vutoan1110/RISC-V-Cache4KB/results/dm_reset_phase_hypothesis_20261010.md

# Current-gold reset phase bridge hypothesis

One hypothesis: once a settled reset establishes the recorded joint invariant `I(Q)`, that invariant is preserved across every reachable sampled synchronizer phase, including arbitrary external-reset deassertion and reassertion between completed clock steps of the exact raw gold Boolean model.

Let `m=lec_q_p19088`, `s=lec_q_p19089`, and `R(m,s) = (not s) OR m`. The reachable phase relation is `00`, `10` or `11`, with either value of sampled external `reset_n`. Check all six phases independently. The raw transition must prove `Dmeta=reset_n` and `Dsync=reset_n AND m`, without any joint-state premise. Those equations preserve R and map every starting synchronizer state to `00` after an asserted-reset sampled edge. A second sampled asserted edge uses the already universal, independently reviewed gold reset base to establish I. No unreset RAM, tags or register array is zero-initialized as an assumption.

For each reachable phase, I(Q) is exactly the frozen conjunction of 235 constant constraints, 28 duplicate equalities and four legal one-hot groups. All other raw Q and primary inputs remain arbitrary symbols. Prove all 235 constant closures, 28 duplicate closures and 23 legal-current-code group closures under that phase and I(Q). Each premise has an explicit satisfying assignment; witness completion with zero is not a state axiom. Current `01` is excluded only after the stated reset protocol has established R, not treated as an impossible power-on state without reset.

An interrupted reset may switch the sampled external reset value on every step. Closure of all six phases and R therefore covers any sampled reassertion/release sequence after the established base. This is a completed-clock-step statement about the existing Boolean graph after its recorded frontend transformations. It does not prove RTL asynchronous-reset events occurring between clock edges, X/Z initialization semantics, raw N1/final reset coupling, mapped boundary equivalence or full sequential LEC; those scopes remain OPEN.

The new proof process has a kernel-enforced 512 MiB limit. Each obligation has a 10-second deadline. Use only the frozen structural cofactor and exact CNF/resolution-certified solver, with its fixed variable/clause/decision/conflict/learning/resolution budgets. Limits are UNKNOWN. No model, RTL, frozen helper, live PD input, global setting or external frontend changes. Controls precede two independent CLI executions and include an actual raw-model rare 24-input synchronizer fault whose witness satisfies every joint premise. Independent review is required before promotion.
