vutoan1110/RISC-V-Cache4KB/results/m2/M1_M2_REPORT.md

# Review items M1 and M2: controller confound and cache design-space sweep

Status 2026-10-06: every sweep number is double-executed -- R15 sweep pass 2 = pass 1 on every field (637/637
rows), R16 FAST_HIT sweep pass 2 = pass 1 (559/559 rows; no R16 checker message in any of the 1,131 FAST logs).
The R16 verification chain (45 checks, 0 failures), the formal checks (29, 0 failures) and Quartus x2 (9 fits,
pass 1 = pass 2) are complete (section 6). Final.

Numeric source: `results/m2/M1_M2_analysis.md` (generated by `scripts/m2/analyze_m2.py` from
`results/m2/sweep_p1.csv` and `results/m2/sweep_fast_p1.csv`). Every ratio is mcycle (total cycles), geometric
mean (GM) over the 12 upstream Embench-IoT kernels unless stated; CoreMark is reported on its own.

CoreMark validation boundary: these are repeatable full-program simulation counters with 32 KiB RAM, including
initialization and reporting. The harness does not gate PASS on upstream CRC validation; CoreMark comparisons
remain provisional functional evidence and are not official scores. Details: NHAT_KY.md section 9.

## 1. What the review asked

- M1: the published comparison (direct-mapped wins on 12/12 kernels) compares two different controllers. The DM
  point uses a five-state controller; SA2 and DM_VC4 use a ten-state DSE core whose main-array hit costs one
  extra cycle (ST_LOOKUP -> ST_HIT_RESP / ST_CPU_RESP). Controller cost must be separated from organisation.
- M2: one capacity and one line size is not a design space. Sweep capacity, line size, associativity and victim
  depth.

## 2. Method

- RTL: R15 (manifest d409b09d) for the base sweep; R16 (manifest c09143ea; hdl identical to ea3ef852) adds a
  parameter FAST_HIT to the DSE and N-way cores. With FAST_HIT = 1 a main-array hit is answered in ST_LOOKUP,
  so the DSE core's hit latency equals the DM controller's. FAST_HIT = 0 (default) is proved equivalent to R15
  (section 6).
- Organisations: DM (CACHE_CONFIG 0, five-state controller), DM_DSE (3: the DSE core used as a plain
  direct-mapped cache), SA2 (1), DM_VC4 (2, victim buffer), SA4 (4, N-way core, PLRU). Capacity = sets x ways x
  line bytes, identical for every organisation at a point.
- Grid (`scripts/m2/run_m2_sweep.py`): A = capacity 256 B .. 8 KiB x {DM, DM_DSE, SA2, VC4, SA4}, 16 B lines;
  B = 1 and 4 KiB x lines 8 / 32 B x {DM_DSE, SA2, VC4, SA4} (the DM controller supports 16 B lines only);
  C = 1 and 4 KiB x victim depth 2 / 8. 50 points x 13 workloads = 650 runs (R15); 44 points x 13 = 572 runs
  with FAST_HIT (DM has no FAST variant). SA4 at 256 B does not elaborate (4 sets < the L0's 3 index bits).
- Workloads: the 12 upstream Embench-IoT kernels (fw/up_*.hex) and CoreMark, BP on, L0 8 entries, RAM 16 KiB for the
  kernels. CoreMark runs in simulation with a 32 KiB backing RAM (IMEM_DEPTH = DMEM_DEPTH = 4096 words; `sw/coremark/coremark_link.ld` puts the stack at the top of 32 KiB): its -O2 rv32i_zmmul build needs .text 13,952 + .rodata 2,445 + .data 24 + .bss 2,020 bytes plus a 1 KiB stack, about 19.4 KiB, which does not fit the 16 KiB RAM. Caches and every other parameter are those of the 16 KiB SoC and the RAM latency does not depend on its depth, so the comparison between configurations is unaffected; CoreMark cannot run on the 16 KiB chip. (Correction 2026-10-08: this line said RAM 16 KiB for CoreMark too.)
  Every run passes the harness self-check and the counter invariants (exclusive hit/miss accounting).
- Every measurement twice (independent executions, separate log trees), compared field by field.
- Cross-check: the 4 KiB / 16 B rows of the sweep reproduce the frozen R15 chain results (65 rows, every field).

## 3. M1: the controller cost is real and grows with capacity

R15 decomposition, Embench GM (negative = faster):

| capacity | controller DM_DSE / DM | SA2 / DM_DSE | SA4 / DM_DSE | VC4 / DM_DSE | published-style SA2 / DM |
|---:|---:|---:|---:|---:|---:|
| 256 B | +4.33 % | -5.29 % | n/a | +5.97 % | -1.19 % |
| 512 B | +5.58 % | -6.75 % | -8.64 % | +4.53 % | -1.55 % |
| 1 KiB | +6.93 % | -2.98 % | -4.78 % | +3.32 % | +3.74 % |
| 2 KiB | +8.86 % | -0.70 % | -1.44 % | +2.10 % | +8.10 % |
| 4 KiB | +9.83 % | -0.26 % | -0.07 % | +1.03 % | +9.55 % |
| 8 KiB | +10.83 % | -0.16 % | -0.17 % | +0.01 % | +10.65 % |

The extra hit cycle costs more as the cache grows, because hits dominate once misses are rare. At the published
4 KiB point the controller accounts for +9.8 % and the organisation for -0.3 %: "DM beats SA2" was a controller
result. Below 1 KiB set associativity wins even on the slower controller.

R16 removes the extra hit cycle. Residual difference DM_DSE_fast vs DM: +1.09 % (256 B), +0.79 %, +0.15 %,
+0.11 %, +0.01 % (4 KiB), 0.00 % (8 KiB); cycle-identical on 5, 6, 9, 9, 12 and 13 of 13 workloads. The residual
is in the D-cache only (the two D$ controllers differ in the L0 and in store-miss handling: d_main / d_miss differ,
every I$ counter is equal), e.g. up_matmult-int at 4 KiB: 6 more D$ misses, +0.096 %.

Organisation on ONE controller with DM's hit latency, GM(X_fast / DM_DSE_fast):

| capacity | SA2 | SA4 | VC4 | CoreMark SA2 | CoreMark SA4 | CoreMark VC4 |
|---:|---:|---:|---:|---:|---:|---:|
| 256 B | -5.74 % | n/a | +5.99 % | -1.01 % | n/a | +2.23 % |
| 512 B | -7.43 % | -9.51 % | +4.61 % | -2.72 % | -3.99 % | -0.19 % |
| 1 KiB | -3.39 % | -5.56 % | +3.29 % | -1.18 % | -1.20 % | +0.31 % |
| 2 KiB | -0.86 % | -1.70 % | +2.04 % | -0.67 % | -0.71 % | +0.21 % |
| 4 KiB | -0.28 % | -0.09 % | +1.07 % | -0.53 % | -0.56 % | +0.17 % |
| 8 KiB | -0.18 % | -0.20 % | -0.01 % | -0.33 % | -0.33 % | +0.12 % |

With the controller matched, set associativity is faster than direct mapping in the GM at every capacity, on
Embench and on CoreMark; the gain is large below 2 KiB (3-10 %) and small at 4-8 KiB (0.1-0.6 %).

The GM hides large per-kernel effects in both directions. FAST orgs vs DM, wins / ties / losses over 13 workloads:
SA2 9/0/4 (256 B), 10/0/3, 7/0/6, 6/2/5, 6/4/3 (4 KiB), 3/9/1 (8 KiB); SA4 10/0/3 (512 B), 8/0/5, 7/2/4,
8/4/1, 4/9/0; VC4 3/0/10 ... 5/4/4 (4 KiB). At 4 KiB: up_nettle-sha256 +16.2 % (SA2) / +22.1 % (SA4), because
its instruction loop thrashes under LRU (I$ misses 3,414 DM -> 4,773 / 5,263); up_statemate -8.9 % (I$ misses
611 -> 2); up_matmult-int -4.5 / -4.7 %; up_ud -2.6 %. A paper statement must therefore be per-workload, not
"X beats Y".

## 4. Why DM_VC4 loses although it misses less

VC4 has the lowest miss rates of all organisations (e.g. 256 B: I$ 4.02 % vs 4.66 %, D$ 26.8 % vs 34.2 %, AXI
read beats -26 %) yet is the slowest. The cores copy the evicted line into the victim buffer BEFORE the refill
starts, one word per state (I$: ST_EVICT_READ + 4 x ST_EVICT_WRITE, about 5 cycles; D$: READ/WRITE per word,
about 8 cycles), on every miss to a valid line, and a victim hit pays a swap of the same length. Measured at 256 B
(FAST data, sums over 12 kernels): the I$ converts 8,632 misses into victim hits but its stall cycles grow by
278,890; the D$ converts 20,919 misses and its stall cycles are flat (+2,080). The I$ sees few victim hits per
miss, the D$ many. up_nettle-sha256 at 4 KiB has zero victim hits and the same 3,414 I$ misses as DM, and runs
+17.9 % slower: that is the eviction cost alone. This is a property of this micro-architecture (eviction
serialised with the refill instead of overlapping the AXI latency), not of victim caches in general.

## 5. M2: line size and victim depth

Line size, vs 16 B at the same capacity (Embench GM; CoreMark in brackets):

| capacity | org | 8 B, R15 controller | 8 B, FAST | 32 B, R15 controller | 32 B, FAST |
|---:|---|---:|---:|---:|---:|
| 1 KiB | DM_DSE | +19.18 % | +11.96 % (+1.53) | -2.47 % | +1.02 % (-0.31) |
| 1 KiB | SA2 | +20.87 % | +13.57 % (+1.78) | -4.97 % | -1.51 % (-0.93) |
| 1 KiB | SA4 | +20.46 % | +12.88 % (+1.74) | -6.55 % | -3.16 % (-0.91) |
| 1 KiB | VC4 | +20.03 % | +12.99 % (+1.66) | -1.34 % | +2.19 % (-0.49) |
| 4 KiB | DM_DSE | +21.54 % | +12.51 % (+1.61) | -8.64 % | -4.77 % (-0.88) |
| 4 KiB | SA2 | +21.81 % | +12.80 % (+1.66) | -9.18 % | -5.40 % (-1.00) |
| 4 KiB | SA4 | +21.90 % | +12.90 % (+1.67) | -9.21 % | -5.44 % (-1.00) |
| 4 KiB | VC4 | +21.49 % | +12.50 % (+1.70) | -8.58 % | -4.74 % (-0.98) |

32 B lines are better than the published 16 B at 4 KiB for every organisation (-4.7 to -5.4 % with the matched
controller); 8 B lines are clearly worse. The controller confound also distorts line-size conclusions: with the
extra hit cycle the 8 B penalty looks almost twice as large (+19-22 % instead of +12-13 %), because shorter lines
make the 8-entry L0 cover fewer bytes, so more accesses pay the main-array hit.

Victim depth (FAST, vs VC4): VC2 +2.58 % (1 KiB) / +0.23 % (4 KiB); VC8 -1.34 % / -0.45 %; CoreMark within
+/-0.33 %. Depth matters little next to the eviction cost of section 4.

Miss rates, AXI traffic and CPI for every organisation and capacity: `results/m2/M1_M2_analysis.md`.

## 6. Verification of the R16 change (rule D: the whole chain)

- Formal (Yosys equiv_make / equiv_simple -seq 2 / equiv_induct / equiv_status -assert, `asic/equiv/r16_eq`):
  icache and dcache x CACHE_CONFIG 1-4 x LINE_COUNT 64 / 256 with FAST_HIT 0 vs R15: 16/16 equivalent, 0
  unproven cells; negative controls FAST_HIT 1 (cfg 1 and 4, both caches, both sizes): 8/8 detected (66 unproven
  cells: rsp_valid and rsp_data of wrapper and core). SoC level, the exact PD inputs (R14 snapshot file lists)
  vs R16 at FAST_HIT 0: DM 35,067 / SA2 36,741 / DM_VC4 37,441 cells, all proven, 0 unproven -- the signed-off
  DM layout and every SA2 / DM_VC4 PD run represent R16 unchanged. (A first SoC attempt paired no cache register
  -- R15+ names the DSE core genblk1.g_dse, R14 g_dse -- and was stopped; the gate is now renamed, names only.)
  SoC negative control (SA2, FAST_HIT 1): after the same equiv_simple stage at which the FAST_HIT 0 proof was
  complete, 1,824 of 36,741 cells stay unproven.
- Sim-only per-cycle checker in each of the four cores; liveness shown by mutation: forcing a wrong recorded
  answer stops the simulation in 4/4 cores.
- New directed tests: tb_cache_configuration with FAST_HIT (incl. the SA2 main-hit latency: 1 cycle after the
  accepting edge without FAST_HIT, 0 with it), tb_cache_architecture_equivalence with FAST_HIT (SA2 / DM_VC4
  retire exactly what DM retires). Regression 161 PASS x2 (129 R15 + 32 FAST).
- Static: latch sweep 0 latches over 33 combinations (6 configs x 3 sizes x FAST_HIT 0/1 where it exists),
  lint_rtl 0 correctness warnings (33), lint_asic 0, OpenLane lint baseline 0 new warnings (R16 set == R15 set).
- Full chain (`scripts/run_fullchain_r16.sh`, `results/fullchain_r16.log`, 2026-10-06 09:54-15:14): 45 OK, 0 FAIL --
  manifest c09143ea identical at start and end; Embench 72 x2 and CoreMark 6 x2 identical to R15 on every field
  (FAST_HIT 0); FAST_HIT 60 + 5 runs x2, every non-timing counter equal to FAST_HIT 0, mcycle never larger (GM
  -8.9 to -9.0 % Embench, -2.5 to -2.6 % CoreMark at 4 KiB); random differential 50/50 x2 = R15 hashes; ASIC view
  x2 = R15, directed ISA 6/6, synchronisers x2; ramsweep x2; UVM 5/5 x2 and AXI 8/32/64 B x2; independent cache
  model EXACT on 48 + 24 runs (FAST_HIT 0) and 60 runs (FAST_HIT 1). Quartus x2 with the FAST points
  (`scripts/run_le_r16.sh`): 0 failures, pass 1 = pass 2 on all 9 fits (section 7).

## 7. Limits and open points

- FAST_HIT cost on the FPGA (Cyclone IV E, Quartus seed 2, pass 2 = pass 1 on every field of all 9 fits), FAST_HIT 0 -> 1:
  SA2 +456 LE, Fmax Slow-85C 53.71 -> 51.65 MHz (-3.8 %), +5.4 mW; DM_VC4 +115 LE, 54.90 -> 55.35 MHz, +3.6 mW;
  DM_DSE +345 LE, 53.69 -> 52.47 MHz (-2.3 %), +4.9 mW; SA4 +881 LE, 50.95 -> 52.76 MHz, +11.2 mW. Every point
  still closes 50 MHz at Slow 85C (worst setup slack +0.639 ns, SA2). One seed only: the R14 four-seed sweep put
  seed noise at up to 109 LE, and Fmax moves by a few percent between seeds, so only the SA2 / DM_DSE Fmax drops
  and the LE increases are likely real. At the fixed 50 MHz clock the cycle gains of section 3 are kept in full;
  at each point's own Fmax, SA2's -9.0 % cycles at 4 KiB shrink to about -5.3 % time (0.9103 x 53.71 / 51.65 = 0.9466). The FAST_HIT 0 points are
  identical to the R14 / R15 fits on all 115 recorded fields (runtime excepted). No ASIC build of a FAST point.
- The residual DM vs DM_DSE_fast difference (D$ L0 / store-miss policy) is not removed; it is <= 1.1 % and
  vanishes at 4-8 KiB.
- VC4's eviction is serialised with the refill; overlapping it with the AXI latency is the obvious fix and is not
  implemented.
- Single-issue in-order core, one memory system, 13 workloads; simulation only (no board available).
