vutoan1110/RISC-V-Cache4KB/report_page/soc_report.html

SoC RISC-V RV32I + Zmmul · Cyclone IV E (DE2-115) · sky130A

# Báo cáo tiến độ SoC RISC-V

So sánh bản nghiên cứu hiện tại với bản đã công bố: lỗi đã sửa, kiểm chứng, FPGA, hiệu năng, ASIC, cách đo từng phần và các phản biện còn mở. Viết cho người tham gia viết bài, để đọc độc lập mà không cần hỏi lại.

Cập nhật14/10/2026, 21:30 (giờ máy chạy)

Bản đã công bốE:\Projects\RISCV-AHB-APB-UART, commit a939d6f, GitHub vutoan1110/RISCV-AXI-APB-CACHE

Bản nghiên cứuE:\Projects\RISCV-research, nhánh experimental-r14, RTL R16 + register file và BHT trong M9K (manifest 6c4ccffd); PD: các bản đã ký đọc snapshot rtl_r14 (tương đương R16 với FAST_HIT 0); từ 14/10 21:12, theo quyết định của chủ dự án, mọi run PD đọc snapshot 6c4ccffd (rtl_rfbht)

Quy ước sốDấu chấm thập phân và dấu phẩy hàng nghìn, giống file nguồn tiếng Anh, để chép thẳng vào bài.

## 01Tóm tắt

Dung lượng

1 → 4 KiB

Cache mỗi phía; RAM chính 8 → 16 KiB. Thêm một quét không gian thiết kế 256 B đến 8 KiB.

Lỗi của bản cũ đã sửa

8

Gồm wrapper RAM của ASIC ghi sai địa chỉ, và vi phạm hold bị che vì lỗi SDC.

Kết luận "DM nhanh nhất"

+9.8 %

Phần chênh ở 4 KiB đến từ controller, không đến từ cách tổ chức cache. Khi khớp độ trễ hit, set-associative nhanh hơn ở mọi dung lượng.

FPGA, DM

−15.6 % LE

So với bản cũ 1 KiB (seed 2: 15,188 → 12,815 LE) dù cache lớn gấp 4: register file và BHT chuyển vào M9K, CPI không đổi. Mười seed chung × hai lượt: DM 12,800–12,842 LE, Fmax 52.27–56.18 MHz (Slow 85 °C).

ASIC đã ký: DM và SA2

2 / 3

DM 10.63 mm², SA2 11.56 mm²: DRC, LVS, XOR, antenna 0, setup ≥ 0 ở tt và ff, hold ≥ 0 ở 9 góc. DM_VC4 chưa ký.

Phản biện

10 / 20

10 đã giải quyết, 4 một phần (A2, A7, A9, m1), 6 chỉ còn việc viết bài.

Hạng mục | Trạng thái | Ghi chú ngắn
RTL, kiểm chứng, FPGA ở 4 KiB | Đã xong | Chuỗi đầy đủ 0 lỗi, mọi phép đo ×2. Mục 7, 8.
Quét không gian thiết kế (M1, M2) | Đã xong | 637 + 559 dòng, lần 2 trùng lần 1. Mục 10.2.
FPGA 10 seed chung × 2 lượt | Đã xong | 40 cặp dòng trùng 115 trường phần cứng. Mục 9.2.
Board DE2-115 | Một phần | 42 / 100 ca đo, tất cả khớp hai lượt tham chiếu RTL; còn 58 ca. Mục 12.9.
ASIC DM | Đã ký | 10.63 mm²; công suất exact-window 119.45 mW; LEC chứng minh, mọi tiền đề đã đóng. Lần chạy trọn nghiệm thu theo quy tắc Q: r3 dừng ở P2 vì crash ngẫu nhiên của tiến trình OpenLane; r4 (bản R14) dừng khi chủ dự án chuyển PD sang RTL 6c4ccffd; lần nghiệm thu DM trên 6c4ccffd chạy từ 14/10 21:12. Mục 11.1, 11.5.
ASIC SA2 | Đã ký | 11.56 mm²; công suất exact-window 129.64 mW; LEC hai lượt trùng nhau + mọi đối chứng âm. Cần lần chạy trọn nghiệm thu trên RTL 6c4ccffd (E1 hoặc E0). Mục 11.3.
ASIC DM_VC4 | Chưa ký | Route chính về 0 vi phạm nhưng vòng sửa antenna sau route không hội tụ; die 3800 µm (V4) cũng không giúp, đã dừng. Làm sau (chủ dự án) trên RTL 6c4ccffd với floorplan riêng. LEC phần tổng hợp (bản R14) xong hai lượt. Mục 11.4.
Viết lại bài (M3, A5, m2, m3, m6, m8) | Còn mở | Không thuộc phần đo đạc. Mục 14.

## 02Thuật ngữ

Các tên dưới đây xuất hiện trong mọi bảng. Tên cấu hình giữ nguyên như trong code và file kết quả.

DM

Cache ánh xạ trực tiếp, controller 5 trạng thái (CACHE_CONFIG 0).

SA2 / SA4

Set-associative 2 way / 4 way (1 / 4). SA2 chạy trên core DSE, SA4 trên core N-way (thay thế PLRU). SA4 chỉ có ở FPGA và mô phỏng.

DM_VC4

Ánh xạ trực tiếp kèm victim buffer 4 entry, chạy trên core DSE (2). Có một victim buffer ở I-cache và một ở D-cache.

DM_DSE

Core DSE dùng như cache ánh xạ trực tiếp thường (3). Dùng để tách chi phí controller ra khỏi cách tổ chức cache.

Core DSE

Controller 10 trạng thái dùng chung cho SA2, DM_VC4, DM_DSE. Mặc định mỗi hit ở mảng chính tốn hơn DM một chu kỳ.

FAST_HIT

Tham số mới CACHE_FAST_HIT (mặc định 0, tương đương RTL cũ). Bằng 1 thì core DSE và N-way trả lời hit ngay ở ST_LOOKUP, cùng độ trễ với DM.

L0

Bộ đệm nhỏ 8 entry ở I-cache, giữ các dòng vừa dùng.

View FPGA / ASIC / GLS

View FPGA: RTL với bộ nhớ FPGA, dùng để so sánh tổ chức cache. View ASIC: RTL với model SRAM OpenRAM, số chu kỳ thật của chip, ít hơn view FPGA 3–4 %. GLS: mô phỏng netlist đã ký tên, khớp view ASIC đến từng chu kỳ.

Góc tt / ff / ss

Typical 25 °C 1.80 V / fast −40 °C 1.95 V / slow 100 °C 1.60 V. Mỗi góc có 3 mức RC: min, nom, max, tổng 9 góc. Giới hạn ký tên: setup ≥ 0 ở tt và ff, hold ≥ 0 ở cả 9 góc. Góc ss chỉ báo cáo, không làm cổng.

LE

Logic element của Cyclone IV E. Mức 20,000 LE là mục tiêu mềm tự đặt.

DRC / LVS / antenna

Kiểm tra luật layout / so layout với netlist / hiệu ứng ăng-ten khi chế tạo. Bản ký tên phải bằng 0 ở cả ba.

V0–V5, E0 / E1, r14F, final3, ecomaxmin

Tên ngắn của các run PD, xem mục 03 Phiên bản và tên gọi.

LEC

Chứng minh hình thức rằng netlist cổng (sau tổng hợp và sau route) có cùng chức năng với RTL. Ở đây là LEC ánh xạ thanh ghi: so hàm trạng thái kế của từng flop đã ghép tên và mọi output.

N1

Netlist trung gian trước bước ABC của Yosys, tái tạo lại tiến trình tổng hợp của OpenLane trùng từng byte. Chuỗi chứng minh là RTL = RTL + fsm = N1 = netlist cuối.

Công suất theo hoạt động

GLS ghi lại hoạt động chuyển mạch thật (SAIF), rồi OpenSTA tính công suất với ký sinh RCX. Khác với "ước lượng của flow" (giả định tỉ lệ chuyển mạch mặc định).

SAIF

File hoạt động chuyển mạch (số lần chuyển mạch, thời gian ở 0 / 1 của từng net) ghi từ mô phỏng netlist.

Exact-window

Cửa sổ ghi SAIF dài đúng mcycle × 20 ns của vòng đo, mở / đóng bằng tín hiệu đóng băng bộ đếm đã chứng minh trên chính netlist.

EPI

Năng lượng mỗi lệnh = công suất × thời gian / số lệnh (minstret).

Chạy 2 lần (x2)

Mọi phép đo chạy độc lập hai lần và so từng trường. Lý do: có sai sót ngẫu nhiên không tái hiện; hai lượt độc lập trùng nhau mới dùng số.

Sàng lọc

Chạy thử một bước hoặc một phần để chọn giả thuyết; không phải kết quả.

Quy tắc Q

Sửa ngày 14/10/2026. Khi phát triển, được sửa và chạy tiếp từ bước lỗi; kết quả chỉ được nhận sau một lần chạy trọn từ bước 1 (không resume, không tách nhánh, ngưỡng khai báo lúc khởi chạy).

## 03Phiên bản và tên gọi

Mỗi tầng của dự án (RTL, phần mềm đo, FPGA, board, ASIC, LEC, công suất) có nhiều phiên bản; mỗi phiên bản đổi một điểm và có vấn đề riêng. Bảng dưới là tên thống nhất dùng trong trang, kèm tên gốc trong log / thư mục để tra cứu.

Trạng thái: đang dùng / đã ký đang chạy trượt / bỏ chuẩn bị. Chữ thường "lịch sử" là bản cũ, chỉ để tra cứu.

### 3.1 Quy ước

- Bản RTL gọi bằng 8 ký tự đầu của tổng SHA-256 manifest (scripts/rtl_manifest.py), ví dụ 6c4ccffd. R7…R16 là số đợt sửa trong nhật ký; một đợt có thể có nhiều manifest.
- PD chỉ đọc snapshot RTL đóng băng, không đọc hdl/. Các bản đã ký (r14F, ecomaxmin) và mọi run tới 14/10 đọc asic/snapshots/rtl_r14 (manifest 3ea52396). Từ 14/10 21:12 (quyết định của chủ dự án) PD đọc asic/snapshots/rtl_rfbht = manifest 6c4ccffd, đã kiểm trùng từng byte với cây mã hiện tại (44 file, hai lượt); tên run có mảnh rtl6c4c.
- Tên run PD: <cấu hình>_<floorplan>_<knob…>_r<n>; cấu hình dm / sa2 / vc4 (= DM_VC4). _r1 / _r2 = hai lần chạy độc lập cùng công thức (chạy kép); _r3 trở lên = chạy lại sau khi lần trước dừng.
- Tên ngắn: final_A/B, final3_A/B, r14F_A/B (DM); ecomaxmin, E0, E1 (SA2); V0–V5 (DM_VC4). Hậu tố A / B của run cũ = _r1 / _r2; "phương án A / B" của floorplan hành lang là 11.305 / 11.56 mm², không liên quan.
- Thư mục kết quả: results/<nội dung>_<YYYYMMDD>; p1 / p2 = lượt 1 / lượt 2.

### 3.2 Đọc tên run PD

Mảnh tên | Nghĩa
grid3665x2900, grid2800x2900 | Floorplan lưới của DM, die rộng × cao (µm)
ram8k | Bản RAM chính 8 KiB (trước 29/09)
corr3400x3400 | Floorplan hành lang dùng chung cho DM / SA2 / DM_VC4: hai hàng macro RAM ở dưới, macro mỗi cache thành cụm 2 × 2, dải logic ở giữa
f220 | Hàng macro cache phía trên lật (FS), khe 220 µm giữa hai hàng
capm20 | Biên tải khi sửa DRV sau global route 20 % (công thức DM: 50 %)
fo16 | MAX_FANOUT 16 (công thức DM: 8)
pad1 | Padding cell 1 site mỗi bên khi đặt cell
tdp | Đặt cell theo timing (PL_TIME_DRIVEN)
clkm3 | Dây clock chỉ dùng met3 trở lên
rsztf | Resizer chỉ tối ưu ở góc tt và ff, không đuổi theo ss
ecomin / ecomaxmin | ECO hold sau route trên ký sinh min_* / hai lượt: max_* rồi min_*
cts25 | CTS_SINK_CLUSTERING_SIZE 25 (mặc định OpenLane; DM dùng 8)
antoff | Tắt sửa antenna ở global route (chỉ sửa sau detailed routing)
antm10, antgrt10 | Sửa antenna ở global route, biên 10 %
nogrtt / nogrtd | Tắt sửa timing / sửa DRV sau global route
antcong | Cho phép nghẽn khi route lại trong vòng sửa antenna sau detailed routing; lưu kết quả route chính
mwl500 | Giới hạn dây 500 µm khi sửa DRV (mặc định resizer tự chọn 4,393 µm)
seco / secott | Thử ECO setup sau route (đã bỏ)
heurdiode / drtant | Diode chèn theo heuristic (cách cũ) / sửa antenna sau detailed routing
rtl6c4c | Đầu vào RTL là 6c4ccffd (snapshot rtl_rfbht); run không có mảnh này đọc rtl_r14

### 3.3 RTL

Tên | Ngày | Thay đổi | Vấn đề / kết quả | Trạng thái
Bản công bố 1 KiB | 16/09 | Repo công khai RISCV-AXI-APB-CACHE: cache I/D 1 KiB, RAM 8 KiB, chỉ FPGA, kernel tự viết | 8 lỗi (mục 05) | tham chiếu
1 KiB nghiên cứu (tên file cũ dedup / synccache / tagfix / sanitized) | 16–18/09 | Tham số hóa LINE_WORDS, lint Verilator -Wall, tag RAM đồng bộ cho cả 4 cache để đưa vào SRAM, PERF_COUNTERS_ENABLE | Số ablation đầu tiên sai (đã sửa); ASIC 1 KiB lớn hơn và nghẽn global route | lịch sử
4 KiB đầu tiên | 18–24/09 | Cache 4 KiB trên macro OpenRAM 32 × 256, L0 của I$ 8 entry, 12 macro | 2 latch thật trong netlist (Verilator báo 0), lỗi SDC create_clock; run ch4kb_full bị bỏ vì bộ nhớ ASIC còn lỗi | lịch sử
aa8e32f9 → b82c2717 → c235dfb7 (rtlfix) | 24–25/09 | Bỏ 2 latch rx_block; read-enable cho bank DSE; lỗi ghi AXI (bresp) ghi nhận sticky; UART RXDATA trả byte cũ nhất; UART tôn trọng pstrb (APB4); một SoC top cho ASIC; view ASIC lần đầu bắt 3 lỗi bộ nhớ ASIC (không biên dịch được trên Questa, sai địa chỉ ghi khi AW và W cùng chu kỳ: 91 / 115 lệnh ghi, SRAM không giữ giá trị đọc) | PD rtlfix_c235: setup nom_tt −0.272 ns, hold trượt ở ss từ uart_rx / key1_n | lịch sử
a0c425f8 (R8, sau gọi R17) | 25/09 | Đồng bộ 2 flop cho uart_rx, key1_n và nhả reset | PD r8_a0c4: nom_tt −0.569 ns; tìm ra đường nửa chu kỳ từ SRAM (dout ra ở sườn xuống) | lịch sử
358cb660 (R7a + R7b + R8) | 25/09 | Viết lại bộ cộng fetch, một bộ nhân có dấu 33 × 33 thay ba bộ 32 × 32, chân nguồn macro; CPI không đổi (chứng minh SAT / mô phỏng) | PD r7r8_358c: lần đầu đạt tt ở 50 MHz (+2.190 ns); ss −11.2 ns | lịch sử
ecf4fc03 → d030ad12 (R9–R11) | 26/09 | Thanh ghi hóa giải mã (forwarding, kiểu load), bit valid riêng cho L0 (hot_mvalid), keep trên bộ đếm hiệu năng (chỉ ASIC); CPI không đổi | ss vẫn âm; keep làm Quartus +17 % LE nên chỉ giữ cho ASIC | lịch sử
e21ef330 → 8b163675 (R12, R12b) | 26/09 | FPGA dùng select mã hóa (−145 LE, DM_VC4 dưới 20,000 LE), ASIC giữ one-hot | RTL của bản DM RAM 8 KiB đã ký (final3) | đóng băng cho bản 8 KiB
R13a / R13b | 28/09 | Thử RTL cycle-exact cho ss / bộ nhân 2 tầng | PD xấu hơn (max_ss −9.930 ns) / +1.03 % chu kỳ | bỏ
R14: 535ec0f9 → 3ea52396, 9b868f10 | 29–30/09 | RAM chính 8 → 16 KiB (ASIC 8 macro RAM, tổng 16 macro), chuyển sang 12 kernel Embench-IoT gốc; 9b868f10 bỏ kernel tự viết | Snapshot rtl_r14 = đầu vào PD của các bản đã ký (DM 10.63 mm², SA2 11.56 mm²) và mọi run DM_VC4 tới 14/10 | đầu vào PD cũ (tới 14/10)
R15 d409b09d | 30/09 | Core N-way (SA4, pseudo-LRU dạng cây), CACHE_CONFIG 4 / 5 | SA4 chỉ FPGA / mô phỏng; chip DM chứng minh tương đương R14 | dùng cho quét M2
R16 ea3ef852 → c09143ea | 03/10 | Tham số CACHE_FAST_HIT (mặc định 0 = R15, chứng minh tương đương) | Dùng cho M1; PD trên rtl_r14 vẫn đúng với FAST_HIT 0 | dùng cho M1
dcbf3495 | 08/10 | Register file và BHT vào M9K (chỉ FPGA), lần đóng băng đầu | Chuỗi kiểm 46 OK / 1 FAIL (lint_asic SYNCASYNCNET trong checker mô phỏng) | thay bằng 6c4ccffd
6c4ccffd | 08/10 | Như dcbf3495, sửa checker BHT (chỉ phần translate_off) | Chuỗi đầy đủ 0 lỗi; −2,630 đến −2,680 LE; netlist ASIC không đổi (tổng hợp DM trùng từng byte R16) | RTL hiện tại 227 file; đầu vào PD từ 14/10 21:12 (snapshot rtl_rfbht)

### 3.4 Phần mềm đo và kiểm chứng

Tên | Thời gian | Đặc điểm | Trạng thái
12 kernel tự viết | đến 29/09 | Kiểu Embench do dự án viết (bản công bố dùng; phản biện A6) | bỏ 30/09
12 kernel Embench-IoT gốc (09c2ed8c) | từ 29/09 | aha-mont64, crc32, depthconv, edn, huffbench, matmult-int, md5sum, nettle-sha256, slre, statemate, tarfind, ud; nguồn giữ nguyên trừ móc chỉnh số vòng; không phải điểm Embench chính thức | đang dùng
CoreMark quét ngắn | 09–10/10 | -O2, 1 vòng, RAM mô phỏng 32 KiB, 92 điểm có CRC | xong ×2
CoreMark chuẩn | 11/10 | -Os, 1,100 vòng, > 10 s, timer APB, 4 cấu hình; RAM mô phỏng 32 KiB | xong ×2
Regression testbench | 24/09 → 08/10 | 128 → 129 → 161 → 178 kiểm tra, thêm theo từng bản RTL | 178 / 178 ×2 trên 6c4ccffd
UVM | → 09/10 | 5 ca → 48 ca mỗi lượt (thêm AXI stress, UART RX, 4 cấu hình) | xong ×2
ACT4 | 02/10, lặp lại trên 6c4ccffd | 43 test (39 RV32I + 4 Zmmul) | xong ×2
Random differential + Spike | 09–11/10 | 50 seed; tham chiếu Spike độc lập | xong ×2
Probe | – | cachesweep (điểm gãy độ kết hợp), conflict probe mở rộng, ramsweep (kiểm cả 8 bank RAM) | công cụ đo

### 3.5 FPGA và board

Tên | Ngày | Đặc điểm | Trạng thái
4 seed × 2 lượt | 25/09 → 06/10 | Trên c235dfb7 … R16 (DM R16: 15,440 LE) | lịch sử
4 seed (rfbht) | 09/10 | 6c4ccffd; DM 12,810–12,842 LE | thay bằng 10 seed
10 seed chung × 2 lượt | 09/10 | 6c4ccffd, seed 1..10 chung cho 4 cấu hình (số ở mục 09) | đang dùng
36 SOF | 16/09 | Thiết kế bản công bố | lịch sử, không dùng
100 SOF seed 2 | 09/10 | 6c4ccffd, 25 firmware × 4 cấu hình, bộ đếm kỳ vọng gắn hash từng SOF | 42 / 100 khớp phiên 13/10, còn 58

### 3.6 ASIC DM

Tên trong trang | Run / thư mục | Ngày | Đặc điểm | Vấn đề / kết quả | Trạng thái
DM 1 KiB | dm_c1k_baseline (sync_final) | 18/09 | Cache 1 KiB, RAM 8 KiB, die 5.22 mm² | SDC thiếu clock uncertainty / IO; đo lại hold âm | mốc lịch sử
Run thăm dò 4 KiB | ch4kb_full, rtlfix_c235, r8_a0c4, r7r8_358c, r9_ecf4, r10A | 19–26/09 | PD trên từng bản RTL của đợt sửa | Tìm ra đường nửa chu kỳ SRAM và cách đóng tt | lịch sử
final_A / final_B | dm_ram8k_grid2800x2900_heurdiode_r1 / _r2 (_r3) | 27/09 | Bản ký tên RAM 8 KiB đầu tiên, diode heuristic | Antenna còn 140 net / 159 chân | thay bằng final3
final2_A | dm_ram8k_grid2800x2900_drtant_rc2 | 27/09 | Thêm hiệu chỉnh RC (LAYERS_RC) | ss và hold xấu hơn | bỏ
final3_A / final3_B | dm_ram8k_grid2800x2900_drtant_r1 / _r2 | 28/09 | Bỏ diode heuristic, sửa antenna sau detailed routing | Ký tên sạch, die 8.12 mm², 302 metric trùng, LEC chứng minh | golden RAM 8 KiB
f3_H1 / f3_H2 | …_hold002 / …_dens55_hold003_cts8 | 30/09 | Giảm buffer hold / mật độ 55 % | Cell −13 % nhưng max_ss xấu hơn | không nâng
r14_A, r14_E7 … E16 | dm_grid3665x2900 + knob | 29/09 | Quét knob cho RAM 16 KiB | E16 = công thức ký tên (config_R14_FINAL) | thí nghiệm
r14F_A / r14F_B | dm_grid3665x2900_r1 / _r2 | 02/10 | RAM 16 KiB, 16 macro, die 10.63 mm² | Ký tên sạch, 319 metric trùng, netlist trùng; bị dừng khi phiên làm việc kết thúc (30/09) và chạy tiếp 02/10 nên chưa đạt quy tắc Q | bản DM hiện tại, khóa
DM hành lang (dmuA / dmuB) | dm_corr3400x3325_f220_r1 / dm_corr3400x3400_f220_r1 | 06–07/10 | DM trên floorplan chung với SA2 / DM_VC4 | Ký tên sạch | chỉ để đối chứng cùng die
r3 | dm_grid3665x2900_r3 | 14/10 | Lần chạy trọn nghiệm thu | Dừng ở P2: crash ngẫu nhiên của tiến trình OpenLane sau bước 40 | thay bằng r4
r4 | dm_grid3665x2900_r4 | 14/10 | Lần chạy trọn nghiệm thu, cùng công thức và cổng | Qua P1 / P2 (setup nom_tt +1.725, hold +0.186). Netlist và mọi số trùng r14F tới bước 42, nhưng ở bước 41 hai buffer (wire10760, wire10761) đổi hướng S / FS: OpenROAD chọn hướng theo thứ tự phụ thuộc địa chỉ bộ nhớ (hiện tượng đã thấy từ 25/09). Vì vậy bước 43 sửa antenna ra 350 net / 6,249 diode thay vì 322 / 6,262 và layout khác r14F từ đó. Nghiệm thu bằng cổng ký tên và so PPA, không so hash. Dừng ở cổng detailed routing (14/10 21:11) khi chủ dự án chuyển PD sang RTL 6c4ccffd | dừng, thay bằng bản 6c4ccffd
DM 6c4ccffd | dm_grid3665x2900_rtl6c4c_r1 | 14/10 | Công thức ký tên DM (config_R14_FINAL_rtl6c4c.json: chỉ đổi danh sách file sang snapshot 6c4ccffd) | Lần chạy trọn nghiệm thu từ bước 1 (từ 21:12); sau khi ký: GLS, công suất exact-window và LEC trên layout này | đang chạy

### 3.7 ASIC SA2

Tên trong trang | Run / thư mục | Ngày | Đặc điểm | Vấn đề / kết quả | Trạng thái
sa2F_A / sa2F_B | – | 02/10 | SA2 trên lưới DM | Không route được (overflow 67,971) | bỏ
Lưới rộng / vòng / tầng | – | 03/10 | Sàng lọc floorplan | Lưới rộng route được nhưng nom_tt −17.573 ns (skew clock) | bỏ
sa2uA / sa2uB | sa2_corr3400x3325_f220_r1 / sa2_corr3400x3400_f220_r1 | 06–07/10 | Floorplan hành lang, knob của DM | 3325: detailed routing kẹt 173 vi phạm; 3400: hội tụ sau 54 vòng (5 giờ 43 phút), sửa antenna sau route chậm | bỏ chuyển sang knob riêng
capm20 + fo16 | sa2_corr3400x3400_f220_capm20_fo16_r1 | 07/10 | Biên tải 20 %, MAX_FANOUT 16 | −27 % buffer sau global route | giữ trong các bản sau
10.54 mm² | sa2_corr3400x3100_…_pad1_tdp_clkm3_r1 (+ seco, secott, rsztf) | 08–09/10 | Die nhỏ nhất đã thử | Route được nhưng max_tt −0.573 ns (đường đọc nửa chu kỳ SRAM way 1 của I$) | trượt
11.05 mm² | sa2_corr3400x3250_…_rsztf_r1 / _r2 | 10/10 | – | Trượt P2 cả hai lần (setup −0.332 ns) | trượt
11.305 mm² | sa2_corr3400x3325_…_rsztf_r1 | 11–13/10 | – | Route sau ECO kẹt 24 vi phạm met1 / met2 rồi OpenROAD crash | đóng, trượt
rsztf_r1 / _r2 | sa2_corr3400x3400_f220_capm20_fo16_pad1_tdp_clkm3_rsztf_r1 / _r2 | 09/10 | 11.56 mm², resizer chỉ ở tt / ff | Gần sạch, chỉ hold ff −0.027 ns | nguồn của ecomaxmin
ecomin | …_rsztf_ecomin_r1 | 09/10 | ECO hold trên RC min | Hold ff xấu hơn (−0.116 ns) | bỏ
SA2 đã ký (ecomaxmin) | …_rsztf_ecomaxmin_r1 / _r2 | 09/10 | ECO hold hai lượt (max_* rồi min_*), die 11.56 mm² | Ký tên sạch, 319 metric trùng; tách nhánh sau bước 47 và vượt cổng p2 bằng CONTINUE nên chưa đạt quy tắc Q | bản SA2 hiện tại
E1 | …_rsztf_cts25_r1 … _r5 | 13–14/10 | Công thức ecomaxmin + CTS_SINK_CLUSTERING_SIZE 25 (cây clock nhẹ hơn), ECO hai lượt trong một bước | r1–r4 dừng (ba crash ngẫu nhiên, một lần thiếu RAM); r5: route và ECO xong, sign-off chạy lại từ bước 51 | đang làm
E0 | (chưa chạy) | – | Công thức ecomaxmin trong một flow (ECO hai lượt trong một bước, ngưỡng khai báo lúc khởi chạy) | Ứng viên nghiệm thu nếu E1 không thắng PPA | chuẩn bị

### 3.8 ASIC DM_VC4

Tên trong trang | Run / thư mục | Ngày | Đặc điểm | Vấn đề / kết quả | Trạng thái
vc4F_A / vc4F_B, vc4R1F_A, vc4S1 | – | 02–03/10 | Lưới DM, lưới rộng, vòng, tầng | Overflow hoặc timing âm (lưới rộng overflow 34,086; vòng nom_tt −1.093 ns; tầng overflow 233,074) | bỏ
vc4uA / vc4uB | vc4_corr3400x3325_f220_r1 / vc4_corr3400x3400_f220_r1 | 06–07/10 | Floorplan hành lang, knob DM | Route lại trong sửa antenna: overflow 19,114 / 11,485 | dừng
3600 / 3800 lần 1 | vc4_corr3600x3400_f220_r1 / vc4_corr3800x3400_f220_r1 | 07/10 | Die rộng hơn, knob DM | Overflow sau global route 5,774 / 10,627 | dừng
Các biến thể 11.56 / 11.90 mm² | capm20, capm20_fo16, capm20_antm10, antoff, antoff_rsztf, nogrtt, nogrtt_clkm3, nogrtt_clkm3_pad1, 3500 pad1 | 07–09/10 | Mỗi run đổi một knob | Trượt P1 / P2: cây clock đi vòng sau global route (FastRoute "hard benchmark"), hold âm tới −3.9 ns, overflow | dừng
3600 nogrtt / nogrtd | vc4_corr3600x3400_f220_capm20_antoff_nogrtt_r1 / _nogrtd_r1 | 09/10 | Tắt sửa timing / sửa DRV sau global route | nogrtt: P2 trượt (sửa DRV sau GRT route lại clock); nogrtd: detailed routing dừng ở vòng 10 (5,689 vi phạm) | dừng
V0 | vc4_corr3600x3400_f220_capm20_pad1_antoff_nogrtt_nogrtd_r1 | 10–11/10 | + padding 1 site | Route chính 0 vi phạm ở vòng 45 (18.5 giờ); antenna sau route 2,243 net; vòng sửa dừng ở GRT-0232 (global route không cho nghẽn) | trượt
V1 | …_pad1_antoff_nogrtt_nogrtd_antcong_r1 | 13/10 | V0 + cho phép nghẽn trong vòng sửa antenna, lưu route chính | Route chính 0; vòng sửa 1: 2,270 net, 5,920 diode, route lại 59,810 → 8,323 ở vòng 13, watchdog dừng | trượt
V2 | …_pad1_antgrt10_nogrtt_nogrtd_antcong_r1 | 14/10 | V1 + sửa antenna ở global route, biên 10 % | Route chính 0 ở vòng 31; antenna sau route 1,031 net; route lại sau 2,295 diode không hội tụ | trượt
V2 chạy lại (sàng lọc) | screen_drt_replay_v2_20261014 | 14/10 | Chỉ bước route của V2, không watchdog | Trùng V2 từng vòng, đứng ở 225 (vòng 43) | dừng
V3 | …_antgrt10_nogrtt_nogrtd_antcong_r2 | 14/10 | V2 + watchdog riêng cho vòng antenna | Dừng có chủ đích trước detailed routing (sẽ lặp lại V2) | dừng
V4 | vc4_corr3800x3400_f220_capm20_pad1_antgrt10_nogrtt_nogrtd_antcong_r1 | 14/10 | Công thức V2 trên die 3800 × 3400 (12.92 mm²) | P1 / P2 qua; route chính 0 ở vòng 34; antenna sau route 1,098 net (V2 1,031); route lại sau sửa antenna bám đúng V2 (vòng 18: 1,041; bản chạy lại V2: 1,019); chủ dự án dừng 14/10 21:01 | dừng
V5 | …_antgrt10_nogrtt_nogrtd_antcong_mwl500_r1 | 14/10 | V2 + giới hạn dây 500 µm | P2 trượt (23,680 buffer, setup −1.068 / hold −1.882 ns), antenna vẫn 873 net | trượt

### 3.9 LEC

Tên | Ngày | Đặc điểm | Vấn đề / kết quả | Trạng thái
EQY (bước có sẵn của OpenLane) | 25–28/09 | So tương đương theo partition | Không qua trên thiết kế này (795 / 876 partition; FAIL ở LCD_EN do FSM mã hóa lại) | thay bằng LEC tự xây
SEC có giới hạn (ABC) | 27/09 | Kiểm tuần tự | Tương đương 19 chu kỳ; không giới hạn: UNDECIDED | bỏ
LEC DM RAM 8 KiB | 27–28/09 | Chuỗi RTL = RTL + fsm = N1 = netlist cuối, chứng minh đại số bộ nhân | 19,881 output, 0 phản ví dụ | xong
LEC DM RAM 16 KiB | 09/10, tiền đề 13/10 | r14F_A / B, hai lượt | Đối chứng âm: 184 output SAT; tiền đề (reset bất đồng bộ, giá trị không xác định, one-hot, clock) đóng 13/10 | xong
LEC SA2 | 13–14/10 | ecomaxmin_r1 / _r2, lượt p1 và p2b | p2 dừng do crash ngẫu nhiên, chạy lại p2b; p1 = p2b; đối chứng and2 → or2: 60 output SAT | xong
LEC DM_VC4 (phần tổng hợp) | 14/10 | Lần a–d | a: lệch cổng vì 8 macro way 1 bị tổng hợp xóa → thêm sram_align.py; b: thứ tự cổng AIGER → sửa và tự kiểm; c: một kiểm tra phụ đặt quá chặt (lỗi kịch bản) → chỉ còn là thông tin; d: hai lượt trùng nhau | đang làm phần N1 = netlist cuối chờ layout

### 3.10 Công suất

Phép đo | Cách tính | Số | Dùng
Metric power__total của flow | Ước lượng ở góc max_ff | DM RAM 8 KiB 115.5 mW, SA2 137.0 mW; bản công bố 235.8 mW | không dùng để so sánh
Vectorless nom_tt | OpenSTA, hoạt động mặc định | DM 109.15 mW, SA2 121.99 mW | tham khảo
SAIF cũ | GLS, cửa sổ (mcycle + 1) × 20 ns | Lệch ≤ 0.005 mW mỗi kernel so với exact-window | thay bằng exact-window
Exact-window | GLS hai lượt, cửa sổ đúng mcycle × 20 ns, STA hai lượt | DM 119.45 mW, SA2 129.64 mW | số dùng
FPGA | Quartus Power Analyzer, toggle 12.5 % | Mục 09 | ước lượng, độ tin cậy thấp

### 3.11 Tài liệu cũ

Tên cũ | Nay là
HANDOVER_CODEX.md | PROJECT_STATE.md
FINAL_METRICS.md | RESULTS.md
CLAUDE_AUTONOMY_LOG.md, PD_incident_report.md, asic/FLOW_JOURNAL.md, "Incident N" | Các mục theo ngày trong NHAT_KY.md
G1–G6 | Tên cổng grt_overflow, cts_tt_slack, grt_repair_overflow, grt_tt_slack, drt_convergence, signoff (pha P1–P4)

## 04Phạm vi: bản cũ và bản mới

| Bản đã công bố | Bản nghiên cứu hiện tại
Cache I và D | 1 KiB mỗi phía, dòng 16 B | 4 KiB mỗi phía, dòng 16 B. Quét 256 B – 8 KiB, dòng 8 / 16 / 32 B, 1 / 2 / 4 way, victim 2 / 4 / 8.
RAM chính | 8 KiB | 16 KiB (tăng ngày 29/09: RAM, không phải cache, giới hạn bộ kernel chạy được)
Cấu hình | DM, SA2, DM_VC4 | DM, SA2, DM_VC4, DM_DSE, SA4; tùy chọn FAST_HIT
Workload | 12 kernel "kiểu Embench" tự viết | 12 kernel Embench-IoT gốc (commit 09c2ed8c, mọi kernel vừa RAM 16 KiB) và CoreMark. Đã bỏ kernel tự viết. Không phải điểm Embench chính thức. CoreMark chạy mô phỏng với RAM 32 KiB (xem 10.1, 10.4).
Đo thêm | Chu kỳ, phân loại chu kỳ, hit rate | Thêm độ trễ ngắt, thời gian chuyển ngữ cảnh, tác dụng của dự đoán nhánh, năng lượng mỗi lệnh.
ASIC | DM; cache 1 KiB trong flop; RAM 8 KiB trong 4 macro SRAM; die 5.22 mm² | DM: cache trong 8 macro SRAM, RAM trong 8 macro, 16 macro, die 10.63 mm² (đã ký). SA2: die 11.56 mm² (đã ký). DM_VC4: chưa ký.
Lặp lại phép đo | Một lần | Mọi phép đo hai lần, so từng trường; RTL đóng băng bằng manifest có mã tổng. LEC và công suất cũng hai lượt độc lập. Riêng board: một lượt vật lý, so với hai lượt mô phỏng RTL tham chiếu.

## 05Lỗi của bản đã công bố đã tìm và sửa

Đây là lỗi thật trong RTL hoặc ràng buộc của bản đã công bố (file tương ứng có trong repo đã công bố), không phải điều chỉnh. Mỗi lỗi có test hoặc bằng chứng đi kèm. Lỗi 1 nằm nguyên trong bản ASIC đã công bố: wrapper RAM ghi sai địa chỉ khi kênh địa chỉ và kênh dữ liệu ghi đến cùng chu kỳ.

# | Nơi | Triệu chứng | Hậu quả | Sửa và bằng chứng

1 | axi_ram_32_asic_macro.v | Địa chỉ ghi lấy từ thanh ghi cũ, không bypass khi AW và W đến cùng chu kỳ | nặng Mô phỏng với model SRAM: 91 / 115 lệnh ghi đi sai địa chỉ | Sửa; view ASIC 12 / 12 kernel PASS (trước đó 1 / 12, chỉ crc32 vì không có lệnh ghi)
2 | axi_ram_32_asic_macro.v | Dùng biến trước khi khai báo | Questa không biên dịch được, tức file chưa từng được mô phỏng | Sửa; nay nằm trong chuỗi kiểm chứng
3 | uart_apb.v | RXDATA không bao giờ trả byte vừa nhận | UART nhận sai | Trả byte cũ nhất chưa đọc; test mới tb_uart_apb (trước đó không test nào chạm UART ở mức thanh ghi)
4 | uart_apb.v | Bỏ qua pstrb | Vi phạm APB4: ghi 1 byte vào CFG xóa 3 byte còn lại | Sửa và thêm test
5 | Đường ghi AXI | m_axi_bresp bị bỏ qua | Lỗi ghi không được báo; test T19 cũ PASS mà không hề tiêm lỗi | Cờ wr_err và địa chỉ lỗi đầu tiên ở sysmon 0xAC / 0xB0; viết lại T19
6 | rx_block | 2 latch thật trong netlist (Verilator báo 0) | Hành vi không xác định | Nhánh default gán đủ đầu ra; quét latch bằng Yosys ở mọi tổ hợp cấu hình
7 | Wrapper FPGA và ASIC | uart_rx, reset, phím không được đồng bộ; false path trên reset_n che recovery/removal | Metastability | Bộ đồng bộ 2 flop; test wrapper mới (RTL cũ FAIL 4 và 10 trường hợp)
8 | soc.sdc | set clocks [create_clock ...] trả về rỗng | nặng clock uncertainty, transition và mọi ràng buộc I/O bị bỏ im lặng; 72 / 78 cổng ra không được kiểm | Sửa. Đo lại layout cũ với SDC đúng: setup tt +2.944 → +2.694 ns; hold ss +0.657 → −0.231, ff +0.186 → −0.064 ns

Hai việc khác cùng đợt: bản cũ có hai file top riêng cho FPGA và ASIC phải đồng bộ bằng tay (nay gộp làm một, lint báo lỗi nếu trùng module); và chuỗi kiểm chứng mới bắt được một lỗi trong code mới của chính bản nghiên cứu (bank dữ liệu cache trên SRAM không giữ giá trị đọc) trước khi đưa vào PD.

Ý nghĩa cho bài báo

Số liệu ASIC của bản đã công bố không dùng lại được: timing đo với SDC lỗi, hold âm ở ss và ff khi đo đúng, còn 646 vi phạm antenna, và wrapper RAM ghi sai địa chỉ (lỗi 1). Mọi số ASIC trong bài mới lấy từ mục 11.

## 06Đối chiếu với các hạn chế của bản gốc

Bản gốc tự ghi 10 hạn chế (docs/en/results/FINAL_RESULTS.md §10), phản biện thêm các góp ý nhỏ và các mục A1, A2. Bảng này cho biết từng mục đã sửa tới đâu trong bản nghiên cứu. Mỗi thay đổi RTL kéo theo toàn bộ chuỗi kiểm chứng; thay đổi chỉ cho FPGA (7.3) được chứng minh không đổi netlist ASIC nên không cần chạy lại PD.

# | Hạn chế hoặc góp ý (nguồn) | Bản gốc | Bản nghiên cứu | Trạng thái

1 | Tổ chức cache và độ sâu controller chưa tách (§10.1; phản biện M1) | Chưa làm | DM_DSE, FAST_HIT, quét 256 B – 8 KiB (mục 10.2) | Đã sửa
2 | Log CPI chạy trên board không lưu (§10.2.1; A7) | Chỉ lưu crc32 và 3 lần chạy probe | Phiên board 13/10: 42 / 100 ca đã đo, mọi bộ đếm khớp cả hai lượt tham chiếu RTL; còn 58 ca | Một phần
3 | Conflict probe chỉ đo một set với truy cập tuần hoàn (§10.2.2) | – | Probe mới (10.3): nhiều set, thứ tự ngẫu nhiên, đọc / ghi lẫn, 6 cấu hình, 4 KiB và 1 KiB, khớp mô hình độc lập 390 / 390 cửa sổ, hai lượt trùng nhau | Đã sửa
4 | Góc ss (§10.2.3) | max_ss −11.706 ns | max_ss −7.365 ns (DM RAM 16 KiB), −7.917 ns (SA2). Đóng hẳn cần thêm tầng pipeline, tức đổi CPI; chủ dự án quyết định không đổi CPI, chỉ báo cáo | Một phần
5 | Vi phạm antenna (§10.2.4) | 646 | 0 ở DM và SA2 (sửa antenna sau detailed routing), không tốn 18 % diện tích như bản gốc ước tính; DM_VC4 chưa đóng (11.4) | Đã sửa
6 | Magic DRC không dùng được, không chạy được XOR (§10.2.5) | Bỏ qua Magic; không có XOR | Magic DRC trên GDS với macro trừu tượng = 0; XOR = 0 | Đã sửa
7 | Chưa chế tạo (§10.2.6) | – | – | Bản chất
8 | Random differential (§10.2.7) | 1 seed | 50 seed × 2 trên mọi revision từ 23/09, có lưu trace; thêm tham chiếu Spike độc lập (100 lần Spike khớp cả 200 trace RTL) | Đã sửa
9 | ACT4 và RISCOF (§10.2.8) | Log không lưu; chưa chạy RISCOF | ACT4 43 / 43 × 2, log và signature đã lưu; RISCOF / Sail chưa chạy | Một phần
10 | Kernel tự viết (§10.2.9; A6) | 10 / 12 tự viết | 12 kernel Embench-IoT gốc + CoreMark (CoreMark mô phỏng với RAM 32 KiB) | Đã sửa
11 | Biên LE quá sát (§10.2.10) | DM_VC4 dư 118 LE | 10 seed chung × 2 lượt: DM 12,800–12,842; SA2 16,670–16,739; DM_VC4 17,096–17,148; DM_DSE 14,302–14,364 LE; dư khoảng 2,850 so với mục tiêu mềm 20,000 ở DM_VC4. SA4 và các điểm 8 KiB (chưa fit lại, còn flop) vượt | Một phần
12 | Vi phạm max-slew (góp ý nhỏ) | 8,718 | DM RAM 16 KiB ở nom_tt: slew 142, cap 298, fanout 1,428; SA2 ở nom_tt: slew 1,084, cap 1,036; báo cáo theo loại | Đã sửa
13 | Bảng seed bỏ seed 4 (góp ý nhỏ) | Seed 1, 2, 3, 5 | 10 seed chung 1 – 10 cho cả bốn cấu hình, ghép cặp theo seed, hai lượt trùng nhau | Đã sửa
14 | Bảng 6: ở N = 7 chỉ có 1 victim hit (góp ý nhỏ) | Chưa giải thích | Có lời giải thích ở dưới và số đo mới (10.3: thứ tự ngẫu nhiên không sụp); chưa đưa vào bài | Viết bài
15 | "Victim cache 59 % trên matmult" ở kết luận nhưng không có trong kết quả | – | Bỏ câu này hoặc thêm số liệu vào phần kết quả | Viết bài
16 | "Weighted CPI" chưa định nghĩa | – | Σ mcycle / Σ minstret, đã ghi trong RESULTS.md | Đã sửa
17 | Tiêu đề chỉ ghi "on FPGA"; từ khóa "posted store" | – | Sửa tiêu đề và từ khóa | Viết bài
18 | 11 mục hạn chế, nhiều mục là ghi chú nội bộ | – | Gộp lại; phần lớn đã có cách sửa ở bảng này | Viết bài
19 | Footnote GCC 14.2 và UB tại địa chỉ 0 | – | Chuyển vào README của artifact | Viết bài
20 | LE cao (A1) | – | Bảng theo module (9.3); register file và BHT chuyển vào M9K mà CPI không đổi: DM 15,440 → 12,815 LE (9.5) | Đã sửa
21 | Fmax khoảng 52 MHz; core trượt ss (A2) | 51.6 – 52.4 MHz | 51.02–56.18 MHz (10 seed × 4 cấu hình, RTL 6c4ccffd); ASIC DM và SA2 đóng tt và ff, ss vẫn âm; DM_VC4 chưa ký | Một phần
22 | Tương đương RTL – netlist | Không có | LEC chứng minh cho DM RAM 8 KiB, DM RAM 16 KiB (tiền đề đã đóng 13/10) và SA2 (14/10, hai lượt trùng nhau, đối chứng âm đủ); DM_VC4: phần chỉ phụ thuộc tổng hợp xong hai lượt | Đã sửa
23 | Related work (M3), caption hình 3 (A5) | – | Phần viết bài; xem câu chữ đề xuất ở dưới | Viết bài

Tổng 23 mục: 11 đã sửa, 5 sửa một phần, 6 thuộc phần viết bài, 1 bản chất (chưa chế tạo). Dòng 2 (log trên board) chuyển từ "cần board" sang "một phần" sau phiên board 13/10.

### Câu chữ đề xuất cho các mục viết bài

- Bảng 6, N = 7. Với truy cập tuần hoàn qua N dòng cùng ánh xạ vào một set, DM_VC4 giữ được tối đa 5 dòng (1 trong set và 4 trong victim buffer). Khi N lớn hơn 5, thay thế vòng tròn luôn đẩy ra đúng dòng sắp được dùng lại, nên victim hit sụp về gần 0; đây là hiện tượng thrash của mọi chính sách kiểu FIFO / LRU với vòng lặp dài hơn dung lượng. Điểm gãy đo được bằng probe: DM 2, SA2 3, DM_VC4 6 dòng.
- Weighted CPI. "CPI có trọng số bằng tổng mcycle chia tổng minstret trên các kernel."
- Caption hình 3 (A5). "Số đếm tuyệt đối của từng loại chu kỳ giống nhau giữa các cấu hình; tỉ lệ phần trăm khác nhau vì tổng số chu kỳ khác nhau."
- Kết luận "DM nhanh nhất". Thay bằng kết quả M1: ở 4 KiB, controller chiếm +9.8 %, tổ chức cache −0.3 %; cùng controller thì set-associative nhanh hơn ở mọi dung lượng.
- Tiêu đề. Bỏ "on FPGA" hoặc thêm phần ASIC vào tiêu đề, vì bài có cả hai.

## 07Thay đổi RTL

### 7.1 Tính năng mới

- FAST_HIT (R16): trả lời hit mảng chính một chu kỳ sớm hơn ở core DSE và N-way. FAST_HIT 0 được chứng minh tương đương RTL trước đó, cả ở mức module (16 / 16, đối chứng âm phát hiện 8 / 8) lẫn ở mức SoC cho đúng đầu vào PD (DM 35,067 / SA2 36,741 / DM_VC4 37,441 cell, 0 chưa chứng minh).
- Core N-way (R15) cho SA4, thay thế PLRU.
- RAM chính 16 KiB (R14) để chạy được bộ Embench-IoT gốc.
- Tag RAM đồng bộ cho cả bốn cache; tham số hóa LINE_WORDS (dòng 8 / 16 / 32 B).
- Báo lỗi ghi AXI qua sysmon (mục 5, lỗi 5); ident sysmon 0x53380001 → 0x53380002.

### 7.2 Sửa để đóng timing ASIC mà không đổi CPI

Ràng buộc: hành vi từng chu kỳ giữ nguyên, nên CPI không đổi. Mọi thay đổi đều có chứng minh hình thức hoặc checker kèm đối chứng âm, và chuỗi Embench / CoreMark trùng tham chiếu.

Thay đổi | Lý do | Chứng minh | Kết quả
Viết lại bộ cộng pc + imm ở fetch | SRAM xuất dữ liệu ở sườn xuống, đường fetch chỉ có nửa chu kỳ | SAT trên mọi pc_f × mọi lệnh, có đối chứng âm | Sau CTS, nom_tt −0.788 → +2.766 ns; +0.9 % diện tích cell
Một bộ nhân có dấu 33×33 thay 3 bộ nhân 32×32 | Diện tích, công suất, timing | 20,025,600 phép so với ALU cũ, 0 sai khác, có đối chứng âm | FPGA: khối nhân 9 bit 24 → 8; công suất bộ nhân 6.22 → 1.53 mW
Thanh ghi hóa giải mã (select forwarding, kiểu load, is_upper / is_link) | 70 % endpoint trượt ở ss xuất phát từ d_req_addr | Checker tương đương trong RTL: 447,858,365 chu kỳ, 0 lệch | Giảm đường tới hạn ở ss
hot_mvalid (8 flop) | Hit L0 khỏi phải đọc mux valid 256:1 (7 ns) | k-induction (256 và 8 dòng) + đối chứng âm | Bỏ đường xấu nhất ở ss
keep trên giá trị tăng của 36 bộ đếm và minstret (chỉ ASIC) | Chuỗi carry 23 cell trên đường enable | Equivalence 1,256 / 1,256 và 5,281 / 5,281 cell + đối chứng âm | 23 → 3 cell; netlist ASIC trùng từng byte với bản trước
Select mã hóa cho FPGA, one-hot cho ASIC | One-hot làm DM_VC4 vượt 20,000 LE | k-induction | −145 LE ở DM_VC4

### 7.3 Register file và BHT vào M9K (chỉ FPGA, phản biện A1, 08/10)

Register file 32 × 32 (1,386 LE) và BHT 256 × 2 (962 LE) nằm trong flip-flop, chiếm 36 % core. M9K chỉ đọc đồng bộ, nên địa chỉ đọc được "đọc trước": tại mỗi sườn, RAM nhận đúng giá trị mà thanh ghi instr_d (trường rs) hoặc pc_f / pc_e sẽ nhận ở sườn đó. Dữ liệu vì vậy sẵn sàng đúng chu kỳ như mảng bất đồng bộ cũ; CPI không đổi. Toàn bộ nằm trong `ifndef __openlane__: ASIC giữ mảng flop.

- Register file: hai bản M9K (mỗi cổng đọc một bản). M9K trả dữ liệu cũ nếu cùng sườn có ghi; lần ghi đó được bypass từ bản sao đăng ký we / rd / wd; write-through của chu kỳ hiện tại và x0 = 0 giữ nguyên.
- BHT: bộ đếm trong hai bản M9K (đọc ở fetch, đọc ở update); một bit valid mỗi entry trong flop, reset bất đồng bộ, giữ đúng nghĩa "reset đưa mọi entry về 01"; lần update của sườn trước được bypass cho cả hai cổng đọc.

Bằng chứng | Kết quả
k-induction (Yosys): register file mới = cũ; BHT mới = cũ; giao thức đọc trước trong datapath | 3 / 3 chứng minh; 3 / 3 đối chứng âm (bỏ bypass, bỏ kiểm valid, bỏ flush) có phản ví dụ
Checker chỉ mô phỏng (mảng cũ đặt cạnh, dừng ở chu kỳ đầu tiên khác) | Im lặng trong mọi lần chạy; ép đọc sai thì 2 / 2 checker dừng mô phỏng
Testbench mới: tb_regfile (20,073 chu kỳ, đủ ba đường đọc), tb_bht thêm 4 nhóm (RAM, update liên tiếp, fetch đúng entry đang update, reset giữa chừng) | PASS trên cả mảng cũ (view ASIC) và mảng mới
Chuỗi đầy đủ (mục 8) trên manifest 6c4ccffd | 0 lỗi; Embench, CoreMark, random-diff, view ASIC, ramsweep trùng R16 từng trường
ASIC: token sau tiền xử lý của view ASIC; tổng hợp OpenLane từ snapshot mới | Trùng R16 (có đối chứng âm); netlist trùng từng byte (sha256 da06d38f…); lint baseline 0 cảnh báo mới

Lần đóng băng đầu (dcbf3495) trượt lint_asic: checker BHT kiểm mức reset_n trong khối đồng bộ (SYNCASYNCNET). Sửa checker (so ở sườn lên, trong cấu trúc reset), đóng băng lại thành 6c4ccffd và chạy lại toàn chuỗi.

## 08Kiểm chứng

Chuỗi đầy đủ chạy lại mỗi khi RTL đổi; lần gần nhất 08/10/2026 cho manifest 6c4ccffd (register file và BHT trong M9K): 0 lỗi, 39 phút nhờ chạy song song theo lane (mỗi lane một thư viện Questa), trước đây khoảng 5 giờ. Bảng dưới gồm cả các kiểm tra thêm sau đó: UVM mở rộng, tham chiếu Spike, CoreMark chuẩn, board, GLS exact-window, LEC của SA2. Bản cũ có regression và UVM, nhưng chưa có các mục đánh dấu "mới". Cách làm và công cụ của từng loại ở mục 12.

Kiểm tra | Phạm vi | Kết quả | Bản cũ
Static check (lint, latch) | 6 cấu hình × 64 / 256 / 512 dòng × FAST_HIT 0 / 1, 33 tổ hợp | PASS | một phần
Regression có hướng | 178 kiểm tra (thêm tb_regfile, BHT-7..10), ×2 | 178 = 178 | có
UVM | 48 ca mỗi lượt: ISA có hướng ở mức SoC, ngoại vi / IRQ, UART RX hai byte trên DM / SA2 / DM_VC4 / DM_DSE × seed 1 / 2 / 3; AXI stress với dòng 2 / 4 / 8 / 16 word × seed 1 / 2 / 3; ×2 | 48 / 48 Trường scoreboard trùng giữa hai lượt; đối chứng byte sai bị bắt | có (UVM)
Embench-IoT, CoreMark | Cấu hình 0–5 và FAST_HIT 1–5, ×2 | trùng tham chiếu | kernel tự viết
CoreMark chuẩn (mô phỏng RAM 32 KiB, Verilator) | 4 cấu hình × hiệu năng / xác nhận × 2 | 16 / 16 PASS 864 phép so trùng | mới
CoreMark quét ngắn có CRC | 92 điểm, 184 lần mô phỏng | CRC đúng nguồn Kiểm độc lập | mới
ACT4 (riscv-arch-test 2e655961, tham chiếu Spike) | 39 RV32I + 4 Zmmul, ×2; adapter 1 MiB đã sửa, có test nửa trên | 43 / 43 | log không lưu
Random differential (BP tắt so với bật) và tham chiếu Spike | 50 seed, ×2, mọi revision từ 23/09; thêm tham chiếu Spike độc lập | 50 / 50 100 lần Spike khớp cả 200 trace RTL; 300 đối chứng trace sai bị bắt | 1 seed
Mô hình cache độc lập (A3) | Đếm hit/miss so với mô hình chạy trên trace | khớp tuyệt đối 48 / 48, 24 / 24, 60 / 60 | mới
Retire so với minstret (A4) | Monitor phân loại chu kỳ | 24 / 24 kernel | mới
View ASIC = view FPGA | 33 trường kiến trúc; chỉ mcycle khác | PASS | mới
Board DE2-115 | 42 / 100 ca; 25 bộ đếm + D_ACCESS; một lượt vật lý | 42 / 100 Khớp cả hai lượt tham chiếu; còn 58 ca | chỉ crc32 và 3 lần chạy probe
GLS netlist ký tên | 12 kernel, DM và SA2 | mcycle = view ASIC từng chu kỳ | mới
GLS exact-window (DM, SA2) | 12 kernel × 2 lượt, cửa sổ đúng mcycle × 20 ns | mcycle = tham chiếu view ASIC | mới
Chứng minh hình thức (R16) | 29 kiểm tra; checker FAST_HIT bị ép sai | 0 lỗi; 4 / 4 checker bắt được | mới
Chứng minh hình thức (register file / BHT trong M9K) | 3 k-induction + 3 đối chứng âm; 2 checker bị ép sai | 3 / 3; 3 / 3 bắt được; 2 / 2 | mới
LEC RTL – netlist ký tên: DM (r14F_A / r14F_B) và SA2 (ecomaxmin); DM_VC4 phần tổng hợp | LEC ánh xạ thanh ghi; cụm nhân bằng chứng minh đại số; tiền đề reset bất đồng bộ, giá trị không xác định, clock / sườn, one-hot; đối chứng âm (đổi một cell, đổi mã FSM, spec unsigned) | 0 phản ví dụ, ×2, đối chứng âm bị bắt | mới

## 09FPGA và LE theo module

Cyclone IV E EP4CE115F29C7, Quartus Prime Lite 20.1.1, mục tiêu 50 MHz. Fmax và slack ở góc Slow 1200 mV 85 °C. Cấu hình mới ở bảng dưới là FAST_HIT 0.

### 9.1 Tổng tài nguyên, seed 2 (RTL 6c4ccffd)

Cấu hình | LE cũ (1 KiB) | LE mới (4 KiB) | Chênh | Thanh ghi cũ → mới | Bit bộ nhớ cũ → mới | Fmax cũ → mới, MHz
DM | 15,188 | 12,815 | −15.6 % | 8,356 → 7,198 | 83,328 → 209,664 | 51.62 → 52.27
SA2 | 18,168 | 16,689 | −8.1 % | 9,982 → 7,877 | 81,920 → 210,176 | 52.25 → 52.46
DM_VC4 | 19,882 | 17,130 | −13.8 % | 11,482 → 9,265 | 81,920 → 209,664 | 52.40 → 54.29
DM_DSE | – | 14,340 | | → 7,480 | → 209,664 | → 55.21
SA4 (chưa fit lại, R16) | – | 21,821 | | → 8,998 | → 207,872 | → 50.95

Fmax ở bảng này là seed 2; dải mười seed ở 9.2. Bit bộ nhớ tăng vì cache và RAM lớn hơn (RAM 16 KiB chiếm 16 M9K); register file và BHT trong M9K thêm 2,816 bit (4 M9K). Trước thay đổi (R16, flop), seed 2: DM 15,440, SA2 19,474, DM_VC4 19,812, DM_DSE 16,989 LE.

### 9.2 Mười seed chung 1..10 × 2 lượt (RTL 6c4ccffd)

Cấu hình | LE [min, max] | Thanh ghi | M9K | Fmax [min, max], MHz | Setup slack nhỏ nhất, ns | Công suất ước lượng [min, max], mW
DM | 12,800 – 12,842 | 7,198 | 30 | 52.27 – 56.18 | +0.870 | 251.64 – 258.93
DM_DSE | 14,302 – 14,364 | 7,480 | 30 | 51.02 – 55.21 | +0.399 | 262.46 – 270.41
SA2 | 16,670 – 16,739 | 7,877 | 40 | 51.96 – 54.54 | +0.754 | 278.61 – 283.04
DM_VC4 | 17,096 – 17,148 | 9,265 | 30 | 51.52 – 54.40 | +0.591 | 276.31 – 282.35

Trung bình (độ lệch chuẩn), 10 seed | LE | Fmax, MHz | Công suất ước lượng, mW
DM | 12,816.00 (12.37) | 54.73 (1.03) | 255.11 (1.80)
DM_DSE | 14,332.60 (20.41) | 53.61 (1.38) | 265.97 (2.62)
SA2 | 16,699.90 (22.60) | 52.92 (0.83) | 281.01 (1.24)
DM_VC4 | 17,124.00 (15.76) | 53.28 (1.17) | 279.52 (1.72)

Hai lượt fit độc lập: 40 cặp dòng trùng trên 115 trường phần cứng (results/fpga_points_fpga_common_seeds_continued_20261009_p1.csv, _p2.csv). So sánh các cấu hình trong cùng seed; không chọn seed tốt nhất riêng cho từng cấu hình. Góc timing Slow 1200 mV 85 °C; công suất là ước lượng của Quartus Power Analyzer (toggle mặc định 12.5 %, độ tin cậy thấp), không phải đo. Board dùng seed 2 chung cho cả bốn cấu hình.

Lần fit đầu cho 6c4ccffd dùng bốn seed (results/fpga_points_rfbht_p1.csv, _p2.csv). Trước thay đổi register file / BHT (R16, flop, bốn seed): DM 15,440 – 15,546, DM_DSE 16,989 – 17,063, SA2 19,360 – 19,474, DM_VC4 19,810 – 19,875 LE; thay đổi tiết kiệm 2,630 – 2,680 LE (13.5 – 17.0 %). Cache 8 KiB (R15, flop, chưa fit lại): DM 16,812, DM_DSE 19,364, SA2 23,629, DM_VC4 22,262, SA4 28,891 LE; mọi điểm vẫn đạt 50 MHz.

### 9.3 LE theo module (phản biện A1), RTL 6c4ccffd, seed 2

Lấy từ bảng "Fitter Resource Utilization by Entity" của các báo cáo fit đã lưu (results/fpga_points/rfbht_p1, _p2); lượt 1 và lượt 2 trùng mọi dòng. Số của mỗi module đã gồm các module con. SA4 chưa fit lại.

Module | DM | SA2 | DM_VC4 | DM_DSE
Lõi CPU | 3,818 | 3,886 | 3,889 | 3,912
register file (32 × 32, M9K; R16: 1,386 LE trong flop) | 52 | 52 | 52 | 52
bảng lịch sử nhánh (256 × 2, M9K + bit valid; R16: 962 LE) | 636 | 636 | 636 | 636
ALU và bộ nhân (+ 8 DSP) | 555 | 544 | 541 | 547
datapath còn lại (thanh ghi pipeline, forwarding, CSR) | 2,234 | 2,301 | 2,305 | 2,327
điều khiển, nhánh, hazard, wrapper | 341 | 353 | 355 | 350
I-cache | 2,446 | 3,936 | 4,108 | 2,846
D-cache (gồm victim buffer) | 1,893 | 4,161 | 4,227 | 2,949
Cache AXI master | 240 | 240 | 239 | 240
Observability | 2,350 | 2,353 | 2,544 | 2,352
system monitor (APB) | 1,313 | 1,315 | 1,407 | 1,314
bộ đếm hiệu năng | 1,038 | 1,038 | 1,137 | 1,038
Controller RAM chính (16 KiB nằm trong 16 M9K) | 144 | 141 | 144 | 141
Bus: AXI-Lite master, cầu AXI-Lite → APB, giải mã địa chỉ | 332 | 336 | 334 | 333
UART | 622 | 628 | 625 | 620
Timer | 177 | 173 | 177 | 179
I/O của board: thanh ghi hiển thị, LCD, LED 7 đoạn | 262 | 263 | 265 | 261
Logic nối SoC (phần riêng của soc_top) | 660 | 716 | 730 | 662
Logic riêng của top board | 7 | 7 | 6 | 7
Tổng (theo fit) | 12,815 | 16,689 | 17,130 | 14,340

Cộng các nhóm ra nhiều hơn tổng khoảng 1 % (136–162 LE): Quartus tính một logic cell chứa LUT của module này và thanh ghi của module khác vào cả hai.

Đọc bảng này thế nào

- Lõi CPU còn 3,818 LE, tức 30 % thiết kế DM (R16: 6,451 LE, 42 %). Phần lớn còn lại là cache, observability và ngoại vi.
- Register file và BHT trong flop từng chiếm 2,348 LE (36 % lõi R16). Trong M9K còn 688 LE: register file 1,386 → 52, BHT 962 → 636 (phần còn lại là bit valid và bypass). Mục 7.3.
- Phần SA2 và DM_VC4 tăng so với DM nằm ở cache: SA2 +3,758, DM_VC4 +3,996 LE. Riêng controller DSE (DM_DSE so với DM) là +1,456. Victim buffer của DM_VC4 thêm +2,540 so với DM_DSE: mỗi cache một bộ, mỗi bộ khoảng +1,270 LE và +795 thanh ghi (4 dòng 16 B, tag, so sánh 4 đường, đường hoán đổi).
- Phản biện viết "4,694 LE cho 64 B và 4 bộ so sánh" (bản 1 KiB). Thực ra con số đó gồm controller DSE và hai victim buffer.
- CPI × LE (12 kernel Embench-IoT, view FPGA, seed 2; CPI không đổi): DM 19,397; DM_DSE 23,824; SA2 27,699; DM_VC4 28,744 (flop: 23,370 / 28,226 / 32,321 / 33,245).

### 9.4 Chi phí FAST_HIT trên FPGA (seed 2)

SA2 +456 LE, Fmax 53.71 → 51.65 MHz; DM_VC4 +115 LE; DM_DSE +345 LE; SA4 +881 LE. Mọi điểm vẫn đạt 50 MHz ở Slow 85 °C (slack xấu nhất +0.639 ns).

### 9.5 Register file và BHT trong M9K, DM, seed 2

Chỉ số | R16 (flop) | M9K | Chênh
LE | 15,440 | 12,815 | −2,625 (−17.0 %)
Logic tổ hợp | 13,903 | 11,517 | −2,386
Thanh ghi | 8,430 | 7,198 | −1,232
M9K | 26 | 30 | +4 (2 register file, 2 BHT)
Setup slack, Slow 85 °C | +0.778 ns | +0.870 ns | +0.092
Fmax, Slow 85 °C | 52.02 MHz | 52.27 MHz | +0.25
Công suất tổng (ước lượng Quartus) | 264.05 mW | 255.48 mW | −8.57
Công suất khối CPU core | 39.68 mW | 28.08 mW | −11.60 (−29 %)

Seed 2, trùng từng trường giữa hai lần đóng băng (dcbf3495 và 6c4ccffd chỉ khác code chỉ-mô-phỏng) và giữa hai lượt × 4 seed của lần fit đầu (dải 10 seed ở 9.2). Công suất là ước lượng với tỉ lệ chuyển mạch mặc định, không phải đo.

## 10Hiệu năng và kết luận khoa học

### 10.1 CPI hai bản (không so trực tiếp được)

Bộ đo | DM | SA2 | DM_VC4 | DM_DSE
Bản cũ: CPI có trọng số, 12 kernel tự viết, cache 1 KiB | 1.299 | 1.416 | 1.424 | –
Bản mới: CPI, 12 kernel Embench-IoT, cache 4 KiB | 1.5136 | 1.6597 | 1.6780 | 1.6614
Hit I$, % | 99.70 | 99.65 | 99.72 | 99.70
Hit đọc D$, % | 99.16 | 99.59 | 99.59 | 99.16
Dự đoán nhánh sai, % | 10.57 | 10.57 | 10.57 | 10.57
Embench tốc độ / MHz, trung bình nhân | 0.809 | 0.739 | 0.729 | 0.737
CoreMark 1 vòng, mcycle | 2,520,901 | 2,573,624 | 2,590,590 | 2,586,274
Vào ngắt, chu kỳ (ổn định / lần đầu) | 5 / 41 | 5 / 41 | 5 / 41 | 5 / 41
Chuyển ngữ cảnh, chu kỳ | 270 | 292 | 292 | 292

CPI có trọng số = tổng mcycle / tổng minstret. Workload hai bản khác nhau nên CPI không so được. Tắt dự đoán nhánh làm tăng chu kỳ 6.48 % (DM) đến 6.67 % (DM_VC4), trung bình nhân.

CoreMark dùng RAM 32 KiB, không phải 16 KiB

Bản build CoreMark (-O2, rv32i_zmmul, 1 vòng) cần .text 13,952 + .rodata 2,445 + .data 24 + .bss 2,020 byte và stack 1 KiB, khoảng 19.4 KiB, không vừa RAM 16 KiB của SoC. Vì vậy mọi số CoreMark (bảng này, mục 10.2 và 10.4) chạy mô phỏng với RAM 32 KiB (IMEM_DEPTH = DMEM_DEPTH = 4096 word; linker script đặt stack ở đỉnh 32 KiB). Cache và mọi tham số khác giống SoC 16 KiB, độ trễ RAM không phụ thuộc độ sâu, nên so sánh giữa các cấu hình vẫn công bằng. Nhưng CoreMark không chạy được trên chip 16 KiB; bài báo phải ghi rõ điều này.

### 10.2 M1: phần chênh là của controller, không phải của tổ chức cache

Bản cũ kết luận DM nhanh nhất trên 12 / 12 kernel. Nhưng DM dùng controller 5 trạng thái, còn SA2 và DM_VC4 dùng core DSE 10 trạng thái, mỗi hit ở mảng chính tốn thêm một chu kỳ. Tách hai phần (trung bình nhân chu kỳ trên 12 kernel Embench-IoT; số âm là nhanh hơn):

Dung lượng | Controller: DM_DSE / DM | Tổ chức: SA2 / DM_DSE | SA4 / DM_DSE | DM_VC4 / DM_DSE | So như bài cũ: SA2 / DM
256 B | +4.33 % | −5.29 % | n/a | +5.97 % | −1.19 %
512 B | +5.58 % | −6.75 % | −8.64 % | +4.53 % | −1.55 %
1 KiB | +6.93 % | −2.98 % | −4.78 % | +3.32 % | +3.74 %
2 KiB | +8.86 % | −0.70 % | −1.44 % | +2.10 % | +8.10 %
4 KiB | +9.83 % | −0.26 % | −0.07 % | +1.03 % | +9.55 %
8 KiB | +10.83 % | −0.16 % | −0.17 % | +0.01 % | +10.65 %

Khi khớp độ trễ hit bằng FAST_HIT, tổ chức cache trên cùng một controller (X_fast / DM_DSE_fast):

Dung lượng | SA2 | SA4 | DM_VC4 | CoreMark SA2 | CoreMark SA4 | CoreMark DM_VC4
256 B | −5.74 % | n/a | +5.99 % | −1.01 % | n/a | +2.23 %
512 B | −7.43 % | −9.51 % | +4.61 % | −2.72 % | −3.99 % | −0.19 %
1 KiB | −3.39 % | −5.56 % | +3.29 % | −1.18 % | −1.20 % | +0.31 %
2 KiB | −0.86 % | −1.70 % | +2.04 % | −0.67 % | −0.71 % | +0.21 %
4 KiB | −0.28 % | −0.09 % | +1.07 % | −0.53 % | −0.56 % | +0.17 %
8 KiB | −0.18 % | −0.20 % | −0.01 % | −0.33 % | −0.33 % | +0.12 %

Kết luận dùng được cho bài

- Ở 4 KiB, controller chiếm +9.8 %, còn tổ chức cache chỉ −0.3 %. Câu "DM thắng SA2" là kết quả của controller.
- Cùng controller, set-associative nhanh hơn ánh xạ trực tiếp ở mọi dung lượng (trung bình nhân), trên cả Embench lẫn CoreMark: 3–10 % dưới 2 KiB, 0.1–0.6 % ở 4–8 KiB. Phần chênh còn lại giữa DM_DSE_fast và DM là +1.09 % ở 256 B và 0.00 % ở 8 KiB.
- DM_VC4 miss ít nhất nhưng chậm nhất, vì core chép dòng bị đẩy ra vào victim buffer trước mỗi lần nạp (I$ khoảng 5, D$ khoảng 8 chu kỳ). Đây là đặc điểm của vi kiến trúc này, không phải của victim cache nói chung.
- Hiệu ứng từng kernel lớn theo cả hai chiều, nên phát biểu phải theo từng workload. Ở 4 KiB: nettle-sha256 chậm hơn 16.2 % (SA2) / 22.1 % (SA4) vì vòng lệnh bị LRU đẩy ra liên tục; statemate nhanh hơn 8.9 %; matmult-int nhanh hơn 4.5 / 4.7 %.
- Kích thước dòng (FAST, so với 16 B): 32 B tốt hơn 4.7–5.4 % ở 4 KiB; 8 B tệ hơn 12–13.6 %. Độ sâu victim (so với VC4): VC2 +2.58 % (1 KiB) / +0.23 % (4 KiB); VC8 −1.34 % / −0.45 %.

### 10.3 Conflict probe mở rộng (4 KiB và 1 KiB, dòng 16 B)

Probe cũ chỉ đọc vòng N dòng của một set, và ở 4 KiB bước nhảy 1 KiB của nó không còn đụng nhau. Probe mới (sw_metrics/conflict/, ngoài manifest RTL): dòng (s, k) ở 0x0C00 + k·4096 + s·16 rơi vào cùng một set ở mọi tổ chức với cùng s; 35 thí nghiệm; mỗi cửa sổ đo chỉ chứa truy cập của probe (firmware tự kiểm). Mọi cửa sổ khớp mô hình cache độc lập: 390 / 390 cửa sổ, 24 run × 2 lượt, lượt 1 = lượt 2. Bảng: tỉ lệ hit D$, %; 4 KiB trừ khi ghi 1 KiB (hình học bảng 6 của bài).

Mẫu truy cập | DM | DM_DSE | SA2 | SA4 | DM_VC4
Vòng, 1 set, N = 2 | 98.4 | 0 | 100 | 100 | 100
Vòng, 1 set, N = 3 / 4 | 0 / 0 | 0 / 0 | 0 / 0 | 100 / 100 | 100 / 100
Vòng, N = 2 mỗi set, 4 set | 0 | 0 | 100 | 100 | 100
Vòng, N = 2 mỗi set, 5 / 32 set | 0 / 0 | 0 / 0 | 100 / 100 | 100 / 100 | 50 / 50
Vòng, N = 3 mỗi set, 2 / 3 set | 0 / 0 | 0 / 0 | 0 / 0 | 100 / 100 | 100 / 33.3
Ngẫu nhiên, 1 set, N = 4 | 52.7 | 25.8 | 52.7 | 100 | 99.6
Ngẫu nhiên, N = 2 mỗi set, 5 / 8 / 16 set | 52 / 48 / 53 | 51 / 48 / 53 | 99 / 100 / 100 | 100 | 90 / 76 / 65
Đọc rồi ghi cùng dòng, N = 2, 5 set | 50 | 50 | 100 | 100 | 75
Chỉ ghi, N = 2, 4 set | 50 | 50 | 100 | 100 | 75
1 KiB, vòng, 1 set, N = 5 / 6 / 7 | 0 | 0 | 0 | 0.3 / 0 / 0 | 100 / 66.7 / 0
1 KiB, ngẫu nhiên, 1 set, N = 8 | 24.4 | 9.6 | 24.4 | 49.0 | 59.0

- Victim buffer dùng chung: DM_VC4 giữ 2 dòng / set chỉ tới 4 set (4 entry), sang set thứ 5 rơi về 50 %; SA2 giữ ở mọi set. Đây là giới hạn cấu trúc mà probe một set không thấy được, và giải thích vì sao DM_VC4 thua trên Embench.
- Sụp đổ ở N lớn là của thứ tự vòng (góp ý bảng 6, N = 7): cùng tập dòng nhưng thứ tự ngẫu nhiên thì DM_VC4 giảm dần 90 → 76 → 65 % thay vì 50 %; SA2 với 1 set, N = 4 cũng từ 0 % (vòng) lên 52.7 %. Ở 1 KiB (đúng hình học bảng 6): DM_VC4 vòng N ≤ 5 → 100 %, N = 6 → 66.7 %, N = 7 → 0 %, nhưng cùng 8 dòng theo thứ tự ngẫu nhiên → 59.0 %; SA4 vòng N = 5 → 0.3 % (PLRU).
- L0 của DM: DM giữ được N = 2 trong một set (98.4 %) nhờ L0 hai entry; DM_DSE (không L0) 0 %. Điểm gãy của DM trên RTL hiện tại là N = 3, không phải 2 như probe cũ.
- Ghi: D$ write-through, không cấp phát khi ghi trượt: ghi trượt không đẩy dòng nào ra, nên dòng đọc vẫn ở lại.
- Giá: hit ở victim buffer tốn khoảng 19–22 chu kỳ mỗi truy cập trong vòng lặp probe, hit mảng chính 10–14, trượt 26–30.

### 10.4 CoreMark chuẩn (mô phỏng, RAM 32 KiB, 50 MHz)

Ma trận chuẩn bổ sung cho bản CoreMark một vòng ở 10.1; khác cờ biên dịch và số vòng. Thời gian tính từ ticks của timer APB ở 50 MHz.

Cấu hình | ticks hiệu năng | giây ở 50 MHz | iterations/s | CoreMark/MHz | ticks xác nhận
DM | 719,996,901 | 14.400 | 76.389 | 1.528 | 722,669,045
SA2 | 691,866,743 | 13.837 | 79.495 | 1.590 | 693,576,231
DM_VC4 | 747,676,057 | 14.954 | 73.561 | 1.471 | 751,155,457
DM_DSE | 802,958,516 | 16.059 | 68.497 | 1.370 | 806,692,095

4 cấu hình × hiệu năng / xác nhận × 2 lượt độc lập: 16 / 16 PASS, 8 cặp trùng 108 trường (864 phép so). Firmware -Os, 1,100 vòng, mọi khoảng đo > 10 s, đếm bằng timer APB; trình biên dịch riscv64-unknown-elf-gcc 14.2.0 (-march=rv32i_zmmul_zicsr -mabi=ilp32); mô phỏng Verilator 5.053. Không phải điểm CoreMark chính thức, không phải đo trên board. Biên nhận: results/coremark_standard_apb_matrix_20261011/receipt.json.

Thứ hạng đổi theo workload và bản build

Trên ma trận CoreMark chuẩn này SA2 nhanh nhất (1.590 CoreMark/MHz), rồi đến DM (1.528), DM_VC4 (1.471), DM_DSE (1.370). Trên trung bình nhân Embench-IoT (10.1) thì DM dẫn đầu (0.809 tốc độ / MHz), và bản CoreMark một vòng -O2 ở 10.1 cũng cho DM ít chu kỳ nhất. Khi đưa vào bài, ghi rõ workload, cờ biên dịch và số vòng; không rút ra một thứ hạng chung.

## 11ASIC (sky130A, OpenLane 2.3.10, clock 20 ns)

### 11.1 DM: bản cũ và bản mới

| Bản đã công bố (DM 1 KiB) | Bản mới (r14F_A / r14F_B)
Bộ nhớ trên chip | Cache 1 KiB trong flop; RAM 8 KiB trong 4 macro SRAM 2 KiB | Cache 4 KiB trong 8 macro 1 KiB; RAM 16 KiB trong 8 macro 2 KiB: 16 macro, 3.80 mm²
Die | 1800 × 2900 µm = 5.22 mm² | 3665 × 2900 µm = 10.63 mm²
Cell chuẩn | 188,326 instance; cell area 2.68 mm² theo báo cáo cũ | 197,878 cell, 1.3696 mm²
Dây | 7.99 m | 6.585 m
DRC | TritonRoute 0, KLayout 0; Magic 21 triệu báo sai, bị bỏ qua | Route 0, Magic 0, KLayout 0; XOR 0; overlap 0
LVS | Khớp | Khớp
Antenna | 646 vi phạm | 0 (sửa antenna sau detailed routing)
Setup tt | +2.944 ns (SDC lỗi); +2.694 ns khi đo đúng | nom_tt +1.894, max_tt +1.708 ns
Setup ff | +5.199 ns (SDC lỗi) | nom_ff +4.611, min_ff +4.811 ns
Setup ss (chỉ báo cáo) | −10.9 đến −11.7 ns; −11.18 ns khi đo đúng | nom_ss −6.897, max_ss −7.365 ns
Hold | tt +0.052, ss −0.231, ff −0.064 ns (đo với SDC đúng) | ≥ 0 ở cả 9 góc; xấu nhất +0.021 ns (min_ff)
Công suất | 235.8 mW, ước lượng của flow | Vectorless nom_tt 109.15 mW. Theo hoạt động, exact-window (GLS → SAIF → OpenSTA, nom_tt, RCX; hai lượt GLS + hai lượt STA, 13/10): 114.81–122.99 mW trên 12 kernel, trung bình 119.45; động trung bình 119.02; rò 0.437 mW; hoạt động không xác định 5.38 %
Năng lượng mỗi lệnh (EPI) | – | Exact-window: 2,612–6,547 pJ, trung bình nhân 3,608 pJ
GLS | Không có | 12 / 12 kernel, mcycle = view ASIC
Lặp lại | Một lần | Hai lần, trùng trên 319 metric; netlist cuối trùng từng byte

Tương đương RTL – netlist

–

Đã chứng minh 09/10 (LEC DM RAM 16 KiB): RTL = N1 = hai netlist ký tên (LEC ánh xạ thanh ghi, 20,124 / 20,096 output, 0 phản ví dụ; cụm nhân chứng minh đại số); chạy hai lần, mọi hash trùng; đối chứng âm bị bắt. RTL – RTL chứng minh cho mọi revision sau. Tiền đề đã đóng 13/10 (mỗi phép ×2 có đối chứng âm): reset bất đồng bộ (19,087 bit flop của r14F_A và r14F_B ghép tên với gold; 7,519 có reset cùng gốc reset_sync_q và cùng giá trị, 11,568 không có; 0 sai khác); giá trị không xác định (1,401 nguồn x / không nối được thả tự do: 20,124 / 20,124 output UNSAT); bất biến one-hot của 4 FSM mã hóa lại; kiểm clock / sườn

Hai số công suất khác phương pháp nên không so trực tiếp. Theo quy ước dự án, số công suất tổng của flow OpenLane tính ở góc max_ff; số mới tính ở nom_tt với hoạt động chuyển mạch thật. Setup tt của bản mới thấp hơn vì cache chuyển từ flop sang macro OpenRAM: dữ liệu ra ở sườn xuống, tạo đường nửa chu kỳ. Bù lại, ss tốt hơn khoảng 4 ns và hold sạch ở mọi góc.

### 11.2 Các bản DM đã ký tên

Bản | Die | Setup (nom_tt / max_tt) | ss xấu nhất | Hold xấu nhất | Công suất theo hoạt động | Ghi chú
RAM 8 KiB: final3_A / final3_B (dm_ram8k_grid2800x2900_drtant_r1 / _r2) | 8.12 mm² | +2.086 / +1.960 | −8.311 | +0.030 | 110.61–115.43 mW | LEC netlist đã chứng minh; kernel tự viết cũ
RAM 16 KiB: r14F_A / r14F_B (dm_grid3665x2900_r1 / _r2), mốc so sánh cố định | 10.63 mm² | +1.894 / +1.708 | −7.365 | +0.021 | 114.8–123.0 mW | Kernel Embench-IoT gốc
RAM 16 KiB, floorplan hành lang: dmuA (dm_corr3400x3325_f220_r1) | 11.305 mm² | +1.818 / +1.595 | −8.754 | +0.002 | – | Đối chứng cùng die với SA2 / VC4
RAM 16 KiB, floorplan hành lang: dmuB (dm_corr3400x3400_f220_r1) | 11.56 mm² | +1.755 / +1.481 | −10.043 | +0.018 | – | Đối chứng cùng die với SA2 / VC4

### 11.3 SA2 đã ký tên (09/10), die 11.56 mm² (3400 × 3400 µm)

Run ký tên ecomaxmin (_r1 / _r2), floorplan hành lang (…_capm20_fo16_pad1_tdp_clkm3_rsztf_ecomaxmin). Mọi giới hạn cứng đạt; ss chỉ báo cáo. Số của DM ghi trong ngoặc để so.

Mục | Giá trị
Cổng ký tên | Magic DRC 0, KLayout DRC 0, route DRC 0, LVS 0, XOR 0, overlap 0, antenna 0, hold vi phạm 0
Setup WNS, ns | nom_tt +1.118, max_tt +0.838, min_tt +1.331; nom_ff +4.056, min_ff +4.262, max_ff +3.803; nom_ss −7.304, max_ss −7.917 (TNS −13,417), ss chỉ báo cáo
Hold WNS, ns | nom_tt +0.152; xấu nhất +0.020 (min_ff, max_ff)
Diện tích | Die 11.56 mm², cell chuẩn 1.4711 mm² (215,979 cell), 16 macro SRAM 3.80 mm², dây 9.274 m
Buffer | Sửa timing 15,240 (DM 24,448); clock buffer 4,519 + clock inverter 824; hold buffer 139 + 11 (hai lượt ECO); macro-pin buffer 775
Công suất vectorless, nom_tt | 121.99 mW (DM 109.15)
Công suất exact-window (14/10) | 127.45–131.75 mW, trung bình 129.64; động 127.02–131.31 (trung bình 129.21); rò 0.437 mW; EPI 2,848–7,354 pJ (trung bình nhân 4,317 pJ); hoạt động không xác định 4.42 %. Hai lượt GLS độc lập + hai lượt STA, lượt 1 = lượt 2 mọi trường; mọi kernel lệch ≤ 0.005 mW so với số SAIF cũ
DRV còn lại (báo cáo) | nom_tt: max slew 1,084, max cap 1,036; góc xấu nhất: slew 7,885, cap 1,827, fanout 383
Knob ký tên | Biên cap sau GRT 20 %, MAX_FANOUT 16, padding cell 1 site mỗi bên, đặt cell theo timing, clock trunk trên met3–met5, resizer chỉ ở tt / ff, ECO hold sau route hai lượt (trích xuất max_* rồi min_*)
Lặp lại | _r1 / _r2 trùng 319 metric; netlist và DEF cuối trùng từng byte; SPEF trùng trừ dòng ngày

#### LEC SA2 (13–14/10)

Bước | Kết quả
RTL = RTL + fsm | 38,300 cell proven, 0 unproven
RTL + fsm = N1 | 20,803 bit flop ở gold, 20,465 ghép tên; 338 bit chỉ có ở gold = 231 hằng (điểm bất động lớn nhất) + 18 bản sao + 89 tự do; 21,489 output. 34 output còn lại đều nằm sau bộ nhân, đóng bằng chứng minh đại số signed33 × signed33 mod 2⁶⁴ + &cec
N1 = netlist cuối (r1 và r2) | 20,462 cặp, 21,471 output, 0 SAT; 32 output đóng bằng &cec
Giá trị không xác định | 1,552 nguồn x / không nối thả tự do → 21,489 / 21,489 output UNSAT
Reset bất đồng bộ | 20,462 / 20,462 bit (8,074 có reset + 12,388 không), 0 sai khác
Đối chứng âm | Đổi mã FSM: 10 cell unproven, rc 1. Spec unsigned và đột biến tích riêng phần: NOT PROVED. Đổi một cell and2 → or2 trong netlist cuối: 60 output SAT. Mọi đối chứng đều bị bắt
Lặp lại | Hai lượt độc lập (p1 và p2b), PASS1_EQUALS_PASS2: 39 đối tượng trùng từng byte + mọi dòng kết luận

Die nhỏ nhất của SA2: 10.54 mm² trượt max_tt −0.573 ns (đường đọc nửa chu kỳ SRAM way 1 của I$); 11.05 mm² trượt pha 2 hai lần; 11.305 mm² DRT sau ECO kẹt ở 24 vi phạm met1 / met2 rồi OpenROAD crash; 11.56 mm² ký được. Đang thử knob riêng của SA2 (E1: CTS_SINK_CLUSTERING_SIZE 8 → 25): r1–r4 dừng (ba crash ngẫu nhiên, một lần thiếu RAM vì chạy cạnh detailed routing của DM_VC4). r5 qua P1 / P2 trùng số các lần trước (STAMidPNR-3 setup nom_tt +0.959, hold +0.182), detailed routing và ECO hold xong, route DRC 0; bước 51 (Report Disconnected Pins) crash ngẫu nhiên, phần sign-off chạy lại từ bước 51 sau khi V4 xong (quy tắc Q sửa: run phát triển được chạy tiếp từ bước lỗi).

#### Cơ sở chọn knob (số đo khi tìm cấu hình, 07–09/10)

- Floorplan hành lang. Floorplan lưới của DM không route được SA2 (sa2F_A / sa2F_B) và DM_VC4: cụm tag DSE (5,120 flop, đọc ở 2 chỉ số) nằm đúng ngã ba kênh, macro OpenRAM chặn met1–met4. Floorplan hành lang (sa2uA / sa2uB) đặt cụm cache 2×2 hai bên, hành lang giữa rộng ≥ 1,057 µm.
- Biên cap 20 %. Biên cap 50 % cộng RC hiệu chỉnh chèn khoảng 4,650 buffer vào cụm tag, nhu cầu met1 +31 %; với 20 % còn 357–477 buffer.
- Fanout 16. capm20 + fo16 so với cap 50 + fanout 8: tổng buffer do resizer chèn tính đến sau GRT −27 %, cell chuẩn sau GRT −3.4 %, setup trước GRT tương đương.
- Resizer chỉ ở tt / ff. Mặc định resizer tối ưu cả tt, ss, ff với biên setup 2 ns; ss không đóng được ở 20 ns (WNS −9 đến −10 ns, khoảng 7,600 endpoint) nên resizer chèn buffer hàng giờ vào cụm tag. ss vẫn được báo cáo trong STA ký tên (rsztf).
- ECO hold hai lượt. ECO hold sau route gán một trích xuất cho mọi góc: chạy với max_* thì còn nom_ff −0.023, min_ff −0.027 ns; chạy với min_* (ecomin) thì max_ff −0.116 ns. Lượt max_* rồi min_* đóng hold ở 9 góc (lượt hai chèn 11 buffer hold).
- Hai bẫy STA trong ECO. estimate_parasitics trước read_spef làm phiên dùng ước lượng (thấy tt +1.425 trong khi thật là −0.573 ns). Macro SRAM chỉ có một .lib TT; OpenSTA giữ nó cho góc được đọc đầu tiên (STA-1140). ECO chỉ dùng SPEF; lượt setup chỉ có góc tt.
- Die nhỏ làm timing sụt sau GRT. Setup nom_tt sau GRT: 11.56 mm² +0.671, 11.05 mm² +0.220, 10.54 mm² −1.287 ns (clock bị route vòng, skew 0.74 → 2.09 ns).

### 11.4 DM_VC4: chưa ký (cập nhật 14/10)

Floorplan hành lang 3600 × 3400 µm (12.24 mm²): route chính hội tụ, nhưng vi phạm antenna sau route không sửa được. Các bước trước đó (V0, V1 và các biến thể 11.56 / 11.90 mm²) ở mục 3.8. Dòng ghi "sàng lọc" chỉ chạy một bước hoặc một phần để chọn hướng, không phải kết quả.

Thử nghiệm | Kết quả | Kết luận
V2: die 3600, sửa antenna ở GRT biên 10 %, cho phép nghẽn khi route lại sau sửa antenna | P1 setup nom_tt +1.518 / hold +0.182; P2 +0.528 / −0.235. Route chính 0 vi phạm ở vòng 31 (42 phút). Kiểm antenna sau route: 1,031 net / 1,453 chân. Vòng sửa 1 chèn 2,295 diode; route lại 78,513 → 1,389 (vòng 16) → 2,063 (vòng 17); watchdog dừng | Không hội tụ
Chạy lại riêng bước route của V2, không watchdog (sàng lọc) | Tái hiện V2 trùng từng vòng (flow tất định), rồi 1,019 → 745 → 703 (vòng 20) → 353 (vòng 30) → 235 (vòng 40) → 225 (vòng 43); dừng ở vòng 44 để nhường bộ nhớ | Xu hướng gần như đứng (1–3 % mỗi vòng), khó về 0 trong 64 vòng; đây là ngoại suy, không phải kết quả cuối
Biên antenna ở GRT 10 / 20 / 30 % (sàng lọc) | 9,225 / 11,611 / 15,107 diode nhưng còn 742 / 753 / 641 net vi phạm sau sửa | Biên không phải đòn bẩy
V5: giới hạn dây 500 µm khi sửa DRV | 23,680 buffer trong 7,038 net; P2 setup nom_tt −1.068 / hold −1.882; antenna vẫn 873 net | Hỏng
V4: die 3800 × 3400 µm (12.92 mm², vùng giữa 1,457 thay 1,257 µm) | P1 +1.263 / +0.182, P2 +0.476; antenna sau sửa GRT 821 net (V2 742). Detailed routing từ 14/10 17:33: route chính về 0 ở vòng 34 (51 phút; V2: vòng 31). Antenna sau route 1,098 net / 1,470 chân (V2 1,031 / 1,453): die rộng hơn không giảm số vi phạm. Vòng sửa 1 chèn 2,233 diode; route lại 76,260 → 4,587 (vòng 10) → 1,041 (vòng 18), bám đúng quỹ đạo của V2 (bản chạy lại V2 ở vòng 18: 1,019, rồi đứng ở khoảng 225). Chủ dự án dừng lúc 14/10 21:01 | Dừng
V3: công thức V2 + watchdog riêng cho vòng antenna, chạy trọn | Dừng có chủ đích trước DRT | Dừng Sẽ tái hiện y hệt chỗ đứng 225 của bản chạy lại

Nguyên nhân gốc

Vi phạm đều thuộc loại side area (met3 885, met2 307, met1 194, met4 93), trên cổng mux2 / a221o / a22o. 837 / 1,031 net là net do resizer tạo (lá của cây buffer fanout, 538 net có 5–8 chân), dài trung vị 731 µm. 1,020 / 1,453 chân nằm trong vùng logic giữa hai cột macro I$ và D$. Chân đọc dout1 (met4, cạnh trên macro) của cả 4 macro mỗi cache quay vào kênh 220 µm giữa hai hàng macro, nên 128 bit dữ liệu đọc của mỗi cache và mạch mux của bộ đệm victim dồn về vùng giữa.

Vòng sửa antenna sau route | Net vi phạm | Diode chèn | Route lại bắt đầu từ | Kết quả
DM | 481 | 1,051 | 21k | hội tụ
SA2 | 653 | 1,453 | 33k | hội tụ
DM_VC4 (V2) | 1,031 | 2,295 | 78k | không hội tụ

Hướng tiếp (chủ dự án: làm sau, trên RTL 6c4ccffd): floorplan riêng cho DM_VC4. DM_VC4 chỉ đọc qua cổng 1 (dout1, cạnh trên macro) và ghi qua cổng 0 (cạnh dưới): đảo hướng hàng macro để dout1 quay về phía logic của chính cache đó, tách I$ và D$ sang hai phía để dữ liệu đọc không dồn vào dải giữa (không xoay 90 độ vì làm hỏng lưới nguồn). Mỗi phương án sàng lọc rẻ trước (global route + kiểm antenna, khoảng 1 giờ) rồi mới chạy full flow.

#### LEC DM_VC4, phần chỉ phụ thuộc tổng hợp

Mọi run DM_VC4 có cùng netlist tổng hợp, nên phần này không phải chờ layout. Hai lượt chạy trọn trùng nhau (30 đối tượng + 9 nhóm kết luận). Kết quả này là cho netlist tổng hợp từ R14; khi DM_VC4 làm lại trên RTL 6c4ccffd, phần này chạy lại.

Bước | Kết quả
RTL = RTL + fsm | 39,000 cell proven
RTL + fsm = N1 | Gold 21,828 / N1 21,093 bit flop; 735 bit chỉ có ở gold = 364 hằng + 18 bản sao + 353 tự do; 22,117 output, 0 SAT; 34 nhóm bộ nhân đóng bằng đại số + &cec; one-hot 4 / 4
Giá trị không xác định | 1,796 nguồn → 22,117 / 22,117 output UNSAT
SRAM bị xóa | RTL tạo cả way 1 của hai cache DSE (8 macro SRAM) mà DM_VC4 không đọc, và tổng hợp đã xóa chúng. Dữ liệu đọc của các macro này là input tự do trong chứng minh (sram_align.py); đối chứng âm NegAlign (một output phụ thuộc dữ liệu đọc đó) bị bắt
N1 = netlist cuối | Chờ layout

### 11.5 Quy trình và nghiệm thu

Quy tắc Q (chủ dự án, sửa 14/10)

Khi phát triển, được sửa và chạy tiếp từ bước lỗi. Nghiệm thu bằng một lần chạy trọn từ bước 1 với tag mới: không resume, không tách nhánh, không CONTINUE, mọi ngưỡng khai báo lúc khởi chạy.

Cấu hình | Các run ký tên đã chạy thế nào | Nghiệm thu theo quy tắc Q

DM (r14F_A / r14F_B)

Bị dừng giữa chừng khi phiên làm việc kết thúc ngày 30/09, chạy tiếp ngày 02/10 (A ở bước streamout, B trong detailed routing). Netlist cuối trùng từng byte (sha256 83f38f7e…).

Đang chạy Lần chạy trọn nghiệm thu r3 (dm_grid3665x2900_r3, 14/10 16:09) dừng ở P2: tiến trình OpenLane crash ngẫu nhiên ngay sau bước 40 (không phải lỗi thiết kế). Chạy lại từ bước 1: r4 (dm_grid3665x2900_r4, từ 18:14), cùng công thức, cổng mặc định; qua P1 / P2. Netlist và mọi số trùng r14F tới bước 42; ở bước 41 hai buffer đổi hướng S / FS (OpenROAD chọn hướng theo thứ tự phụ thuộc địa chỉ bộ nhớ, đã thấy từ 25/09), nên từ bước 43 layout khác r14F (sửa antenna: 350 net / 6,249 diode thay vì 322 / 6,262). Nghiệm thu bằng cổng ký tên và so PPA, không so hash. r4 dừng ở cổng detailed routing (21:11) khi chủ dự án chuyển PD sang RTL 6c4ccffd; lần chạy trọn nghiệm thu mới: DM 6c4ccffd (dm_grid3665x2900_rtl6c4c_r1, từ 21:12).
SA2 (ecomaxmin) | Hai run nguồn vượt cổng p2 FAIL bằng dòng CONTINUE, rồi tách nhánh sau bước 47 để chạy ECO hold lượt hai. _r1 còn chạy tiếp bước 52 sau một crash Python; _r2 không crash và cho netlist trùng. | Chuẩn bị E1 (nếu thắng PPA) hoặc E0: cùng công thức chạy một flow (ECO hai lượt nay chạy trong một bước, đã kiểm trùng từng byte với cách tách nhánh). E1 r5 được chạy tiếp từ bước 51, nên theo quy tắc Q là run phát triển. Lần nghiệm thu chạy trên RTL 6c4ccffd.

#### Thứ tự PD hiện tại

Mỗi lúc chỉ một pha nặng vì máy ảo WSL có 24 GB (detailed routing 10–12.4 GB; phần sign-off tới 12–13 GB ở Magic WriteLEF).

1. V4: chủ dự án dừng lúc 14/10 21:01 (vòng route lại sau sửa antenna bám đúng V2).
2. SA2 E1 r5 (RTL R14): sign-off từ bước 51, đang chạy; chỉ dùng để so công thức E1 với ecomaxmin.
3. DM 6c4ccffd: P1 / P2 chạy ngay vì nhẹ; detailed routing + sign-off sau khi SA2 r5 xong (khoảng 3 giờ).
4. SA2 nghiệm thu trên 6c4ccffd (E1 hoặc E0), khoảng 5 giờ.

Máy: thỉnh thoảng có crash ngẫu nhiên không tái hiện (chạy lại đúng bước đó thì qua); mọi kết quả đều chạy hai lần và so từng trường.

### 11.6 Lưu ý phương pháp

- Mỗi số timing ghi rõ góc. Macro OpenRAM chỉ có Liberty ở góc TT, nên số ss / ff của đường qua SRAM là lạc quan. Trong các phiên resizer nhiều góc, .lib TT của macro chỉ gắn với góc được đọc đầu tiên (STA-1140); STA ký tên chạy mỗi góc một phiên nên không bị.
- Góc ss không đóng được ở 50 MHz nếu không thêm tầng pipeline, mà như vậy sẽ đổi CPI; nằm ngoài phạm vi. Bài chỉ báo cáo số ss.
- Vi phạm slew / cap còn lại được báo cáo theo loại (chân SRAM, net có nhiều diode, cell chuẩn), không phải giới hạn cứng.
- Knob ký tên khác nhau giữa các cấu hình (ví dụ biên cap 50 % ở DM, 20 % ở SA2), nên một phần chênh lệch buffer và công suất đến từ knob, không hoàn toàn từ kiến trúc. Bảng cuối sẽ ghi rõ knob.

## 12Đo gì và bằng công cụ gì

Mục này ghi cho từng phần của dự án: đo hoặc kiểm thông số nào, bằng công cụ nào, làm thế nào và khi nào thì đạt, lặp lại và đối chứng ra sao, bằng chứng nằm ở file nào. Phiên bản công cụ chỉ ghi ở nơi đã xác định; các công cụ PD do OpenLane 2.3.10 gọi. Đường dẫn tính từ E:\Projects\RISCV-research.

Phần | Đo / kiểm chính | Công cụ chính | Lặp lại
12.1 RTL và kiểm tĩnh | Lint, latch, elaborate, cảnh báo mới | Verilator, Yosys | Mỗi bản RTL
12.2 Chứng minh hình thức | Tương đương cũ / mới, bất biến | Yosys (SAT, equiv_*, k-induction) | Đối chứng âm cho mỗi chứng minh
12.3 Regression có hướng | 178 kiểm tra | QuestaSim 2024.1 | ×2
12.4 UVM | Scoreboard 48 ca mỗi lượt | QuestaSim 2024.1 + UVM | ×2
12.5 Embench-IoT | 40 trường bộ đếm, CPI, hit, dự đoán sai | GCC 14.2.0, QuestaSim 2024.1 | ×2
12.6 CoreMark | CRC, ticks, CoreMark/MHz | GCC 14.2.0, Verilator 5.053 | ×2
12.7 ACT4, random differential, Spike | Signature, trace | riscv-arch-test, Spike | ×2
12.8 FPGA | LE, Fmax, slack, công suất ước lượng | Quartus Prime Lite 20.1.1 | 10 seed × 2
12.9 Board DE2-115 | 25 bộ đếm + D_ACCESS | quartus_pgm, Hercules 3.2.8 | Một lượt vật lý
12.10 Physical design | Diện tích, timing 9 góc, DRV, DRC, LVS, antenna | OpenLane 2.3.10 (Yosys, OpenROAD, OpenSTA, Magic, KLayout, Netgen) | Hai run, netlist trùng
12.11 GLS | mcycle từng kernel | QuestaSim | ×2
12.12 Công suất ASIC | Công suất theo hoạt động, EPI | QuestaSim (SAIF), OpenSTA | Hai lượt GLS + hai lượt STA
12.13 LEC | Tương đương RTL – netlist | Yosys, ABC, script riêng | Hai lượt, so hash
12.14 Chạy hai lần, ghi chép | Trùng từng trường | Biên nhận SHA-256 | Mọi phép đo

### 12.1 RTL và kiểm tĩnh

Đo / kiểm

Lỗi cú pháp và lint; latch suy ra; mọi tổ hợp tham số elaborate được; cảnh báo lint mới so với baseline của OpenLane.

Công cụ

Verilator (lint: scripts/lint_rtl.sh, lint_asic.sh); Yosys (quét latch: scripts/latch_sweep.sh); scripts/lint_baseline_check.py; scripts/rtl_manifest.py.

Cách làm, tiêu chí đạt

Quét latch trên mọi tổ hợp CACHE_CONFIG × LINE_COUNT × FAST_HIT (33 tổ hợp): không có latch. So cảnh báo lint với baseline của OpenLane: 0 cảnh báo mới. Mỗi bản RTL được đóng băng bằng manifest SHA-256 (bản hiện tại 6c4ccffd, 227 file); PD chỉ đọc snapshot đóng băng asic/snapshots/rtl_<bản>/.

Lặp lại, đối chứng

Chạy lại mỗi khi RTL đổi, nằm trong chuỗi đầy đủ (mục 8). Đã bắt được thật: lần đóng băng dcbf3495 trượt lint_asic (SYNCASYNCNET) nên bị thay bằng 6c4ccffd (7.3); quét latch bằng Yosys tìm ra 2 latch thật trong rx_block mà Verilator báo 0 (mục 5, lỗi 6).

Bằng chứng

Log chuỗi đầy đủ results/fullchain_rfbht.log (6c4ccffd); script ở dòng Công cụ.

### 12.2 Chứng minh hình thức cho các thay đổi RTL

Đo / kiểm

Tương đương giữa RTL cũ và RTL mới; bất biến của cơ chế mới (ví dụ giao thức đọc trước của M9K, hot_mvalid).

Công cụ

Yosys: SAT, equiv_make / equiv_simple / equiv_induct, k-induction. Checker chỉ mô phỏng đặt trong RTL: mảng cũ chạy cạnh mảng mới, dừng ở chu kỳ đầu tiên khác.

Cách làm, tiêu chí đạt

Mọi obligation phải được chứng minh, và mọi đối chứng âm (đột biến) phải có phản ví dụ. Đã làm: FAST_HIT 0 = RTL trước (module 16 / 16, đối chứng âm 8 / 8; mức SoC DM 35,067 / SA2 36,741 / DM_VC4 37,441 cell, 0 chưa chứng minh); bộ cộng pc + imm (SAT trên mọi pc_f × mọi lệnh); bộ nhân 33×33 (20,025,600 phép so, 0 sai khác); thanh ghi hóa giải mã (447,858,365 chu kỳ, 0 lệch); hot_mvalid (k-induction 256 và 8 dòng); keep trên bộ đếm (1,256 / 1,256 và 5,281 / 5,281 cell); register file / BHT trong M9K (3 / 3 k-induction). Chi tiết ở 7.1–7.3.

Lặp lại, đối chứng

Mỗi chứng minh kèm đối chứng âm: M9K 3 / 3 có phản ví dụ (bỏ bypass, bỏ kiểm valid, bỏ flush). Checker bị ép sai phải dừng mô phỏng: 4 / 4 với FAST_HIT (R16), 2 / 2 với M9K.

Bằng chứng

asic/equiv/r16_eq/r16_eq_verdict.txt, asic/equiv/rf_bht_m9k/, asic/rf_bht_m9k_asic_checks.log.

### 12.3 Testbench regression có hướng

Đo / kiểm

178 kiểm tra ở mức module và SoC: tb_uart_apb, tb_regfile, tb_bht, ISA có hướng ở view ASIC, bộ đồng bộ, wrapper và các test khác.

Công cụ

QuestaSim 2024.1 (vsim).

Cách làm, tiêu chí đạt

Chạy song song theo lane, mỗi lane một thư viện Questa (chuỗi đầy đủ 39 phút, trước đây khoảng 5 giờ). Đạt khi 178 / 178 PASS.

Lặp lại, đối chứng

Mỗi lần ×2, so số kiểm tra và kết quả từng kiểm tra (178 = 178). Một số test được viết để bắt đúng lỗi của bản cũ: test wrapper mới làm RTL cũ FAIL 4 và 10 trường hợp (lỗi 7); T19 được viết lại vì bản cũ PASS mà không hề tiêm lỗi (lỗi 5).

Bằng chứng

results/fullchain_rfbht.log (6c4ccffd), results/fullchain_r16.log.

### 12.4 UVM

Đo / kiểm

Scoreboard của 48 ca mỗi lượt: ISA có hướng ở mức SoC, ngoại vi / IRQ, UART RX hai byte, trên DM / SA2 / DM_VC4 / DM_DSE × seed 1 / 2 / 3; AXI stress với dòng 2 / 4 / 8 / 16 word × seed 1 / 2 / 3.

Công cụ

QuestaSim 2024.1 + UVM.

Cách làm, tiêu chí đạt

Đạt khi 48 / 48 ca PASS và mọi trường scoreboard của lượt 1 trùng lượt 2.

Lặp lại, đối chứng

Hai lượt độc lập. Đối chứng âm: byte UART sai phải FAIL, và đã bị bắt.

Bằng chứng

results/uvm_cache_uart_20261009/verification.json.

### 12.5 Embench-IoT và bộ đếm phần cứng

Đo / kiểm

40 trường bộ đếm phần cứng (sysmon) chụp ở cuối mỗi kernel, liệt kê ở bảng dưới. Chỉ số suy ra: CPI = mcycle / minstret; CPI có trọng số = Σ mcycle / Σ minstret; tỉ lệ hit; tỉ lệ dự đoán sai; Embench tốc độ / MHz (trung bình nhân, số vòng giảm, không phải điểm chính thức).

Workload

12 kernel Embench-IoT gốc (commit 09c2ed8c); nguồn giữ nguyên, trừ móc 5 dòng chỉnh số vòng.

Công cụ

riscv64-unknown-elf-gcc 14.2.0 (-march=rv32i_zmmul -mabi=ilp32 -O2 -ffreestanding -fno-builtin -nostdlib -nostartfiles); QuestaSim 2024.1 mô phỏng RTL ở view FPGA và view ASIC; snapshot_fields.py kiểm bất biến bộ đếm.

Cách làm, tiêu chí đạt

Mọi trường trùng tham chiếu trước khi sửa; bất biến bộ đếm đúng; ×2. Thêm các phép đo: bật / tắt dự đoán nhánh; FAST_HIT; quét M1 / M2 (scripts/m2/run_m2_sweep.py).

Lặp lại, đối chứng

Hai lượt so từng trường. Đối chiếu độc lập: mô hình cache chạy trên trace (scripts/cache_model.py) khớp tuyệt đối mọi bộ đếm hit / miss (48 / 48, 24 / 24, 60 / 60).

Bằng chứng

results/unified_metrics.md, results/m2/M1_M2_REPORT.md, results/m2/M1_M2_analysis.md.

Nhóm | Trường (40)
Chu kỳ, lệnh | mcycle, minstret
Phân loại chu kỳ | cycle_retire, load_use, i_wait, d_wait, control, trap, mmio, fill_drain, other
I-cache | i_access, i_main, i_victim, i_miss
D-cache | d_read, d_write, d_main, d_victim, d_miss
Nhánh | branches, taken, not_taken, predictions, correct, mispredict
AXI | axi_read, axi_write
Sự kiện | i_hit_ev, i_miss_ev, d_rd_hit, d_rd_miss, d_wr_hit, d_wr_miss, control_ev, trap_ev
Trạng thái, tự kiểm | mcause, snap_seq, result_pass, invariant_pass

### 12.6 CoreMark

Đo / kiểm

(a) Quét ngắn: -O2, một vòng, RAM mô phỏng 32 KiB; 5 giá trị CRC so với giá trị của nguồn CoreMark (e9f5 / e714 / 1fd7 / 8e3a / e714); 92 điểm, 184 lần mô phỏng. (b) Ma trận chuẩn: -Os, 1,100 vòng, mọi khoảng đo > 10 s, ticks đếm bằng timer APB; 4 cấu hình × hiệu năng / xác nhận; suy ra giây ở 50 MHz, iterations/s, CoreMark/MHz (10.4).

Công cụ

riscv64-unknown-elf-gcc 14.2.0 (ma trận chuẩn: -march=rv32i_zmmul_zicsr -mabi=ilp32); Verilator 5.053 cho ma trận chuẩn.

Cách làm, tiêu chí đạt

CRC đúng; lượt 1 trùng lượt 2. Ma trận chuẩn: 16 / 16 PASS, 8 cặp × 108 trường = 864 phép so trùng. Quét ngắn: CRC đúng nguồn, kiểm độc lập.

Lặp lại, đối chứng

Hai lượt độc lập cho cả hai loại. Giới hạn: chạy mô phỏng với RAM 32 KiB (không vừa RAM 16 KiB của chip, 10.1); không phải điểm CoreMark chính thức.

Bằng chứng

results/coremark_standard_apb_matrix_20261011/receipt.json.

### 12.7 ACT4, random differential và tham chiếu Spike

Đo / kiểm

ACT4: signature của 43 test (39 RV32I + 4 Zmmul) so với Spike. Random differential: trace của 50 chương trình sinh ngẫu nhiên, so giữa dự đoán nhánh tắt và bật. Tham chiếu Spike độc lập: so PC, lệnh, ghi thanh ghi, địa chỉ / byte / strobe của store.

Công cụ

riscv-arch-test (ACT4) commit 2e655961; Spike làm tham chiếu; mô phỏng RTL.

Cách làm, tiêu chí đạt

ACT4: 43 / 43 signature khớp; adapter 1 MiB đã sửa, có test nửa trên. Random differential: 50 / 50 trace trùng. Spike: 100 lần Spike khớp cả 200 trace RTL.

Lặp lại, đối chứng

Mọi phần ×2; log và signature ACT4 đã lưu. Đối chứng âm: 300 trace bị làm sai đều bị bắt.

Bằng chứng

results/spike_random_reference_20261011/receipt.json.

### 12.8 FPGA

Đo / kiểm

LE, thanh ghi, M9K, DSP; Fmax và setup slack ở Slow 1200 mV 85 °C; công suất ước lượng; LE theo module (bảng "Fitter Resource Utilization by Entity").

Công cụ

Quartus Prime Lite 20.1.1, thiết bị EP4CE115F29C7: fitter, TimeQuest (timing), Power Analyzer (toggle mặc định 12.5 %); scripts/le_breakdown.py cho LE theo module.

Cách làm, tiêu chí đạt

Mục tiêu 50 MHz ở Slow 85 °C; LE dưới mục tiêu mềm 20,000. 10 seed chung 1..10 cho cả 4 cấu hình; so các cấu hình trong cùng seed, không chọn seed tốt nhất riêng.

Lặp lại, đối chứng

Hai lượt fit độc lập, so 115 trường: 40 cặp dòng trùng. Công suất là ước lượng, độ tin cậy thấp; không gọi là đo.

Bằng chứng

results/fpga_points_fpga_common_seeds_continued_20261009_p1.csv, _p2.csv; results/a1_le_breakdown_rfbht.md.

### 12.9 Board DE2-115

Đo / kiểm

Firmware in qua UART 25 bộ đếm + D_ACCESS + VERIFY_CODE + RESULT; LED 7 đoạn hiện MCYCLE.

Công cụ

Nạp SOF bằng quartus_pgm qua USB-Blaster. UART qua cổng JP5 GPIO 3.3 V LVTTL (TX = GPIO[0] / AB22, RX = GPIO[1] / AC15) với bộ chuyển USB-TTL; Hercules 3.2.8, 115200 8N1.

Cách làm, tiêu chí đạt

Ma trận 100 SOF: 25 firmware × 4 cấu hình, seed 2. Giá trị kỳ vọng lấy từ hai lượt mô phỏng RTL tham chiếu, gắn với hash của từng SOF (INDEX.csv). Đạt khi mọi bộ đếm bằng cả hai lượt tham chiếu.

Lặp lại, đối chứng

Một lượt vật lý cho mỗi ca, theo phạm vi chủ dự án chốt; kiểm độc lập ở results/board_20261013_independent_check/. Phiên 13/10: 42 / 100 ca khớp; còn 58 ca (10 ca ngắn, 48 ca đủ vòng).

Bằng chứng

results/board_20261013/, results/board_20261013_independent_check/.

### 12.10 Physical design (PD)

Nền tảng

PDK sky130A, thư viện sky130_fd_sc_hd, macro SRAM OpenRAM (Liberty chỉ có góc TT); OpenLane 2.3.10, bản sao có mở rộng (mặc định tắt, mục 13 dòng 30); clock 20 ns. Tên run đọc theo mục 3.2.

Đo / kiểm

Diện tích die / core; diện tích và số cell chuẩn; buffer theo loại (sửa timing, clock, hold, macro-pin, fanout, max-cap, dây); chiều dài dây; setup / hold WNS và TNS từng góc; DRV (max slew / cap / fanout, phân loại theo chân SRAM / net nhiều diode / cell chuẩn); DRC (route, Magic, KLayout); LVS; XOR; overlap; antenna (net / chân); overflow của global route; công suất vectorless.

Tiêu chí ký tên

DRC = LVS = XOR = overlap = antenna = 0; setup ≥ 0 ở tt và ff; hold ≥ 0 ở 9 góc; ss chỉ báo cáo.

Lặp lại, đối chứng

Hai run cùng công thức (_r1 / _r2): trùng 319 metric và netlist cuối trùng từng byte. Nghiệm thu theo quy tắc Q (11.5).

Bằng chứng

asic/run_gated_pd.sh, asic/drt_watch.sh, asic/fp_tools/gate_check.py, asic/gated_pd.log.

#### Các bước của flow và công cụ

Bước | Công cụ | Số đo lấy ra
Tổng hợp | Yosys + ABC (chiến lược AREA 0) | Số cell, diện tích cell
Floorplan, PDN, đặt macro theo file cấu hình | OpenROAD | Diện tích die / core
Đặt cell toàn cục (routability-driven) và chi tiết | OpenROAD | –
Resizer: sửa DRV, timing, hold | OpenROAD | Buffer theo loại
CTS | OpenROAD | Clock buffer / inverter
Global routing | FastRoute (trong OpenROAD) | Overflow
Sửa antenna: diode ở GRT và sau detailed routing | OpenROAD | Antenna (net / chân), số diode
Detailed routing | TritonRoute (trong OpenROAD) | Vi phạm DRC theo vòng
Chèn fill | OpenROAD | –
Trích ký sinh | OpenRCX (trong OpenROAD) | SPEF
Phân tích IR drop | PSM (trong OpenROAD) | IR drop
STA ký tên | OpenSTA, 9 góc (RC min / nom / max × tt / ss / ff) | Setup / hold WNS, TNS; DRV; công suất vectorless
Xuất GDS, DRC với macro trừu tượng, trích SPICE | Magic | DRC Magic
Xuất GDS, DRC, XOR | KLayout | DRC KLayout, XOR
LVS | Netgen | LVS

#### Driver có cổng run_gated_pd.sh

Pha | Cổng
P1 | Overflow GRT ≤ 500; setup nom_tt ≥ +0.5 ns; hold ≥ 0
P2 | Overflow ≤ 2,000; setup nom_tt ≥ +0.3 ns; hold ≥ 0 hoặc ngưỡng khai báo lúc khởi chạy
P3 | Watchdog hội tụ detailed routing (drt_watch.sh)
P4 | Cổng ký tên (gate_check.py final)

Mặc định run dừng khi trượt một cổng. Có thể vượt cổng bằng dòng CONTINUE, nhưng run đó không dùng để nghiệm thu theo quy tắc Q.

### 12.11 GLS (mô phỏng netlist)

Đo / kiểm

mcycle của từng kernel; tự kiểm qua LED / HEX.

Công cụ

QuestaSim trên netlist ký tên, với model chức năng sky130_fd_sc_hd và model SRAM OpenRAM; testbench tb_gls_soc.

Cách làm, tiêu chí đạt

mcycle bằng tham chiếu view ASIC từng chu kỳ cho cả 12 kernel.

Lặp lại, đối chứng

DM và SA2: 12 kernel × 2 lượt (cùng các lượt ghi SAIF exact-window ở 12.12).

Bằng chứng

results/gls_power_r14F_A_power.csv (DM); biên nhận công suất exact-window ở 12.12.

### 12.12 Công suất ASIC theo hoạt động

Đo / kiểm

Công suất internal, switching, leakage theo nhóm (sequential, combinational, clock, macro); tỉ lệ chân không có hoạt động (unknown); EPI.

Công cụ

QuestaSim (power add, power report -bsaif) ghi SAIF; saif_to_pins.py chuyển SAIF về chân cell; OpenSTA (read_saif, report_power) ở nom_tt_025C_1v80 với SPEF từ RCX.

Cách làm, tiêu chí đạt

Cửa sổ exact-window dài đúng mcycle × 20 ns, mở / đóng bằng tín hiệu đóng băng bộ đếm; tín hiệu này được ánh xạ vào netlist, và phép ánh xạ được chứng minh bằng SAT. EPI = công suất × thời gian cửa sổ / minstret.

Lặp lại, đối chứng

Hai lượt GLS độc lập + hai lượt STA mỗi kernel (26 lần STA), so mọi trường; STA vectorless phải tái tạo đúng báo cáo của flow. So với số SAIF cũ: lệch ≤ 0.005 mW mỗi kernel.

Kết quả

DM 119.45 mW (EPI trung bình nhân 3,608 pJ; unknown 5.38 %). SA2 129.64 mW (4,317 pJ; 4.42 %). Không so với 235.8 mW của bản cũ (ước lượng của flow ở max_ff).

Bằng chứng

results/activity_power_exact_dm_20261013/receipt.json, results/activity_power_exact_sa2_20261014/receipt.json.

### 12.13 LEC: tương đương RTL – netlist

Bước EQY gốc của OpenLane không qua được trên thiết kế này (795 / 876), nên dự án dùng LEC ánh xạ thanh ghi tự xây (mục 3.9).

Đo / kiểm

Số output chứng minh (UNSAT), phản ví dụ (SAT), chưa quyết định; số cặp flop, hằng, bản sao.

Công cụ

Yosys, ABC (&miter, &sat, &cec) và script riêng: evert.py, const_check.py, mk_onehot_spec.py, inv_check.py, macc_alg.py, run_xsens.ps1, arst_audit.py, sram_align.py; driver run_lec_r14.ps1, run_lec_sa2.ps1, run_lec_vc4.ps1.

Tiêu chí đạt

0 SAT, mọi output đóng, mọi đối chứng âm bị bắt.

Lặp lại, đối chứng

Hai lượt độc lập, so từng đối tượng (hash) và từng dòng kết luận. Đối chứng âm: đổi mã FSM, spec unsigned, đột biến tích riêng phần, đổi một cell and2 → or2 trong netlist, output phụ thuộc x, output phụ thuộc dữ liệu đọc SRAM đã xóa. Python phía Windows chạy ghim một CPU logic (giảm sai sót ngẫu nhiên khi tiến trình chuyển giữa các lõi).

Bằng chứng

asic/equiv/lec/ (driver, runs.log); results/lec_sa2_20261013/pass_comparison.json; results/lec_vc4_20261014d/pass_comparison_goldn1.json; results/lec_arst_audit_20261013/; results/lec_dm_xsens_20261013/.

#### Các bước

Bước | Cách làm | Công cụ / script
Đọc RTL và netlist | Front end cho RTL và netlist; cắt macro SRAM; phẳng hóa | Yosys
RTL = RTL + fsm | Chứng minh việc mã hóa lại FSM | Yosys equiv_make -encfile, equiv_induct
N1 | Replay tổng hợp của OpenLane tới trước ABC, trùng từng byte | Yosys
Ghép flop | Ghép flop theo tên | evert.py
Hằng, bản sao | Hằng số tìm bằng điểm bất động lớn nhất; flop bản sao | const_check.py + ABC &sat
One-hot | Nhóm one-hot và chứng minh bất biến | mk_onehot_spec.py, inv_check.py
Miter | Miter và SAT từng output | ABC &miter, &sat, &cec
Bộ nhân | Chứng minh đại số: tích = signed33(A) × signed33(B) mod 2⁶⁴, rồi nối bằng &cec | macc_alg.py
Giá trị không xác định | x và net không nối được thả tự do | run_xsens.ps1
Reset bất đồng bộ; clock / sườn | Flop ghép tên phải có cùng gốc reset và cùng giá trị reset; kiểm thêm clock và sườn | arst_audit.py (reset)
SRAM bị xóa (DM_VC4) | Dữ liệu đọc của SRAM mà tổng hợp đã xóa là input tự do | sram_align.py

Kết quả | DM (RAM 16 KiB) | SA2 | DM_VC4 (phần tổng hợp)
Output chứng minh, RTL = N1 | 20,124 | 21,489 | 22,117
Output chứng minh, N1 = netlist cuối | 20,096 | 21,471 | chờ layout
Phản ví dụ (SAT) | 0 | 0 | 0
Độc lập giá trị không xác định | 1,401 nguồn → 20,124 / 20,124 UNSAT | 1,552 nguồn → 21,489 / 21,489 UNSAT | 1,796 nguồn → 22,117 / 22,117 UNSAT
Reset bất đồng bộ | 19,087 bit, 0 sai khác | 20,462 bit, 0 sai khác | chờ layout
Lặp lại | Hai lượt, mọi hash trùng | 39 đối tượng + mọi dòng kết luận trùng | 30 đối tượng + 9 nhóm kết luận trùng

### 12.14 Chạy hai lần và ghi chép

Quy tắc

Mọi phép đo chạy hai lượt độc lập, so từng trường; một số chỉ được dùng khi lượt 1 = lượt 2. Ngoại lệ ghi rõ: board (một lượt vật lý, so với hai lượt tham chiếu RTL) và các số sàng lọc.

Biên nhận

Biên nhận (receipt) chứa SHA-256 của mọi đầu vào, ví dụ receipt.json của CoreMark chuẩn, tham chiếu Spike và công suất exact-window.

Ghi chép

Một lịch sử duy nhất NHAT_KY.md; một quy trình duy nhất QUY_TRINH.md; kết quả RESULTS.md; phản biện REVIEW_RESPONSE.md.

## 13Mở rộng so với bản 1 KiB đã công bố

38 mục mà bản nghiên cứu có thêm so với bản 1 KiB đã công bố (commit a939d6f), chia 6 nhóm. Danh sách gốc: results/extensions_vs_published_1kib_20261014.md.

### 13.1 Thiết kế (RTL)

# | Mở rộng | Xem

1 | Cache I và D 4 KiB (profile nghiên cứu; mặc định trong HDL vẫn 1 KiB). | Mục 4
2 | RAM chính 8 → 16 KiB, để chạy được Embench-IoT gốc. | Mục 4, 7.1
3 | Cấu hình DM_DSE (CACHE_CONFIG 3) để tách chi phí controller (M1). | Mục 10.2
4 | SA4: 4 way, core N-way, PLRU dạng cây; chỉ FPGA / mô phỏng. | Mục 7.1
5 | Tham số CACHE_FAST_HIT. FAST_HIT 0 được chứng minh tương đương RTL trước: module 16 / 16, mức SoC cho đúng đầu vào PD. | asic/equiv/r16_eq/r16_eq_verdict.txt
6 | Kích thước dòng 8 / 16 / 32 B và độ sâu victim 2 / 4 / 8 tham số hóa. | Mục 10.2
7 | Register file và BHT vào M9K trên FPGA, đúng từng chu kỳ: −2,630 đến −2,680 LE (−13.5 đến −17 %); netlist ASIC không đổi. | Mục 7.3, 9.5
8 | Sửa timing ASIC đúng từng chu kỳ: đường nửa chu kỳ từ dout sườn xuống của OpenRAM; chứng minh SAT; CPI không đổi. | Mục 7.2
9 | Manifest RTL đóng băng (hiện 6c4ccffd); PD chỉ đọc snapshot. | Mục 3.1, 12.1

### 13.2 Workload và đo

# | Mở rộng | Xem

10 | 12 kernel Embench-IoT gốc (09c2ed8c), bỏ kernel tự viết. | Mục 12.5
11 | CoreMark: quét ngắn 92 điểm có CRC (184 mô phỏng, kiểm độc lập) và ma trận chuẩn (4 cấu hình × hiệu năng / xác nhận × 2, mọi khoảng > 10 s). | Mục 10.4, 12.6
12 | Bảng chỉ số hợp nhất: CPI, hit, dự đoán sai, Embench / MHz, ngắt 5 / 41 chu kỳ, chuyển ngữ cảnh 270 / 292, view ASIC so với FPGA. | Mục 10.1; results/unified_metrics.md
13 | Quét không gian thiết kế (M2): 256 B – 8 KiB × {DM, DM_DSE, SA2, DM_VC4, SA4}, dòng 8 / 16 / 32 B, victim 2 / 4 / 8, 13 workload, có / không FAST_HIT, ×2. | Mục 10.2; results/m2/M1_M2_REPORT.md
14 | Kết quả tách controller: ở 4 KiB controller +9.8 %, tổ chức −0.3 %; khớp độ trễ hit thì set-associative thắng ở mọi dung lượng (3–10 % dưới 2 KiB). | Mục 10.2
15 | Conflict probe mở rộng: 35 mẫu × 6 cấu hình × 2 dung lượng; 390 cửa sổ khớp mô hình độc lập. | Mục 10.3
16 | Probe độ kết hợp (cachesweep): điểm gãy DM 2, SA2 3, DM_VC4 6. | Mục 6
17 | Bật / tắt dự đoán nhánh: +6.5 đến +6.7 % chu kỳ khi tắt. | Mục 10.1
18 | Retire so với minstret: giải thích và chứng minh trên 24 / 24 kernel (A4). | Mục 8

### 13.3 Kiểm chứng

# | Mở rộng | Xem

19 | Mô hình cache độc lập chạy trên trace: mọi bộ đếm khớp (48 / 48, 24 / 24, 60 / 60). | Mục 8, 12.5
20 | ACT4 43 / 43 ×2, log lưu, adapter 1 MiB đã sửa. | Mục 12.7
21 | Random differential 50 seed ×2 + tham chiếu Spike: 100 lần Spike khớp 200 trace RTL, 300 đối chứng bị bắt. | results/spike_random_reference_20261011/receipt.json
22 | UVM 48 ca mỗi lượt, gồm AXI stress dòng 2 / 4 / 8 / 16 word và UART RX; đối chứng byte sai. | results/uvm_cache_uart_20261009/verification.json
23 | Chuỗi kiểm chứng đầy đủ cho mỗi thay đổi RTL, ×2. | Mục 8
24 | Chứng minh hình thức cho mọi tái cấu trúc, mỗi cái có đối chứng âm. | Mục 7.2, 7.3, 12.2

### 13.4 FPGA

# | Mở rộng | Xem

25 | 10 seed chung × 2 lượt cho 4 cấu hình (bản cũ: 4 seed, 1 lượt). | Mục 9.2
26 | LE theo module (A1) và CPI × LE. | Mục 9.3
27 | Ước lượng công suất Quartus 10 seed × 2 (A9). | Mục 9.2
28 | Ma trận 100 SOF cho board (25 firmware × 4 cấu hình, seed 2) với bộ đếm kỳ vọng gắn hash; phiên 13/10: 42 / 100 ca khớp, còn 58. | Mục 12.9

### 13.5 ASIC (không có trong repo đã công bố)

# | Mở rộng | Xem

29 | Full flow OpenLane 2 tới ký tên, mỗi bản chạy kép, netlist cuối trùng: DM 10.63 mm², SA2 11.56 mm²; DM_VC4 còn mở. | Mục 11
30 | Mở rộng OpenLane cục bộ (mặc định tắt): ECO hold sau route trên ký sinh trích xuất (hai lượt RC trong một bước), buffer chân macro, sửa antenna sau detailed routing (có tùy chọn cho phép nghẽn), móc hiệu chỉnh RC, lưu route chính, driver bốn pha có cổng và watchdog hội tụ (có luật riêng cho vòng sửa antenna). | Mục 12.10; asic/run_gated_pd.sh, asic/drt_watch.sh
31 | Tìm die nhỏ nhất cho SA2: 10.54 / 11.05 / 11.305 mm² hỏng, 11.56 mm² ký được. | Mục 3.7, 11.3
32 | GLS netlist ký tên: 12 / 12 kernel khớp chu kỳ view ASIC. | Mục 12.11
33 | Công suất theo hoạt động exact-window, hai lượt GLS + hai lượt STA: DM 119.45 mW (EPI 3,608 pJ), SA2 129.64 mW (4,317 pJ). | Mục 12.12
34 | Tương đương RTL – netlist sau route (LEC ánh xạ thanh ghi + chứng minh đại số bộ nhân) cho DM và SA2, tiền đề đã đóng (reset bất đồng bộ, độc lập giá trị không xác định, clock / sườn, bất biến one-hot); DM_VC4 phần tổng hợp. | Mục 12.13
35 | Timing từng góc kể cả ss (báo cáo, không làm cổng), phân loại DRV. | Mục 11.1, 11.3

### 13.6 Phương pháp và ghi chép

# | Mở rộng | Xem

36 | Chạy hai lần mọi phép đo, so từng trường, biên nhận SHA-256. | Mục 12.14
37 | Một lịch sử, một file quy trình, một file kết quả, một file trạng thái phản biện. | Mục 12.14
38 | Trả lời phản biện từng điểm. | Mục 14

## 14Phản biện (danh_gia.txt)

Đủ 20 điểm của phản biện. Trạng thái theo results/review_status_20261014.md; trả lời chi tiết ở REVIEW_RESPONSE.md.

Mục | Phản biện nói | Trạng thái | Đã làm / còn lại
M1 | Kết quả chính là hiện vật của controller | Đã xử lý | DM_DSE + FAST_HIT: ở 4 KiB controller +9.8 %, tổ chức −0.3 %; khớp độ trễ hit thì set-associative thắng ở mọi dung lượng (10.2).
M2 | Chỉ 3 điểm, 1 dung lượng, 1 kích thước dòng | Đã xử lý | Quét 256 B – 8 KiB × 5 tổ chức, dòng 8 / 16 / 32 B, victim 2 / 4 / 8, 13 workload, ×2.
M3 | Novelty yếu, thiếu related work | Viết bài | Kết quả hỗ trợ đã có: độ sâu controller quan trọng hơn độ kết hợp ở cache nhỏ; điểm đảo chiều đã đo (SA2 / DM đổi dấu giữa 512 B và 1 KiB, 10.2).
A1 | 15–20 nghìn LE trông chưa tối ưu | Đã xử lý | Bảng LE theo module; register file / BHT vào M9K (−13.5 đến −17 %); DM 12.8 nghìn LE với cache gấp 4 (9.3, 9.5).
A2 | Fmax khoảng 52 MHz; core trượt 20 ns trên Sky130 | Một phần | FPGA 51–56 MHz trên 10 seed chung ×2; ASIC DM và SA2 đóng 50 MHz ở tt và ff sau route. Còn DM_VC4; ss chỉ báo cáo (đóng ss sẽ đổi CPI).
A3 | Không đối chiếu mô hình độc lập | Đã xử lý | Mô hình chạy trên trace, mọi bộ đếm khớp (48 / 48, 24 / 24, 60 / 60).
A4 | Tỉ lệ retire và minstret lệch | Đã xử lý | Giải thích và chứng minh trên 24 / 24 kernel.
A5 | Caption hình 3 | Viết bài | Sửa câu chữ: số đếm tuyệt đối giống nhau, tỉ lệ khác nhau (câu đề xuất ở mục 6).
A6 | Kernel "kiểu Embench" tự viết | Đã xử lý | 12 kernel Embench-IoT gốc; CoreMark quét có CRC và ma trận chuẩn (mô phỏng).
A7 | Bằng chứng board, random differential 1 seed, log ACT4 | Một phần | ACT4 43 / 43 ×2, random differential 50 seed ×2 + Spike, UVM 48 ca ×2 đã xong; board 42 / 100 ca khớp. Còn 58 ca board.
A8 | BP bật / tắt không có số | Đã xử lý | +6.5 đến +6.7 % chu kỳ khi tắt.
A9 | Thiếu công suất / năng lượng | Một phần | FPGA ước lượng 10 seed ×2; ASIC exact-window DM 119.45 mW (EPI 3,608 pJ) và SA2 129.64 mW (4,317 pJ), mỗi cái hai lượt GLS + hai lượt STA. Còn DM_VC4 sau ký tên.
m1 | Phần ASIC: ss −11.7 ns, 646 antenna, 8,718 slew, nhật ký Magic | Một phần | DM / SA2: antenna 0, đóng tt / ff, hold đóng ở 9 góc, DRV phân loại, ss báo cáo. Còn DM_VC4; phần viết lại.
m2 | 11 hạn chế, cần gộp và sửa | Viết bài | Phần lớn hạn chế kỹ thuật nay đã sửa bằng số liệu (M1, M2, A6, A7, A9).
m3 | Footnote GCC 14.2 / UB chuyển vào README | Viết bài | Chuyển footnote vào README của artifact.
m4 | Bảng 5 dùng seed 1, 2, 3, 5 (sao bỏ 4) | Đã xử lý | Thay bằng 10 seed chung 1..10, ghép cặp, hai lượt (9.2).
m5 | Bảng 6: ở N = 7 chỉ 1 victim hit | Đã xử lý | Đã đo: FIFO / vòng tròn với thứ tự tuần hoàn sụp; cùng các dòng theo thứ tự ngẫu nhiên giữ 59 % (1 KiB, N = 8) (10.3).
m6 | "Victim cache 59 % trên matmult" không có trong kết quả | Viết bài | 59 % trong dữ liệu là conflict probe thứ tự ngẫu nhiên, không phải matmult; sửa câu kết luận.
m7 | Định nghĩa "weighted CPI" | Đã xử lý | Σ mcycle / Σ minstret.
m8 | Tiêu đề chỉ ghi "on FPGA"; từ khóa | Viết bài | Sửa tiêu đề và từ khóa.

Tổng 20 điểm: 10 đã xử lý (M1, M2, A1, A3, A4, A6, A8, m4, m5, m7), 4 một phần (A2, A7, A9, m1), 6 chỉ còn việc viết bài (M3, A5, m2, m3, m6, m8). Bốn điểm một phần chỉ còn chờ hai việc: DM_VC4 ký tên ASIC và 58 ca board.

## 15Còn mở và lưu ý khi viết bài

### Còn mở

- DM_VC4 ký tên. V4 (die 3800 µm) dừng 14/10 21:01: route chính về 0 nhưng antenna sau route vẫn 1,098 net và vòng route lại bám đúng V2. Làm sau (chủ dự án), trên RTL 6c4ccffd, với floorplan riêng cho DM_VC4 (11.4). Sau khi ký: chạy kép, GLS, công suất exact-window, LEC bước N1 = netlist cuối (11.4).
- Lần chạy trọn nghiệm thu theo quy tắc Q. Chủ dự án chốt 14/10: PD dùng RTL 6c4ccffd. DM: dm_grid3665x2900_rtl6c4c_r1 đang chạy từ 14/10 21:12 (r3 dừng vì crash; r4 trên R14 đã dừng). SA2: chạy trên 6c4ccffd với công thức E1 (nếu thắng PPA) hoặc E0. Sau khi ký: GLS, công suất exact-window và LEC trên các layout 6c4ccffd (11.5).
- Thứ tự PD. Mỗi lúc chỉ một pha nặng vì máy ảo WSL có 24 GB (detailed routing 10–12.4 GB; phần sign-off tới 12–13 GB ở Magic WriteLEF). Thứ tự (21:30): SA2 E1 r5 sign-off từ bước 51 (đang chạy, bản R14, chỉ để chọn công thức SA2) → DM 6c4ccffd detailed routing + sign-off (P1 / P2 đang chạy song song vì nhẹ) → SA2 nghiệm thu trên 6c4ccffd. V4 đã dừng.
- 58 ca board: 10 ca ngắn, 48 ca đủ vòng (12.9).
- Bảng PPA cuối cho ba cấu hình: diện tích die và core, buffer, dây, công suất động và rò, knob ký tên, CPI và hit rate.
- Phần viết bài: M3, A5, m2, m3, m6, m8 (14).

### Lưu ý khi đưa số vào bài

- Không viết "DM nhanh hơn set-associative". Viết theo controller và theo từng workload (10.2).
- Thứ hạng phụ thuộc workload và bản build: CoreMark chuẩn (10.4) cho SA2 nhanh nhất, trung bình nhân Embench-IoT (10.1) cho DM nhanh nhất.
- CPI của bản cũ (kernel tự viết) và bản mới (Embench-IoT) không so với nhau.
- Số Embench ở đây không phải điểm Embench chính thức.
- Mọi số CoreMark là mô phỏng với RAM 32 KiB (10.1, 10.4), không phải điểm CoreMark chính thức; không gọi là CoreMark "trên chip".
- Công suất FPGA là ước lượng của Quartus với tỉ lệ chuyển mạch mặc định. Công suất ASIC mới là đo theo hoạt động ở nom_tt. Số 235.8 mW của bản cũ là ước lượng của flow; không so trực tiếp.
- Công suất ASIC exact-window và công suất SAIF cũ lệch ≤ 0.005 mW mỗi kernel; dùng số exact-window.
- Mỗi số timing kèm tên góc; ss chỉ báo cáo.
- Mọi số trong trang đã chạy hai lần và trùng nhau, trừ số đo trên board (một lượt vật lý theo phạm vi chủ dự án chốt) và các số ghi rõ là sàng lọc.

## 16Nguồn số liệu

Đường dẫn tính từ E:\Projects\RISCV-research, trừ khi ghi khác.

Nội dung | File
Tổng hợp kết quả hiện tại | RESULTS.md
Trả lời phản biện từng mục | REVIEW_RESPONSE.md
Trạng thái phản biện; danh sách mở rộng | results/review_status_20261014.md; results/extensions_vs_published_1kib_20261014.md
Quy trình | QUY_TRINH.md (mục B, C, D, E, F, F2)
Lịch sử, lý do từng quyết định | NHAT_KY.md (tiếng Việt)
Bảng đổi tên đầy đủ | NHAT_KY.md mục 11
M1 / M2, quét thiết kế | results/m2/M1_M2_REPORT.md, results/m2/M1_M2_analysis.md
Bảng kiến trúc (CPI, hit rate, CoreMark, ngắt) | results/unified_metrics.md
CoreMark chuẩn | results/coremark_standard_apb_matrix_20261011/receipt.json
Conflict probe mở rộng | sw_metrics/conflict/, results/conflict_probe.csv
Register file / BHT vào M9K: script áp, chứng minh, chuỗi, ASIC | scripts/apply_rf_bht_m9k.py, asic/equiv/rf_bht_m9k/, results/fullchain_rfbht.log, asic/rf_bht_m9k_asic_checks.log, results/fpga_points_rfbht_p1.csv
Chuỗi kiểm chứng R16 | results/fullchain_r16.log
UVM | results/uvm_cache_uart_20261009/verification.json
Random differential, tham chiếu Spike | results/spike_random_reference_20261011/receipt.json
LE theo module (A1) | results/a1_le_breakdown_rfbht.md (R16: _r16.md), scripts/le_breakdown.py
FPGA 10 seed chung × 2 lượt | results/fpga_points_fpga_common_seeds_continued_20261009_p{1,2}.csv
FPGA bốn seed (lần fit đầu), FAST_HIT | results/fpga_seed_summary_rfbht_p1.md, results/fpga_points_rfbht_p{1,2}.csv, results/le_r16_compare.log
Board DE2-115 | results/board_20261013/, results/board_20261013_independent_check/
ASIC DM RAM 16 KiB | results/asic_compare_dm_r14.md, results/gls_power_r14F_A_power.csv
Công suất exact-window | results/activity_power_exact_dm_20261013/receipt.json, results/activity_power_exact_sa2_20261014/receipt.json
LEC DM RAM 16 KiB | asic/equiv/lec/run_lec_r14.ps1, run_lec_r14_mul.ps1, run_lec_r14_pass2.ps1, asic/equiv/lec/runs.log
Tiền đề LEC (reset bất đồng bộ, giá trị không xác định) | results/lec_arst_audit_20261013/, results/lec_dm_xsens_20261013/
LEC SA2 | asic/equiv/lec/run_lec_sa2.ps1, results/lec_sa2_20261013/pass_comparison.json
LEC DM_VC4 | asic/equiv/lec/run_lec_vc4.ps1, sram_align.py, results/lec_vc4_20261014d/pass_comparison_goldn1.json
PD có cổng, watchdog và chẩn đoán | asic/run_gated_pd.sh, asic/drt_watch.sh, asic/fp_tools/gate_check.py, asic/gated_pd.log, asic/fp_tools/guide_demand.py, region_cells.py, NHAT_KY.md mục 8
DM_VC4 sàng lọc antenna | asic/soc_vc4_4kb/screen_ant_postdrt_v2_20261014/, screen_antgrt{10,20,30}_20261014/, screen_drt_replay_v2_20261014/
Đo lại SDC của bản cũ | asic/evidence/sdc_recheck_1kb_published/
Bản đã công bố | E:\Projects\RISCV-AHB-APB-UART\docs\en\results\FINAL_RESULTS.md, docs\en\asic\00_OVERVIEW.md, README.md

Số liệu lấy trực tiếp từ các file ở mục 16 ngày 14/10/2026 (bản 21:30). Trang này là bản ghi chung của toàn dự án: phần DM_VC4 ASIC, các lần chạy trọn nghiệm thu và 58 ca board còn lại được cập nhật khi có kết quả.
