vutoan1110/RISC-V-Cache4KB/results/dm_joint_invariant_20261010_verification.md

# Current gold joint invariant induction

Two independent native executions prove every one of the 286 recorded deasserted-phase obligations and reproduce every field and byte. I(Q) explicitly contains all 235 constant constraints, 28 duplicate equalities and four legal one-hot groups. All remaining raw state and inputs remain arbitrary symbolic values.

The 235 constant, 28 duplicate and three LCD legal-code closures are structural zero roots. The six AXI and fourteen ALU legal-code closures have exact CNF resolution proofs. This audit reconstructs every original conditional violation and separately replays saved resolution certificates, without running SAT anew.

| Obligation | Cases | Proved | UNKNOWN / counterexamples |
|---|---:|---:|---:|
| Constants | 235 | 235 | 0 / 0 |
| Duplicate equalities | 28 | 28 | 0 / 0 |
| Legal group codes | 23 | 23 | 0 / 0 |

The assumptions have explicit satisfying assignments. Completing free inputs with zero for one witness is not a zero-initialization axiom. Two actual-model rare 24-input fault controls satisfy every joint premise; the original raw LCD D code is [0, 0, 1] and the in-memory mutated code is [1, 1, 1]. A timeout, missing output or UNKNOWN cannot count as a negative-control pass.

Separate unrestricted synchronizer equations prove external reset 0 gives both D=0, and external reset 1 gives meta D=1 with sync D equal the current meta Q. Existing paired gold reset-base evidence is pinned. This report proves the deasserted phase only: arbitrary/interrupted reset-phase invariant closure remains OPEN.

The source undefined-zero Boolean abstraction gap, raw N1/final reset coupling, mapped boundaries and complete sequential RTL-to-netlist equivalence remain OPEN. The independently reviewed SAT kernel is frozen; independent review of this new joint substitution/premise construction is a separate pending receipt.

Every actual proof process had a kernel-enforced 512 MiB limit and each obligation a 10-second deadline, using fixed existing CNF budgets. Both actual native proof invocations and both actual-model controls exited 0. The complete proof process wall times were not captured when tool calls yielded and are not inferred from polling intervals.

Input, source and evidence hashes, exact completeness checks, protocol equations and execution records are retained in the companion JSON. No retained source, RTL, model or live PD/benchmark input was changed.
