vutoan1110/RISC-V-Cache4KB/results/lec_joint_invariant_independent_review_20261010.md

# Independent current-gold joint invariant review

The adjacent JSON reports the bounded review result and all286 exact targets
per execution:235 constant constraints,28 duplicate equalities and23 current
codes across the four legal one-hot groups. The two saved execution receipts
must be byte- and field-identical; every frozen input is checked before/after.

The reviewer independently extracts the raw-state partition and synchronizer
identities, applies only exact recorded duplicate aliases and constant premises,
and reconstructs all four simultaneous one-hot predicates. All other Q/input
symbols remain arbitrary. Both zero and one completions are used only as
explicit nonvacuity witnesses, never as an unreset-state axiom. Separate finite
truth tables compare aliasing with original graph evaluation and all four-group
predicate combinations; incorrect substitutions and contradictory premises are
rejected.

Every structural proof must reconstruct to literal0. Every saved CNF proof is
independently encoded and its empty-clause resolution certificate replayed.
Every SAT witness must satisfy the independent CNF, every original joint
premise and the original raw-model D violation. UNKNOWN remains unresolved.
No new SoC solve, external frontend, WSL process or input modification occurs.
The review process is hard-limited to256MiB.

This review covers only I(Q)=>I(D) with external and both synchronizer reset
symbols deasserted. It checks separate exact synchronizer equations and the
complete paired reset-base prerequisite without claiming closure for every
interrupted/arbitrary reset sequence. Undefined-to-zero source abstraction,
gate-model induction and full-chip sequential LEC remain OPEN. A closed
deasserted induction step is not an unconditional full equivalence verdict.
