vutoan1110/RISC-V-Cache4KB/results/unified_metrics.md

# Unified metrics (4 KiB caches, BP on)

Generated by scripts/metrics/unified_table.py. Current RTL: 6c4ccffd. Embench and CoreMark sources: results/rfbht_4kb_p{1,2}.csv and results/coremark_crc_checked_20261009/results_p{1,2}.csv; full iterations: results/upfull_r14_4kb_p{1,2}.csv. FPGA: results/fpga_points_fpga_common_seeds_continued_20261009_p{1,2}.csv. All 40 point/seed pairs agree on 115 hardware fields; runtime is excluded. The four configurations use the same seeds 1..10; this table uses common seed 2, fixed before the expanded experiment. Seeds 1, 3 and 4 retain the independent rfbht fits; seeds 5..10 and seed 2 were refitted twice. Seed-2 rows reproduce the original four-seed evidence exactly. The plan, completion receipt, row origins and report hashes are checked before publication. FPGA timing is Slow 1200 mV 85 C; power in the full matrix is a Quartus default toggle-rate estimate. Physical board session NOT RUN.

ASIC sign-off gate: DM and SA2 PASS in both runs; DM_VC4 has no signed-off result. The full gate and all nine named timing corners are in results/asic_ppa_verified_subset_20261010.md. ASIC activity power uses GLS -> SAIF -> OpenSTA at nom_tt_025C_1v80 with RCX SPEF. DM and SA2 each have two independent raw STA report sets for all 12 kernels. Their power receipt and raw reports are rechecked before inclusion; the SA2 minimum die remains unproved. The later raw-window audit found one extra 20 ns period in all 24 preserved DM/SA2 SAIFs; legacy win_t*_ns timestamps actually contain picoseconds. These paired STA values reproduce their preserved inputs; exact-window recapture and paired STA remain pending. Evidence: results/embench_gls_evidence_audit_20261010/receipt.json.

CoreMark is a CRC-validated full-program simulation counter with 32 KiB RAM; the window includes initialization, CRC validation and UART reporting. The supplement verifies source-known list/matrix/state CRCs from passive APB TXDATA captures in 22 actual simulations (11 independent pairs), with all 40 snapshot fields equal to the current reference. Its scope is the current six baseline points and five FAST_HIT points. Evidence: results/coremark_crc_checked_20261009/verification.json. ITERATIONS=1 is shorter than 10 seconds; these counts are not an official CoreMark score or an iterate-only measurement.

| metric | DM | SA2 | DM_VC4 | DM_DSE |
|---|---:|---:|---:|---:|
| CPI (12 Embench-IoT kernels) | 1.5136 | 1.6597 | 1.6780 | 1.6614 |
| I$ hit % | 99.70 | 99.65 | 99.72 | 99.70 |
| D$ read hit % | 99.16 | 99.59 | 99.59 | 99.16 |
| branch mispredict % | 10.57 | 10.57 | 10.57 | 10.57 |
| Embench speed / MHz, GM | 0.809 | 0.739 | 0.729 | 0.737 |
| Embench speed, GSD | 1.333 | 1.394 | 1.396 | 1.346 |
| code size vs reference, GM | 1.643 | 1.643 | 1.643 | 1.643 |
| code size, GSD | 1.280 | 1.280 | 1.280 | 1.280 |
| CoreMark program mcycle (CRC-validated simulation, RAM 32 KiB) | 2520901 | 2573624 | 2590590 | 2586274 |
| CoreMark numeric CRC gate (two independent simulations) | PASS | PASS | PASS | PASS |
| IRQ entry, cycles (steady) | 5 | 5 | 5 | 5 |
| IRQ entry, cycles (first, cold) | 41 | 41 | 41 | 41 |
| IRQ total, minimal handler | 39 | 39 | 39 | 39 |
| context switch total, cycles | 270 | 292 | 292 | 292 |
| FPGA LE (seed 2) | 12815 | 16689 | 17130 | 14340 |
| FPGA Fmax Slow 85C, MHz | 52.27 | 52.46 | 54.29 | 55.21 |
| ASIC-view mcycle vs FPGA view, % | -4.182 | -3.671 | -3.232 | - |
| GLS mcycle = ASIC-view RTL | 12/12 kernels = ASIC-view RTL (r14F_A) | 12/12 kernels = ASIC-view RTL (sa2_corr3400x3400_f220_capm20_fo16_pad1_tdp_clkm3_rsztf_ecomaxmin_r1) | pending (after PD) | N/A (no ASIC build) |
| board mcycle | NOT_RUN (physical session pending; common seed 2) | NOT_RUN (physical session pending; common seed 2) | NOT_RUN (physical session pending; common seed 2) | NOT_RUN (physical session pending; common seed 2) |
| ASIC power (GLS->SAIF, OpenSTA nom_tt) | 114.8-123.0 mW (mean 119.5), nom_tt, 12 kernels | 127.5-131.8 mW (mean 129.6), nom_tt, 12 kernels | pending sign-off + GLS + two STA passes | N/A (no ASIC build) |
| ASIC energy per instruction | 2612-6547 pJ (GM 3608) | 2848-7354 pJ (GM 4317) | - | - |
