vutoan1110/RISC-V-Cache4KB/results/asic_compare_dm_sa2_20261009.md

# ASIC comparison: DM vs SA2 vs DM_VC4 (4 KiB caches, 16 KiB RAM, sky130A hd, 20 ns)

Generated by scripts/metrics/asic_compare.py from the OpenLane run directories.

## Runs

| | DM | SA2 |
|---|---:|---:|
| design / runs | soc_dm_4kb r14F_A + r14F_B | soc_sa2_4kb sa2_corr3400x3400_f220_capm20_fo16_pad1_tdp_clkm3_rsztf_ecomaxmin_r1 + sa2_corr3400x3400_f220_capm20_fo16_pad1_tdp_clkm3_rsztf_ecomaxmin_r2 |
| double execution | A = B on 319 metrics | A = B on 319 metrics |

## Signoff gate (must be 0)

| | DM | SA2 |
|---|---:|---:|
| Magic DRC | 0 | 0 |
| KLayout DRC | 0 | 0 |
| Route DRC | 0 | 0 |
| LVS errors | 0 | 0 |
| XOR differences | 0 | 0 |
| Illegal overlaps | 0 | 0 |
| Antenna violating nets | 0 | 0 |
| Hold violations (all corners) | 0 | 0 |

## Timing (STAPostPNR; SRAM macros have TT liberty only, so ss/ff are optimistic through them)

| | DM | SA2 |
|---|---:|---:|
| setup WS nom_tt_025C_1v80 (ns) | 1.894 | 1.118 |
| setup WS max_tt_025C_1v80 (ns) | 1.708 | 0.838 |
| setup WS nom_ss_100C_1v60 (ns) | -6.897 | -7.304 |
| setup WS max_ss_100C_1v60 (ns) | -7.365 | -7.917 |
| setup WS nom_ff_n40C_1v95 (ns) | 4.611 | 4.056 |
| setup WS min_ff_n40C_1v95 (ns) | 4.811 | 4.262 |
| setup TNS nom_ss_100C_1v60 (ns) | -9714.2 | -11441.1 |
| setup TNS max_ss_100C_1v60 (ns) | -11438.7 | -13417.1 |
| hold WS nom_tt_025C_1v80 (ns) | 0.186 | 0.152 |
| hold WS min_ff_n40C_1v95 (ns) | 0.021 | 0.020 |

## Area

| | DM | SA2 |
|---|---:|---:|
| die area (um2) | 10628500 | 11560000 |
| core area (um2) | 10456500 | 11384800 |
| std-cell area (um2) | 1369600 | 1471070 |
| macro area (um2) | 3802010 | 3802010 |
| macro count | 16 | 16 |
| std-cell count | 197878 | 215979 |
| std-cell utilisation | 0.495 | 0.463 |
| wirelength (um) | 6585103 | 9274499 |

## Power, vectorless (OpenSTA default activity; NOT the activity-based number)

| | DM | SA2 |
|---|---:|---:|
| total nom_tt (mW) | 109.15 | 121.99 |
| internal nom_tt (mW) | 92.10 | 100.61 |
| switching nom_tt (mW) | 16.62 | 20.93 |
| leakage nom_tt (mW) | 0.44 | 0.44 |
| total nom_ss (mW) | 94.40 | 104.64 |
| total nom_ff (mW) | 120.89 | 135.81 |
