vutoan1110/RISC-V-Cache4KB/results/dm_onehot_boolean_20261010_verification.md

# Bounded current-model one-hot Boolean checks, 2026-10-10

Six current DM AXI transition obligations are proved in two independent Windows Python CLI executions. All fields and report bytes match. Each of the three current codes of `axi_last_grant` and `axi_source` produces exactly one next-state bit for every remaining symbolic input under the recorded conditions. No constant, duplicate, other one-hot group or unreset state was tied.

The fourteen `alu_ctrl_e` cases remain UNKNOWN. Their violation cones each have 911 symbolic input bits, exceeding the explicit 128-support bound; no BDD expansion was attempted for them. The first ALU cone has 4,047 AND nodes. A support bound says nothing about whether the invariant is true. Full sequential RTL-to-final-netlist LEC remains OPEN.

The exact graph is `asic/equiv/lec/gold_god_r14.aig`, SHA-256 `5a98a43b39f34756478caae81fba27df9184ce24d6a5a185ea1412f31732e7af`. Each case assigns only `reset_n=1`, `lec_q_p19088=1`, `lec_q_p19089=1`, and the selected group's own current one-hot code. Every other raw Q/input remains a free Boolean symbol, including `lec_q_g00088`. This is the existing AIG model after its original `setundef -undriven -zero` conversion; the source/undefined-value abstraction gap remains open. The earlier reset-base subproof and separate clock proof are unchanged.

The new solver builds an exact structurally hashed cofactor, then uses a canonical ordered reduced BDD for the violation (none or at least two next-state bits high). A zero BDD proves the named Boolean cofactor. A nonzero BDD requires a satisfying input assignment independently re-evaluated on the original cofactored AND/NOT DAG. Unsupported/resource-limited work remains UNKNOWN. Limits: own-process kernel memory 512 MiB, 128 symbolic support bits, 65,536 BDD nodes, 131,072 apply-cache entries and 10 seconds per obligation. Windows JobObject limits only the new proof process; no machine-wide setting or live flow was changed.

The CLI executions took 4.826 and 4.688 seconds for all twenty cases. They independently read and compute the same inputs; pass 2 is not a reread of pass 1. Both native exits were zero. Input/checker hashes were checked before and after each computation.

Checker controls: 25 fixtures, including independent Boolean truth functions for four expressions over all sixteen assignments, rare 24-input missing/duplicate one-hot faults with exact all-ones counterexamples, and separate rejection/UNKNOWN checks for missing inputs, extra premises and resource limits. Fixture results are verifier checks, not chip measurements.

An additional negative control executes twice on the actual pinned raw AXI cone. It first proves the unmodified baseline. Only in memory, two next-state bits are ORed with a trigger requiring twenty-four distinct unrestricted input bits all high. With the trigger low, the original cone is unchanged; with it high, at least two bits are high. Both executions find a real trigger-active witness and re-evaluate the original code as one-hot and the modified code as invalid. All control fields and bytes match; no RTL, AIG or old proof file was modified. Missing files, timeout, crash or UNKNOWN cannot satisfy this negative control.

Remaining whole-proof work: raw paired RTL/N1/final reset and symbolic initial-state relation, the fourteen current ALU transition cases (and other constant/duplicate restriction premises), exact front-end/recode/source-model bridges, undefined-cone coverage, and the complete sequential assembly of retained combinational/output/SRAM/multiplier evidence. No full-chip PASS or hardware defect is inferred. PD sign-off/power and running jobs are unaffected.

Windows `find_spec` finds no `z3`, `pysat` or `pyeda` package. No tool was installed. A possible next isolated hypothesis is exact Tseitin-CNF of each ALU violation asserted true, with bounded internal SAT search and original-DAG witness checking; this has not been executed.
