vutoan1110/RISC-V-Cache4KB/results/fpga_seed_summary_fpga_common_seeds_continued_20261009_p1.md

# Quartus, 10 common seeds: results/fpga_points_fpga_common_seeds_continued_20261009_p1.csv

Every field `run_fpga_points.py` scrapes. Required seeds: 1, 2, 3, 4, 5, 6, 7, 8, 9, 10. `spread` = max - min; `sd` is the sample standard deviation.

## dm_4kb

| Field | seed 1 | seed 2 | seed 3 | seed 4 | seed 5 | seed 6 | seed 7 | seed 8 | seed 9 | seed 10 | min | max | mean | sd | spread |
|---|---:|---:|---:|---:|---:|---:|---:|---:|---:|---:|---:|---:|---:|---:|---:|
| le | 12823 | 12815 | 12810 | 12842 | 12809 | 12825 | 12813 | 12800 | 12821 | 12802 | 12800 | 12842 | 1.282e+04 | 12.37 | 42 |
| le_margin | 7177 | 7185 | 7190 | 7158 | 7191 | 7175 | 7187 | 7200 | 7179 | 7198 | 7158 | 7200 | 7184 | 12.37 | 42 |
| comb | 11517 | 11517 | 11517 | 11517 | 11517 | 11517 | 11517 | 11517 | 11517 | 11517 | 11517 | 11517 | 1.152e+04 | 0 | 0 |
| regs | 7198 | 7198 | 7198 | 7198 | 7198 | 7198 | 7198 | 7198 | 7198 | 7198 | 7198 | 7198 | 7198 | 0 | 0 |
| mem_bits | 209664 | 209664 | 209664 | 209664 | 209664 | 209664 | 209664 | 209664 | 209664 | 209664 | 209664 | 209664 | 2.097e+05 | 0 | 0 |
| setup_slack | 1.876 | 0.87 | 1.987 | 1.857 | 1.65 | 1.547 | 1.732 | 1.812 | 1.7 | 2.199 | 0.87 | 2.199 | 1.723 | 0.3512 | 1.329 |
| fmax | 55.18 | 52.27 | 55.52 | 55.12 | 54.5 | 54.19 | 54.74 | 54.98 | 54.64 | 56.18 | 52.27 | 56.18 | 54.73 | 1.03 | 3.91 |
| map_le | 14701 | 14701 | 14701 | 14701 | 14701 | 14701 | 14701 | 14701 | 14701 | 14701 | 14701 | 14701 | 1.47e+04 | 0 | 0 |
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
| 9 | sa2_4kb | +3884 | -1.99 | +25.88 |
| 9 | vc4_4kb | +4327 | -0.49 | +25.04 |
| 10 | dse_4kb | +1519 | -5.16 | +11.55 |
| 10 | sa2_4kb | +3890 | -3.05 | +25.55 |
| 10 | vc4_4kb | +4304 | -3.88 | +24.63 |

## Completeness gate

- PASS: 4 points x 10 seeds, 115 fields each, none empty
