vutoan1110/RISC-V-Cache4KB/results/fpga_seed_summary_paired_method_4seed_20261009.md

# Quartus, 4 common seeds: results/fpga_points_rfbht_p1.csv

Every field `run_fpga_points.py` scrapes. Required seeds: 1, 2, 3, 4. `spread` = max - min; `sd` is the sample standard deviation.

## dm_4kb

| Field | seed 1 | seed 2 | seed 3 | seed 4 | min | max | mean | sd | spread |
|---|---:|---:|---:|---:|---:|---:|---:|---:|---:|
| le | 12823 | 12815 | 12810 | 12842 | 12810 | 12842 | 1.282e+04 | 14.06 | 32 |
| le_margin | 7177 | 7185 | 7190 | 7158 | 7158 | 7190 | 7178 | 14.06 | 32 |
| comb | 11517 | 11517 | 11517 | 11517 | 11517 | 11517 | 1.152e+04 | 0 | 0 |
| regs | 7198 | 7198 | 7198 | 7198 | 7198 | 7198 | 7198 | 0 | 0 |
| mem_bits | 209664 | 209664 | 209664 | 209664 | 209664 | 209664 | 2.097e+05 | 0 | 0 |
| setup_slack | 1.876 | 0.87 | 1.987 | 1.857 | 0.87 | 1.987 | 1.648 | 0.5215 | 1.117 |
| fmax | 55.18 | 52.27 | 55.52 | 55.12 | 52.27 | 55.52 | 54.52 | 1.512 | 3.25 |
| map_le | 14701 | 14701 | 14701 | 14701 | 14701 | 14701 | 1.47e+04 | 0 | 0 |
| map_comb | 11512 | 11512 | 11512 | 11512 | 11512 | 11512 | 1.151e+04 | 0 | 0 |
| map_regs | 7198 | 7198 | 7198 | 7198 | 7198 | 7198 | 7198 | 0 | 0 |
| le_comb_only | 5625 | 5617 | 5612 | 5644 | 5612 | 5644 | 5624 | 14.06 | 32 |
| le_reg_only | 1306 | 1298 | 1293 | 1325 | 1293 | 1325 | 1306 | 14.06 | 32 |
| le_comb_reg | 5892 | 5900 | 5905 | 5873 | 5873 | 5905 | 5892 | 14.06 | 32 |
| lut4 | 7836 | 7836 | 7836 | 7836 | 7836 | 7836 | 7836 | 0 | 0 |
| lut3 | 1759 | 1759 | 1759 | 1759 | 1759 | 1759 | 1759 | 0 | 0 |
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
| 3 | sa2_4kb | +3865 | -2.1 | +27.51 |
| 3 | vc4_4kb | +4320 | -1.43 | +26.82 |
| 4 | dse_4kb | +1522 | -1.37 | +7.21 |
| 4 | sa2_4kb | +3893 | -2.64 | +25.42 |
| 4 | vc4_4kb | +4297 | -0.72 | +23.14 |

## Completeness gate

- PASS: 4 points x 4 seeds, 115 fields each, none empty
