vutoan1110/RISC-V-Cache4KB/results/fpga_seed_summary_rfbht_p1.md

# Quartus, all four seeds: results/fpga_points_rfbht_p1.csv

Every field `run_fpga_points.py` scrapes, for seeds 1-4. `spread` = max - min over the four seeds.

## dm_4kb

| Field | seed 1 | seed 2 | seed 3 | seed 4 | min | max | mean | spread |
|---|---:|---:|---:|---:|---:|---:|---:|---:|
| le | 12823 | 12815 | 12810 | 12842 | 12810 | 12842 | 1.282e+04 | 32 |
| le_margin | 7177 | 7185 | 7190 | 7158 | 7158 | 7190 | 7178 | 32 |
| comb | 11517 | 11517 | 11517 | 11517 | 11517 | 11517 | 1.152e+04 | 0 |
| regs | 7198 | 7198 | 7198 | 7198 | 7198 | 7198 | 7198 | 0 |
| mem_bits | 209664 | 209664 | 209664 | 209664 | 209664 | 209664 | 2.097e+05 | 0 |
| setup_slack | 1.876 | 0.87 | 1.987 | 1.857 | 0.87 | 1.987 | 1.648 | 1.117 |
| fmax | 55.18 | 52.27 | 55.52 | 55.12 | 52.27 | 55.52 | 54.52 | 3.25 |
| map_le | 14701 | 14701 | 14701 | 14701 | 14701 | 14701 | 1.47e+04 | 0 |
| map_comb | 11512 | 11512 | 11512 | 11512 | 11512 | 11512 | 1.151e+04 | 0 |
| map_regs | 7198 | 7198 | 7198 | 7198 | 7198 | 7198 | 7198 | 0 |
| le_comb_only | 5625 | 5617 | 5612 | 5644 | 5612 | 5644 | 5624 | 32 |
| le_reg_only | 1306 | 1298 | 1293 | 1325 | 1293 | 1325 | 1306 | 32 |
| le_comb_reg | 5892 | 5900 | 5905 | 5873 | 5873 | 5905 | 5892 | 32 |
| lut4 | 7836 | 7836 | 7836 | 7836 | 7836 | 7836 | 7836 | 0 |
| lut3 | 1759 | 1759 | 1759 | 1759 | 1759 | 1759 | 1759 | 0 |
| lut2 | 1922 | 1922 | 1922 | 1922 | 1922 | 1922 | 1922 | 0 |
| le_normal | 9839 | 9839 | 9839 | 9839 | 9839 | 9839 | 9839 | 0 |
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
| pow_io_mw | 67.07 [67.03, 67.1] | 67.09 [67.07, 67.11] | 67.12 [67.08, 67.16] | 67.1 [67.08, 67.12] |

## Completeness gate

- PASS: 4 points x 4 seeds, 115 fields each, none empty
