vutoan1110/RISC-V-Cache4KB/results/ram_bank_definedness_independent_review_20261010.md

# Independent main-RAM bank default review

PASS: a separate module-scoped regex parser and MSB-first bit interpreter reconstructed all49 actual PMUX targets and their exact bank/OR-group selector cones. All392 free three-bit bank cases select exactly one original B word in source bank order. All98 actual copied-selector/data-order semantic controls were independently reconstructed and their witnesses re-evaluated. Current/signed source parameter, index-width and macro-instance bindings match. The two saved native executions match every field and byte; no ignored fields.

Selected B data and unreset/macro values stay arbitrary. This closes only the49 unused A-default origins after paired acceptance. It does not prove whole-Y definedness, RAM initial contents, source-X/four-state closure, reset/events or full-chip LEC. No new measurement, solve or frontend ran. Exact hashes, cone rows and memory are in the adjacent JSON.
