vutoan1110/RISC-V-Cache4KB/results/asic_compare_dm_r14.md

# ASIC comparison: DM vs SA2 vs DM_VC4 (4 KiB caches, 16 KiB RAM, sky130A hd, 20 ns)

Generated by scripts/metrics/asic_compare.py from the OpenLane run directories.

## Runs

| | DM |
|---|---:|
| design / runs | soc_dm_4kb r14F_A + r14F_B |
| double execution | A = B on 319 metrics |

## Signoff gate (must be 0)

| | DM |
|---|---:|
| Magic DRC | 0 |
| KLayout DRC | 0 |
| Route DRC | 0 |
| LVS errors | 0 |
| XOR differences | 0 |
| Illegal overlaps | 0 |
| Antenna violating nets | 0 |
| Hold violations (all corners) | 0 |

## Timing (STAPostPNR; SRAM macros have TT liberty only, so ss/ff are optimistic through them)

| | DM |
|---|---:|
| setup WS nom_tt_025C_1v80 (ns) | 1.894 |
| setup WS max_tt_025C_1v80 (ns) | 1.708 |
| setup WS nom_ss_100C_1v60 (ns) | -6.897 |
| setup WS max_ss_100C_1v60 (ns) | -7.365 |
| setup WS nom_ff_n40C_1v95 (ns) | 4.611 |
| setup WS min_ff_n40C_1v95 (ns) | 4.811 |
| setup TNS nom_ss_100C_1v60 (ns) | -9714.2 |
| setup TNS max_ss_100C_1v60 (ns) | -11438.7 |
| hold WS nom_tt_025C_1v80 (ns) | 0.186 |
| hold WS min_ff_n40C_1v95 (ns) | 0.021 |

## Area

| | DM |
|---|---:|
| die area (um2) | 10628500 |
| core area (um2) | 10456500 |
| std-cell area (um2) | 1369600 |
| macro area (um2) | 3802010 |
| macro count | 16 |
| std-cell count | 197878 |
| std-cell utilisation | 0.495 |
| wirelength (um) | 6585103 |

## Power, vectorless (OpenSTA default activity; NOT the activity-based number)

| | DM |
|---|---:|
| total nom_tt (mW) | 109.15 |
| internal nom_tt (mW) | 92.10 |
| switching nom_tt (mW) | 16.62 |
| leakage nom_tt (mW) | 0.44 |
| total nom_ss (mW) | 94.40 |
| total nom_ff (mW) | 120.89 |
