vutoan1110/RISC-V-Cache4KB/results/fpga_seed_summary_r14_p1.md

# Quartus, all four seeds: results/fpga_points_r14_p1.csv

Every field `run_fpga_points.py` scrapes, for seeds 1-4. `spread` = max - min over the four seeds.

## dm_4kb

| Field | seed 1 | seed 2 | seed 3 | seed 4 | min | max | mean | spread |
|---|---:|---:|---:|---:|---:|---:|---:|---:|
| le | 15456 | 15440 | 15509 | 15546 | 15440 | 15546 | 1.549e+04 | 106 |
| le_margin | 4544 | 4560 | 4491 | 4454 | 4454 | 4560 | 4512 | 106 |
| comb | 13903 | 13903 | 13903 | 13903 | 13903 | 13903 | 1.39e+04 | 0 |
| regs | 8430 | 8430 | 8430 | 8430 | 8430 | 8430 | 8430 | 0 |
| mem_bits | 206848 | 206848 | 206848 | 206848 | 206848 | 206848 | 2.068e+05 | 0 |
| setup_slack | 1.579 | 0.778 | 1.716 | 1.614 | 0.778 | 1.716 | 1.422 | 0.938 |
| fmax | 54.29 | 52.02 | 54.69 | 54.39 | 52.02 | 54.69 | 53.85 | 2.67 |
| map_le | 18066 | 18066 | 18066 | 18066 | 18066 | 18066 | 1.807e+04 | 0 |
| map_comb | 13898 | 13898 | 13898 | 13898 | 13898 | 13898 | 1.39e+04 | 0 |
| map_regs | 8430 | 8430 | 8430 | 8430 | 8430 | 8430 | 8430 | 0 |
| le_comb_only | 7026 | 7010 | 7079 | 7116 | 7010 | 7116 | 7058 | 106 |
| le_reg_only | 1553 | 1537 | 1606 | 1643 | 1537 | 1643 | 1585 | 106 |
| le_comb_reg | 6877 | 6893 | 6824 | 6787 | 6787 | 6893 | 6845 | 106 |
| lut4 | 9841 | 9841 | 9841 | 9841 | 9841 | 9841 | 9841 | 0 |
| lut3 | 2132 | 2132 | 2132 | 2132 | 2132 | 2132 | 2132 | 0 |
| lut2 | 1930 | 1930 | 1930 | 1930 | 1930 | 1930 | 1930 | 0 |
| le_normal | 12225 | 12225 | 12225 | 12225 | 12225 | 12225 | 1.222e+04 | 0 |
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
| pow_perf_counters_mw | 6.04 | 6.52 | 6.51 | 5.64 | 5.64 | 6.52 | 6.178 | 0.88 |
| pow_sysmon_mw | 2.74 | 2.73 | 2.83 | 2.7 | 2.7 | 2.83 | 2.75 | 0.13 |
| pow_uart_mw | 2.42 | 2.41 | 2.39 | 2.4 | 2.39 | 2.42 | 2.405 | 0.03 |
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
