vutoan1110/RISC-V-Cache4KB/results/fpga_seed_summary_r12b_p1.md

# Quartus, all four seeds: results/fpga_points_r12b_p1.csv

Every field `run_fpga_points.py` scrapes, for seeds 1-4. `spread` = max - min over the four seeds.

## dm_4kb

| Field | seed 1 | seed 2 | seed 3 | seed 4 | min | max | mean | spread |
|---|---:|---:|---:|---:|---:|---:|---:|---:|
| le | 15555 | 15529 | 15584 | 15532 | 15529 | 15584 | 1.555e+04 | 55 |
| le_margin | 4445 | 4471 | 4416 | 4468 | 4416 | 4471 | 4450 | 55 |
| comb | 13902 | 13902 | 13902 | 13902 | 13902 | 13902 | 1.39e+04 | 0 |
| regs | 8430 | 8430 | 8430 | 8430 | 8430 | 8430 | 8430 | 0 |
| mem_bits | 141312 | 141312 | 141312 | 141312 | 141312 | 141312 | 1.413e+05 | 0 |
| setup_slack | 1.557 | 1.661 | 0.806 | 0.235 | 0.235 | 1.661 | 1.065 | 1.426 |
| fmax | 54.22 | 54.53 | 52.1 | 50.59 | 50.59 | 54.53 | 52.86 | 3.94 |
| map_le | 18065 | 18065 | 18065 | 18065 | 18065 | 18065 | 1.806e+04 | 0 |
| map_comb | 13897 | 13897 | 13897 | 13897 | 13897 | 13897 | 1.39e+04 | 0 |
| map_regs | 8430 | 8430 | 8430 | 8430 | 8430 | 8430 | 8430 | 0 |
| le_comb_only | 7125 | 7099 | 7154 | 7102 | 7099 | 7154 | 7120 | 55 |
| le_reg_only | 1653 | 1627 | 1682 | 1630 | 1627 | 1682 | 1648 | 55 |
| le_comb_reg | 6777 | 6803 | 6748 | 6800 | 6748 | 6803 | 6782 | 55 |
| lut4 | 9810 | 9810 | 9810 | 9810 | 9810 | 9810 | 9810 | 0 |
| lut3 | 2131 | 2131 | 2131 | 2131 | 2131 | 2131 | 2131 | 0 |
| lut2 | 1961 | 1961 | 1961 | 1961 | 1961 | 1961 | 1961 | 0 |
| le_normal | 12224 | 12224 | 12224 | 12224 | 12224 | 12224 | 1.222e+04 | 0 |
| le_arith | 1678 | 1678 | 1678 | 1678 | 1678 | 1678 | 1678 | 0 |
| io_regs | 0 | 0 | 0 | 0 | 0 | 0 | 0 | 0 |
| labs | 1163 | 1170 | 1165 | 1172 | 1163 | 1172 | 1168 | 9 |
| pins | 81 | 81 | 81 | 81 | 81 | 81 | 81 | 0 |
| m9k | 18 | 18 | 18 | 18 | 18 | 18 | 18 | 0 |
| mem_impl_bits | 165888 | 165888 | 165888 | 165888 | 165888 | 165888 | 1.659e+05 | 0 |
| mult9 | 8 | 8 | 8 | 8 | 8 | 8 | 8 | 0 |
| plls | 0 | 0 | 0 | 0 | 0 | 0 | 0 | 0 |
| global_clocks | 2 | 2 | 2 | 2 | 2 | 2 | 2 | 0 |
| interconnect_avg_pct | 6.3 | 6.4 | 6.5 | 6.4 | 6.3 | 6.5 | 6.4 | 0.2 |
| interconnect_peak_pct | 54.1 | 47.7 | 49.4 | 52.5 | 47.7 | 54.1 | 50.93 | 6.4 |
| fanout_max | 8464 | 8464 | 8464 | 8464 | 8464 | 8464 | 8464 | 0 |
| fanout_max_nonglobal | 1026 | 1026 | 1026 | 1026 | 1026 | 1026 | 1026 | 0 |
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
