vutoan1110/RISC-V-Cache4KB/asic/snapshots/rtl_rfbht/hdl/perf_counters.v

// Performance / event counter bank.
// Cycle counters are mutually exclusive; event counters are independent.
// All counters are mod-2^32 and share one clear/freeze boundary.
module perf_counters #(
    // 0 holds the whole bank at zero so synthesis can remove it, which is how
    // the core's own area is measured apart from the instrumentation's.
    parameter integer PERF_COUNTERS_ENABLE = 1
)(
    input  wire        clk,
    input  wire        reset_n,
    input  wire        counter_clear,
    input  wire        counter_freeze,

    // Raw cycle causes from the core and memory system.
    input  wire        retire_event,
    input  wire        load_use_stall,
    input  wire        icache_wait,
    input  wire        dcache_wait,
    input  wire        control_redirect_event,
    input  wire        trap_redirect_event,
    input  wire        mmio_wait,
    input  wire        pipeline_nonempty,

    // Cache/bus events (CPU-request events, not refill beats).
    input  wire        icache_access_event,
    input  wire        icache_hit_event,
    input  wire        icache_miss_event,
    input  wire        dcache_read_access_event,
    input  wire        dcache_read_hit_event,
    input  wire        dcache_read_miss_event,
    input  wire        dcache_write_access_event,
    input  wire        dcache_write_hit_event,
    input  wire        dcache_write_miss_event,
    input  wire        icache_main_hit_event,
    input  wire        icache_victim_hit_event,
    input  wire        icache_true_miss_event,
    input  wire        dcache_main_hit_event,
    input  wire        dcache_victim_hit_event,
    input  wire        dcache_true_miss_event,
    input  wire        mispredict_event,
    input  wire        conditional_branch_event,
    input  wire        branch_taken_event,
    input  wire        branch_not_taken_event,
    input  wire        branch_prediction_event,
    input  wire        branch_correct_prediction_event,
    input  wire        axi_read_txn_event,
    input  wire        axi_write_txn_event,
    input  wire [31:0] trap_mcause,

    // one-hot: [0]RETIRE [1]LOAD_USE [2]I_WAIT [3]D_WAIT [4]CONTROL_REDIRECT
    //          [5]TRAP_REDIRECT [6]MMIO_WAIT [7]PIPE_FILL_DRAIN [8]OTHER
    output reg  [8:0]  cycle_reason_onehot,

    output reg  [31:0] mcycle_count,
    output reg  [31:0] retire_cycle_count,
    output reg  [31:0] load_use_cycle_count,
    output reg  [31:0] icache_wait_cycle_count,
    output reg  [31:0] dcache_wait_cycle_count,
    output reg  [31:0] control_redirect_cycle_count,
    output reg  [31:0] trap_redirect_cycle_count,
    output reg  [31:0] mmio_wait_cycle_count,
    output reg  [31:0] pipe_fill_drain_cycle_count,
    output reg  [31:0] other_cycle_count,

    output reg  [31:0] minstret_count,
    output reg  [31:0] icache_access_count,
    output reg  [31:0] icache_hit_count,
    output reg  [31:0] icache_miss_count,
    output reg  [31:0] dcache_read_access_count,
    output reg  [31:0] dcache_read_hit_count,
    output reg  [31:0] dcache_read_miss_count,
    output reg  [31:0] dcache_write_access_count,
    output reg  [31:0] dcache_write_hit_count,
    output reg  [31:0] dcache_write_miss_count,
    output reg  [31:0] icache_main_hit_count,
    output reg  [31:0] icache_victim_hit_count,
    output reg  [31:0] icache_true_miss_count,
    output reg  [31:0] dcache_main_hit_count,
    output reg  [31:0] dcache_victim_hit_count,
    output reg  [31:0] dcache_true_miss_count,
    output reg  [31:0] control_redirect_event_count,
    output reg  [31:0] mispredict_event_count,
    output reg  [31:0] conditional_branch_count,
    output reg  [31:0] branch_taken_count,
    output reg  [31:0] branch_not_taken_count,
    output reg  [31:0] branch_prediction_count,
    output reg  [31:0] branch_correct_prediction_count,
    output reg  [31:0] trap_event_count,
    output reg  [31:0] axi_read_txn_count,
    output reg  [31:0] axi_write_txn_count,
    output reg  [31:0] last_mcause
);

// ---------------------------------------------------------------------------
// Register stage on the event signals (critical-path relief).
//
// REASON: post-routing STA showed the path
//     datapath.valid_w -> u_observability.retire_cycle_count[30]
// missing setup by -11.579 ns at corner nom_ss_100C_1v60, across 56 logic levels.
//     7.47 -> 22.0 ns  event and stall computation inside the core   (14.5 ns)
//     22.0 -> 29.0 ns  the 9-level priority chain below             ( 7.0 ns)
//     29.0 -> 37.5 ns  the counter's 32-bit carry chain             ( 8.5 ns)
// The budget is 19.6 ns. Cutting at the module boundary splits it into 14.5 and 15.5 ns.
//
// WHY THIS DOES NOT CHANGE FUNCTION:
//  - These are OBSERVABILITY counters, read over APB. A one-cycle delay leaves every
//    TOTAL unchanged; the observation simply arrives one cycle later.
//  - The invariant "mcycle_count == sum of the 9 cycle counters" still holds: mcycle and
//    all 9 counters increment exactly once per cycle, so any delay leaves the sums equal.
//  - Out of reset, all 8 _q cause signals are 0, so the priority block falls through to
//    the else branch -> OTHER. Still one-hot, so no assertion is violated.
//  - counter_clear / counter_freeze are DELIBERATELY not registered: they gate the whole
//    block uniformly, and registering them would only add a pointless cycle of skew.
//  - trap_mcause MUST be registered in the same cycle as trap_redirect_event, otherwise
//    the wrong mcause value gets latched.
reg retire_event_q;
reg load_use_stall_q;
reg icache_wait_q;
reg dcache_wait_q;
reg control_redirect_event_q;
reg trap_redirect_event_q;
reg mmio_wait_q;
reg pipeline_nonempty_q;
reg icache_access_event_q;
reg icache_hit_event_q;
reg icache_miss_event_q;
reg dcache_read_access_event_q;
reg dcache_read_hit_event_q;
reg dcache_read_miss_event_q;
reg dcache_write_access_event_q;
reg dcache_write_hit_event_q;
reg dcache_write_miss_event_q;
reg icache_main_hit_event_q;
reg icache_victim_hit_event_q;
reg icache_true_miss_event_q;
reg dcache_main_hit_event_q;
reg dcache_victim_hit_event_q;
reg dcache_true_miss_event_q;
reg mispredict_event_q;
reg conditional_branch_event_q;
reg branch_taken_event_q;
reg branch_not_taken_event_q;
reg branch_prediction_event_q;
reg branch_correct_prediction_event_q;
reg axi_read_txn_event_q;
reg axi_write_txn_event_q;
reg [31:0] trap_mcause_q;
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
