vutoan1110/RISC-V-Cache4KB/asic/snapshots/rtl_rfbht/hdl/riscv_core_native.v

module riscv_core_native #(
    parameter integer BRANCH_PREDICT_ENABLE = 1,
    parameter integer BHT_ENTRIES = 256
)
(
    input         clk,
    input         reset_n,
    input         irq_timer,

    // Native instruction port (one request outstanding).
    output        if_req_valid,
    output [31:0] if_req_addr,
    input         if_req_ready,
    input         if_rsp_valid,
    input  [31:0] if_rsp_data,
    input         if_rsp_error,

    // Native data port (stores also get a response).
    output        d_req_valid,
    output        d_req_write,
    output [31:0] d_req_addr,
    output [31:0] d_req_wdata,
    output [3:0]  d_req_wstrb,
    input         d_req_ready,
    input         d_rsp_valid,
    input  [31:0] d_rsp_rdata,
    input         d_rsp_error,

    output        trap_taken,
    output [31:0] mcause_dbg,
    output [31:0] mepc_dbg,
    output [31:0] mtvec_dbg,
    output [31:0] mcycle_dbg,
    output [31:0] minstret_dbg,
    output [31:0] load_stall_dbg,
    output [31:0] branch_flush_dbg,
    output [31:0] control_redirect_dbg,
    output        retire_event_dbg,
    output        load_use_stall_event_dbg,
    output        control_redirect_event_dbg,
    output        mispredict_event_dbg,
    output        conditional_branch_event_dbg,
    output        branch_taken_event_dbg,
    output        branch_not_taken_event_dbg,
    output        branch_prediction_event_dbg,
    output        branch_correct_prediction_event_dbg,
    output        pipeline_nonempty_dbg,
    output        retire_valid,
    output [63:0] retire_order,
    output [31:0] retire_pc,
    output [31:0] retire_pc_next,
    output [31:0] retire_instr,
    output [4:0]  retire_rs1_addr,
    output [31:0] retire_rs1_rdata,
    output [4:0]  retire_rs2_addr,
    output [31:0] retire_rs2_rdata,
    output [4:0]  retire_rd_addr,
    output [31:0] retire_rd_wdata,
    output        retire_rd_we,
    output        retire_mem_valid,
    output        retire_mem_write,
    output [31:0] retire_mem_addr,
    output [31:0] retire_mem_wdata,
    output [3:0]  retire_mem_wstrb,
    output        retire_trap,
    output        retire_interrupt,
    output [31:0] pc_f_dbg,
    output        if_wait_dbg,
    output        d_wait_dbg,
    output reg    if_error_dbg,
    output reg    d_error_dbg
);

wire [31:0] pc_f;
wire [31:0] instr;
wire        mem_wr_m;
wire        mem_rd_m;
wire [31:0] alu_result_m;
wire [31:0] wr_data_m;
wire [31:0] rd_data;
wire [2:0]  mem_funct3_m;
wire        stall_pipe;
wire        mem_access;
wire        pipeline_advance;

reg         if_pending;
reg         if_buffer_valid;
reg  [31:0] if_buffer_data;
reg         d_pending;
reg         d_buffer_valid;
reg  [31:0] d_buffer_data;
reg         d_pending_posted;
reg         d_store_ack_valid;
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
