vutoan1110/RISC-V-Cache4KB/(commit log)

2026-09-30 final3 baseline: signed-off 8 KiB design (golden snapshot 2026-09-28)
    Tree of RISCV-research_GOLDEN_FINAL3_20260928, the preserved state before
    the experimental phase: RTL, firmware, testbenches, UVM, scripts, Quartus
    projects, the local OpenLane 2 copy, PD configs (final3_A/B), GLS, LEC and
    STA query scripts, and the flow journals.
    Generated data is not tracked: PD runs, SRAM macros, Quartus databases,
    simulator libraries, waveforms and result dumps (see .gitignore).
    [dut_directed.csv, executed_seeds.csv, lint_baseline.tsv, lint_baseline_a0c425f8.tsv, macro_placement.cfg, macro_placement_channels.cfg, macro_placement_grid.cfg, pin_order.cfg]
2026-09-30 PD experiments after final3 (Incident 93): hold ECO, macro pin buffers, E1-E6, R13a/R13b
    Experimental phase on top of the final3 baseline. Hardware RTL (hdl/) is
    unchanged; the changes are in the local OpenLane copy, PD configs and
    experiment scripts:
    - openlane-local: new steps OpenROAD.MacroPinBuffers (buffers on selected
    SRAM macro pins, placed outside the macro edge) and
    OpenROAD.PostRouteHoldECO (RCX SPEF, repair_timing -hold, placement
    lock + DPL, rip-up and reroute of ECO nets, antenna loop). Both are off
    by default (RUN_MACRO_PIN_BUFFERS, RUN_POST_ROUTE_HOLD_ECO).
    - set_rc / repair_design scripts: LAYERS_RC override scope and separate
    post-GPL / post-GRT cap margins.
    - asi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
2026-09-30 R14: main RAM 8 KiB -> 16 KiB, 12 upstream Embench kernels, R14 PD configs
    Full change list and verification record: RAM16K_CHANGES.md.
    - RTL: IMEM/DMEM depth 2048 words; axi_ram_32 DEPTH_WORDS 4096; the ASIC
    RAM wrapper derives the bank count from DEPTH_WORDS (8 x 2 KiB OpenRAM
    banks) and loads its ASIC-view init per bank.
    - Software: 16 KiB linker script, platform RAM size, hex/MIF tools;
    sw/embench_upstream holds 12 upstream Embench-IoT kernels (GPL-3.0,
    research tree only) run through sw/main_upstream.c; sw/*ramsweep*
    tests every RAM word from firmware.
    - Testbenches and UVM sized for 16 KiB; ASIC-view checkers use the bank
    address width from DEPTH_WORDS.
    - GLS: +define+GLS_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
    [macro_placement_grid_r14.cfg]
2026-09-30 Area recovery: std-cell area waterfall, post-CTS hold histogram, E14/E15/F3_H1
    - pd_exp/area/area_waterfall.py splits std-cell area by origin (synthesis,
    resizer sizing, taps, diodes, clock tree, hold, repair_design and
    repair_timing buffers, macro pin buffers); the totals match the flow's
    design__instance__area__stdcell exactly for final3_A, r14_A and r14_E10.
    E10 vs final3: +145.1k um2, of which +84.4k are long-wire repeaters; both
    designs carry 18-19k hold buffers (12-13.6 % of std-cell area).
    - pd_exp/hold_hist: the hold slack seen by ResizerTimingPostCTS before it
    repairs anything. 17,341 E10 endpoints sit below the 0.1 ns margin but
    only 972 below 0.03 ns and 51 below 0.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
2026-09-30 Remove the project's own Embench-style kernels; standard Embench-IoT only
    The review (danh_gia.txt, A6) asked for standard benchmarks. The twelve
    project kernels (crc32, depthconv, edn, fdct, huffbench, insertsort,
    matmult, md5sum, mont64, sha256, tarfind, wikisort) and the wikisort
    trace variant are removed from sw/ and fw/ (52 files). The benchmark
    suite is the upstream Embench-IoT set in sw/embench_upstream (sources
    byte-identical to embench-iot 09c2ed8c except the LOCAL_SCALE_FACTOR
    override wrapper): every kernel of that suite that fits the 16 KiB RAM.
    - Makefile, run_ablation.py, run_crossval.py, build_fw_r14.sh and the
    GLS runners/testbench now default to the up_* kernels.
    - fw_boa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
2026-09-30 PD: E12-E15 and F3_H1 results in FLOW_JOURNAL Incident 95, E16 (E15 + E14 hold margins + E13 CTS clustering); cross-check and runner options
2026-10-02 R15: four-way set associativity (CACHE_CONFIG 4 = SA4, 5 = SA2N check), verified
    - hdl/cache/{d,i}cache_nway_core.v: N-way core (2 or 4 ways, tree pseudo-LRU); one generate
    branch in dcache.v / icache.v for CACHE_CONFIG >= 4. Configurations 0-3 elaborate the R14
    modules unchanged.
    - Lint fix before the freeze: valid_v indexed by {way, set} concatenation (same bits).
    - Verification chain scripts/run_fullchain_r15.sh on the final RTL (manifest 225 files,
    aggregate d409b09d0fa208109f648e507eec20ea): 0 failures. Latch/lint over 18 combinations,
    regression 129/129 x2, UVM 5/5 x2, Embench 72/72 x2 with configurations 0-3 identical to R14
    and SA2N = SA2, CoreMark x2, random differential 5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
    [alu.v, aludec.v, apb_display_regs.v, apb_performance_monitor.v, apb_timer.v, axi_lite_to_apb.v, axi_ram_32_asic_macro.v, baudrate_gen_block.sv]
2026-10-02 ASIC builds for SA2 and DM_VC4 (FLOW_JOURNAL Incidents 96-97); final R14 DM configuration
    - asic/dse_sram/cache_dse_data_bank_sram.v: the DSE data bank on sky130 32x256 OpenRAM macros,
    supplied by module name (no hdl/ change). 256 sets: one macro per lane; 128 sets (SA2): two
    lanes per macro, the second read on port 0 while it is not writing -> 4 macros per cache, as
    DM. A simulation-only register-bank shadow compares rd_line every cycle.
    - asic/soc_sa2_4kb, asic/soc_vc4_4kb: tops (DM top with CACHE_CONFIG 1 / 2), configs equal to
    config_R14_FINAL.json except the cache organisation, the same die and 16 macro coordinates.
    - ASIC-view verification (scripts/metrics/run_dse_asic_view.sh,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
    [macro_placement.cfg]
2026-10-02 Metrics: interrupt latency / context switch, ACT4 rerun with archived logs, unified table
    - sw_metrics/irq (outside the RTL manifest roots): firmware with a minimal handler and an
    RTOS-style full context switch (31 GPRs + mepc), under register-only and memory-bound work;
    every phase checks that interrupts were transparent. tb_irq_metrics.sv timestamps the RTL
    events (timer line, irq_accept, handler entry, mret, resume). FPGA view, 4 KiB, CACHE_CONFIG
    0-3 x2, all pass, pass 1 = pass 2: entry 5 cycles, minimal interruption 39, context switch
    270 (DM) / 292 (DSE core) cycles (results/irq_metrics.csv).
    - ACT4 (riscv-arch-test 2e655961, reference Spike): 43/43 self-checking ELFs pass x2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
2026-10-02 R15 Quartus x2 (seed 2) and R14 DM full-flow results in the journals
    - scripts/run_le_r15.sh: pass 1 = pass 2 on 7 of 7 points; dm_4kb under R15 reproduces the R14
    row on all 115 fields except the runtime. New points: sa4_4kb 21,821 LE, dm_8kb 16,812,
    sa2_8kb 23,629, vc4_8kb 22,262, dse_8kb 19,364, sa4_8kb 28,891; every point meets 50 MHz at
    Slow 85C. Quartus project files of the new points.
    - r14F_A / r14F_B (config_R14_FINAL, both resumed after the session ended): A = B on 319 flow
    metrics, final netlists byte-identical to r14_E16; signoff gate clean (Magic / KLayout / route
    DRC 0, LVS 0, XOR 0, antenna 0, hold 0); max_tt +1.708 ns, max_ss -7.365 ns; std-cell
    1.3696 mm2. Not a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
2026-10-02 Incident 96: wide/density/ring floorplan exploration for SA2 and DM_VC4; ring1 queue
    - fp_tools/: routability proxies (RUDY, util, pin density), block-to-block wire traffic,
    ring floorplan generator; screening results in *_explore_proxy.txt
    - VC4 wide floorplan overflows GRT by 34,086 (tag-array clusters at channel junctions;
    OpenRAM macros block met1-met4); density sweep 36/32/28 insufficient
    - ring1 floorplan (3200 x 3190 um, 10.21 mm2): GRT screening overflow 0 for DM, SA2, VC4
    - run_ring_pd.sh: double-executed full flows on ring1 in two phases with a DRT memory gate
    - openlane-local: PWR_CONN_SKIP_SYNTH_REMOVED (SetPowerConnections)
    [macro_placement_ring1.cfg, macro_placement_ring2.cfg, macro_placement_wide.cfg]
2026-10-06 R16 FAST_HIT (review M1) with the full verification chain; M1/M2 cache design-space sweep
    - hdl: parameter FAST_HIT (default 0) in the DSE and N-way cores, CACHE_FAST_HIT on soc_top /
    de2_115_top / benchmark TB; with 1 a main-array hit is answered in ST_LOOKUP (the DM controller's
    hit latency). Sim-only per-cycle checker in each core. Applied by scripts/r16_fasthit/apply_r16.py
    after a dry run; manifest c09143ea (hdl ea3ef852 + new tests).
    - Formal (asic/equiv/r16_eq): 24 module checks (16 equivalent at FAST_HIT 0, 8 negative controls
    detected) and SoC level DM / SA2 / DM_VC4 PD inputs == R16 (35,067 / 36,741 / 37,441 cells,
    0 unproven; SoC negative control 1,824 unproven). Gate re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
    [fpga_points_r16_p1.csv, fpga_points_r16_p2.csv, sweep_fast_p1.csv, sweep_fast_p2.csv, sweep_p1.csv, sweep_p2.csv]
2026-10-06 Incident 96: unified floorplan deep dive for DM / SA2 / DM_VC4 (U2 family, 50-iteration GRT)
    - explore_fp3.sh / explore_grt50.sh: screening with the default 50 GRT overflow iterations (the
    15-iteration number was pessimistic for DM_VC4 and optimistic for SA2); fp_tools/grt_congestion.tcl +
    congestion_map.py locate overflow; fp_summary.py tabulates dse_pd.log.
    - Root cause for SA2: the OpenRAM macro has port 0 on the bottom edge and dout1 on the top edge; SA2
    drives both ports, so the 120 um gap between the cache-macro rows overflowed (U2a: 3,588).
    make_u2_fp.py gains orientation F (upper row FS) and the gap is widened to 220 um.
    - Result: u2fg33 (3400 x 3325 um, 11.31 mm2) overflow S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
    [macro_placement_strata1.cfg, macro_placement_u2a.cfg, macro_placement_u2b.cfg, macro_placement_u2f.cfg, macro_placement_u2f4.cfg, macro_placement_u2fg.cfg, macro_placement_u2fg3.cfg, macro_placement_u2fg33.cfg]
2026-10-07 Cleanup part 3: asic/ top level and experiment folders
    - Delete 68 one-off launch, probe and resume scripts; runs now go through
    run_pd_mk.sh, run_gated_pd.sh, run_gated_resume.sh or run_resume_retry.sh.
    - Move the floorplan screening drivers to fp_tools/screen_floorplan.sh and
    fp_tools/screen_grt.sh with accurate headers; merge the three route-proxy
    files into fp_explore/route_proxy.txt.
    - Archive 178 console logs and the experiment folders (eqy_standalone,
    repro_grt, repro_rsz, synth_explore_logs, pending_rtl_fixes, backups,
    pd_exp outputs) in results/pd_run_archive/, then delete them; gzip the
    large R16 formal logs; drop the RTLIL intermediates.
    - Track the deletion manifest a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
2026-10-07 Docs: one history, one procedures file, English results and review response
    - NHAT_KY.md: single chronological history (RTL, verification, FPGA, PD) with
    each event once, a register of known issues, the cleanup log and the table
    from old run / revision names to content-based names.
    - QUY_TRINH.md: every standing rule and run procedure (verification chain,
    gated PD flow and gate thresholds, FPGA, power, golden protocol, naming,
    cleanup, reporting).
    - RESULTS.md, REVIEW_RESPONSE.md, README.md rewritten in English.
    - asic/evidence/MAGIC_NAMESPACE_COLLISION.md keeps the Magic fix evidence; the
    macro preparation and proof tools are now tracked.
    - Removed the merged documents (journals,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
    [macro_placement_corr3600x3400_f220.cfg, macro_placement_corr3800x3400_f220.cfg]
2026-10-07 Scripts: point comments at NHAT_KY.md, drop one-off cleanup and rerun scripts
    Comments that cited the removed journals (FLOW_JOURNAL incidents, NHAT_KY_RTL)
    now cite NHAT_KY.md by date or section; gate comments use the gate names of
    QUY_TRINH.md. Removed one-off scripts (old cleanup runners, golden snapshot v1,
    2026-09-18 rerun scripts); git keeps them. RTL, testbenches, frozen snapshots
    and proof scripts are unchanged.
2026-10-07 Cleanup part 4: obsolete experiment configs and floorplans, unused 1 KiB design dirs
    Deleted 84 configs and 45 floorplans of experiments whose runs are gone (git
    keeps them; the resolved configs are in results/pd_run_archive/<run>/); kept
    the 21 configs and 14 floorplans used by kept runs, scripts and the running
    flows. Removed the unused 1 KiB design directories (untracked; text files
    archived). Logged in results/cleanup_deleted.txt and NHAT_KY.md section 10.
    [macro_placement.cfg, macro_placement_channels.cfg, macro_placement_ring1.cfg, macro_placement_ring2.cfg, macro_placement_strata1.cfg, macro_placement_u2a.cfg, macro_placement_u2b.cfg, macro_placement_u2f.cfg]
2026-10-15 Research state 2026-10-15: PD on RTL 6c4ccffd, LEC SA2 / DM_VC4, audits, rerun drivers
    - PD configs read snapshot rtl_rfbht (manifest 6c4ccffd) including the frozen SA2 / DM_VC4 ASIC wrappers;
    SA2 macro placement with the R15/R16 cache macro names (genblk1)
    - gated PD sequences, drt_watch antenna-round rules, scripts/metrics/compare_signoff_runs.py
    - LEC: SA2 complete; DM_VC4 synthesis part (sram_align.py, run_lec_vc4.ps1, prepare_vc4_lec.py)
    - exact-window activity power scripts, review status, extension list, RTL consistency audit
    - re-execution drivers on 6c4ccffd: M1/M2 sweep (--out), A8, A3, A4, IRQ (irq_metrics_table --logs/--out)
    - archive-and-delete script for failed PD runs; ignor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
    [macro_placement_corr3400x3100_f220.cfg, macro_placement_corr3400x3100_n120.cfg, macro_placement_corr3400x3250_f220.cfg, macro_placement_corr3400x3250_n120.cfg, macro_placement_corr3400x3325_f220.cfg, macro_placement_corr3500x3400_f220.cfg, macro_placement_corr3500x3400_f220_pad1.cfg, macro_placement_u2fg_rtl6c4c.cfg]
2026-10-15 NHAT_KY_v2.md: history rewritten by topic (CLOUD_TASKS task 1)
    RTL revision table, verification sets, FPGA and board (42-case table),
    ASIC run tables per configuration, LEC, activity power, known issues,
    rename table, cleanup log and dated deliverables. Results on RTL older
    than 6c4ccffd are marked historical; machine faults are worded neutrally.
    NHAT_KY.md is unchanged.
    Claude-Session: https://claude.ai/code/session_01PoxgpsS5wP8JMSSvoBwK3y
2026-10-15 RESULTS / REVIEW_RESPONSE: restructure, RTL provenance, wording fixes
    - provenance table and [current]/[historical] labels per result
    - verification summary table; standard CoreMark moved under architecture
    - board: 42 cases = 4 ramsweep + 9 kernels x 4 + 2 statemate, 41 display
    read-backs, one scheduled pass, 58 left
    - ASIC synthesis boundary: 6c4ccffd = R16 (da06d38f), not R14 PD (fc555d6b)
    - SA2 exact-window power done (binds the R14 layout); snapshot 44 -> 47 files
    - 2026-10-14 process rule; stock EQY vs custom register-mapped LEC
    - revision history with dates
    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
2026-10-15 PROJECT_STATE / README: overview tables, state log, 6c4ccffd task order
    - PROJECT_STATE: overview table, per-area state, running-jobs table, dated
    update blocks condensed into a state log, tasks re-ordered for the
    6c4ccffd plan (T13 PD acceptance, T14 re-runs), superseded procedures
    replaced by the current ones, revision history
    - README: document table with languages, configuration and status tables,
    reference designs, reproduction commands, neutral host-probe wording
    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
2026-10-15 QUY_TRINH / WORKSPACE_MAP: rule timeline, grouped PD procedures, current state
    - QUY_TRINH: dated rule timeline, opt-in gate variables table, PD section
    split into groups, superseded 2026-10-13 rule removed, one-RTL rule,
    rtl_rfbht snapshot, DM_VC4 / 6c4ccffd LEC scripts
    - WORKSPACE_MAP: sections 3/4/7/9 updated to the 2026-10-15 state
    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
2026-10-15 Docs: merge duplicate-function documents
    - CLOUD_TASKS.md -> PROJECT_STATE.md (cloud-session rule, state log)
    - results/review_status_20261014.md and
    results/extensions_vs_published_1kib_20261014.md -> REVIEW_RESPONSE.md
    (per-point status of all 20 points, revision-plan map, risks, appendix
    of the 38 extensions with corrected references)
    - removed superseded documents (kept in git history): CODEX_PROMPT.md,
    results/bao_cao_trang_thai_20261010.md,
    results/asic_ppa_verified_subset_20261009.md (superseded by _20261010),
    results/board_6c4ccffd_20261009_seed_comparison.md (withdrawn method)
    - references updated in NHAT_KY, PROJECT_STATE, README, WORKSPACE_MAP
    Claude-Session: https://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
2026-10-15 NHAT_KY.md: restore details lost in the topic rewrite
    A completeness pass compared the topic version with the hour-by-hour
    history (git 35ebf92): 104 candidate omissions, 61 kept after an
    independent filter. Added to sections 1.2, 2, 3, 4, 5, 6, 7, 8.1-8.4,
    9, 10 and 11: baseline PPA and antenna figures of the 1 KiB milestone,
    the first 4 KiB matrix, floorplan and synthesis-strategy experiments,
    PD knob measurements, LEC multiplier mechanism, power-window root cause,
    DM_VC4 routing and antenna analysis, SA2 open directions, owner
    decisions and several tool traps. Every number of the accepted items is
    present; file stays ASCII; the 8a / 9 headings used by the board
    scripts are unchanged.
    Cla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
